jrseti/roboclaw-cm4-dc-dish-controller/README.md

# roboclaw-cm4-dc-dish-controller

A radio astronomy dish controller: a carrier board for a Raspberry Pi Compute
Module 4 (CM4) that commands a Basicmicro **RoboClaw 2x15A OEM** brushed DC motor
controller to drive the dish's azimuth and elevation motors. The board runs from a
12.8 V LiFePO4 battery that can be charged from a solar panel.

The goal is a self-contained observing system that points the dish, gathers data
and stores it for later retrieval and analysis. An SDR, such as an Airspy R2,
plugs into one USB port and an SSD into the other. The CM4 stores the samples
either raw or integrated. Both share one USB 2.0 link (about 35–40 MB/s), so raw
recording works at reduced bandwidth, such as the R2's 2.5 MSPS rate.

Data and control go through the CM4 over Ethernet. A battery-powered fiber media
converter can extend the link to the shack and isolate it electrically.

**Schematic:** [kicad/cm4-robo-controller.pdf](kicad/cm4-robo-controller.pdf)

**Simulations:** [sim/README.md](sim/README.md)

[Tomachie AI](https://tomachie.com) reviewed the schematic. Here is the [review report](tomachie/TomachieReview.pdf). Scored 100/100. Its other outputs are described in [tomachie/](tomachie/README.md).

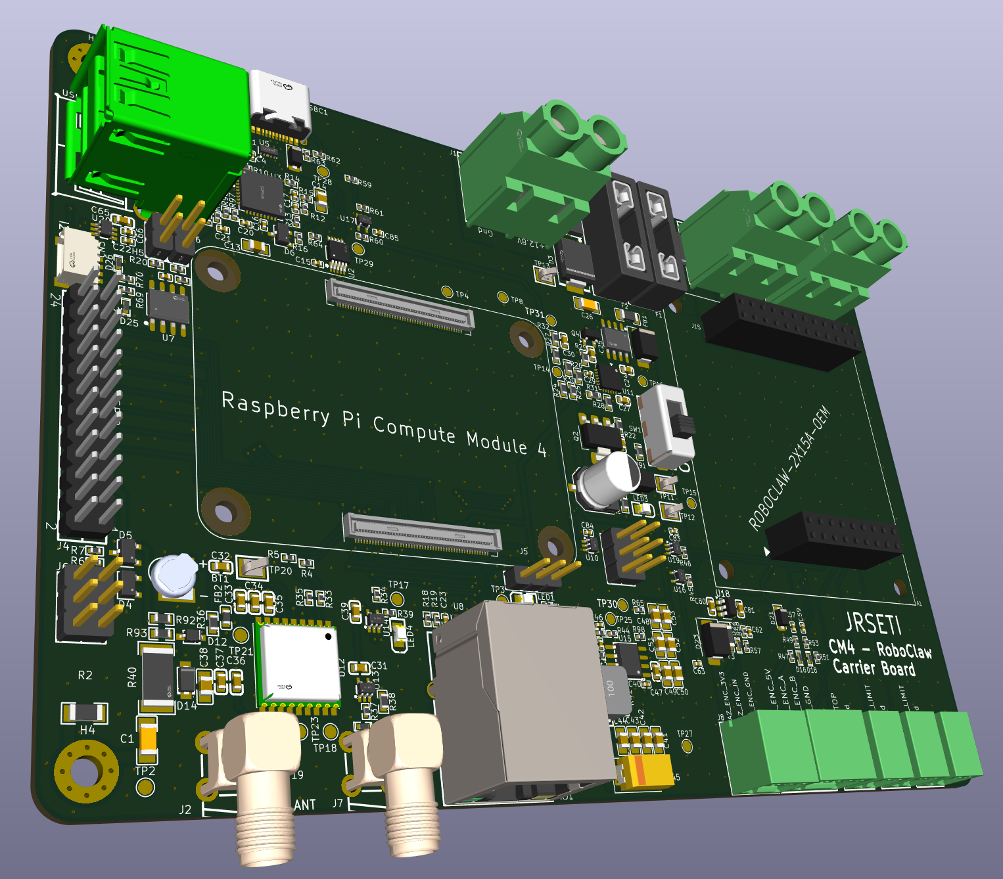
[picture p1: images/pcb-3d.png]
3D render of the controller PCB


## Overview

The board combines two modules:

- **Raspberry Pi CM4**: runs the pointing software and provides networking, USB,
  GPS timing and spare I/O. It plugs into two Hirose mezzanine connectors in the
  middle of the board.
- **RoboClaw 2x15A OEM**: a dual-channel controller for brushed DC motors (not
  brushless, stepper or servo) with closed-loop position and speed control. It
  plugs into two pin-header sockets on the right of the board. The CM4 sends it
  commands over a TTL serial link (RoboClaw packet serial).

The CM4 decides where the dish should point. The RoboClaw reads the axis sensors
and runs the motor control loops.

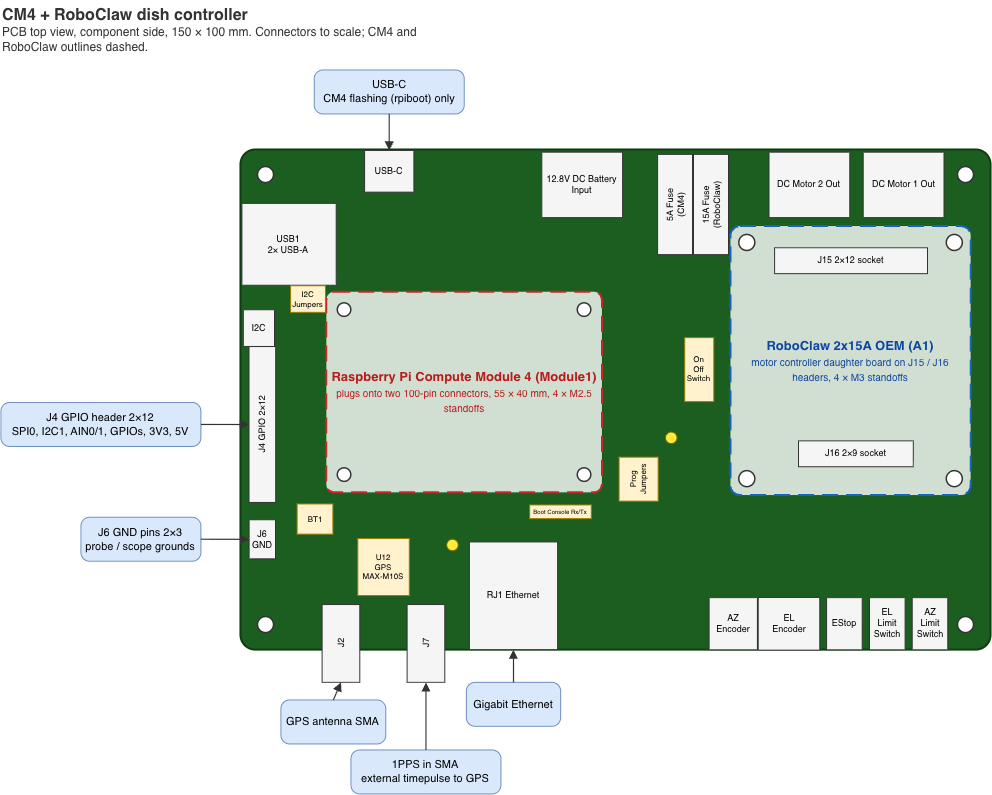
[picture p2: images/FunctionalDiagram.png]
Functional diagram


The functional diagram shows the board's layout: the CM4 on the left, the RoboClaw
on the right, and the field connections along the edges. Its source is
`drawings/FunctionalDiagram.drawio`.

## Motors and axis sensing

| Axis | Motor | Position sensor | RoboClaw input |
|---|---|---|---|
| Elevation (M1) | Firgelli F-SD-H-450-12V linear actuator (5.5 A max, 450 lb) | Built-in Hall sensors, quadrature A/B | EN1 (J8) |
| Azimuth (M2) | Bringsmart JGY-370 12 V worm-gear motor (1.8 A max) | AS5600 magnetic angle sensor, analog output | EN2 (J9) |

Both encoder channels are identical and jumper-configurable, so either axis can
use a quadrature encoder (the Firgelli Hall sensors, or an Omron E6B2-CWZ6C
open-collector encoder) or an absolute analog encoder (0–2 V at the RoboClaw).
Each 4-pin connector carries V+, A (or the analog signal), B and GND, with ESD
clamps on both signals.

| Jumper (ENC1 / ENC2) | Shunt | Setting |
|---|---|---|
| JP1 / JP4 — sensor supply (2x3, shunt across a row) | 1-2 | 5 V from the RoboClaw BEC (RC_5V) through F6 / F7, 200 mA PTC |
| | 3-4 | 3.3 V from the on-board LDO U18 (ENC_3V3) |
| | 5-6 | Battery voltage, 10–14.6 V (ENC_12V: V_MOTOR via a 350 mA PTC, SMAJ20A clamp), e.g. for an E6B2-CWZ6C |
| JP2 / JP5 — mode (2x3) | 1-3 + 2-4 | QUAD: A gets a 1k pull-up to 5 V and a 100R/10nF filter; B always does |
| | 3-5 + 4-6 | ABS: A goes to the analog node (100k/100nF); the pull-up is disconnected |
| JP3 / JP6 — ABS scaling | 1-2 | 68k/100k divider (×0.6) for a 3.3 V sensor such as the AS5600 |
| | 2-3 | 1k series, for a source that already outputs 0–2 V |

Default fit: ENC1 = 5 V, QUAD (Firgelli); ENC2 = 3.3 V, ABS, 3.3 V scaling (AS5600).

[docs/encoder-inputs.md](docs/encoder-inputs.md) explains, part by part, how the
channel handles each encoder type: the E6B2-CWZ6C's NPN open-collector outputs,
the Firgelli Hall quadrature, and an absolute 0–2 V encoder such as the AS5600.

| Elevation: Firgelli F-SD-H-450 linear actuator | Azimuth: Bringsmart JGY-370 worm-gear motor |
|:---:|:---:|
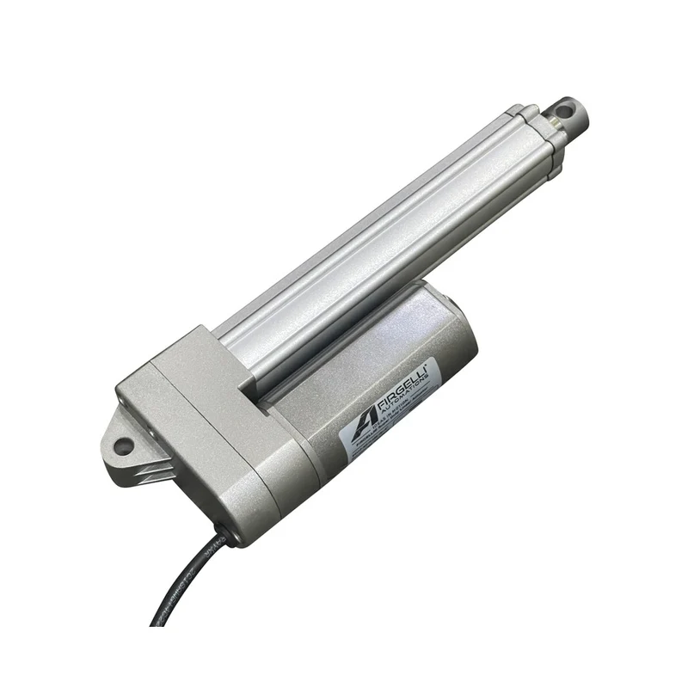
[picture p3: images/elevation_actuator.png]
Firgelli F-SD-H-450 linear actuator
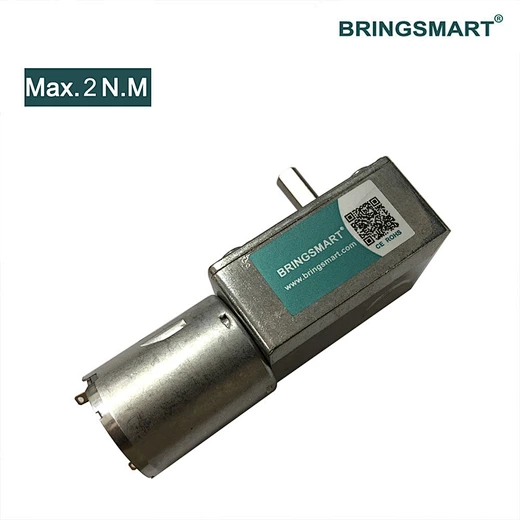
[picture p4: images/azimuth_motor.png]
Bringsmart JGY-370 worm-gear motor
|  |  |

- **Elevation:** the actuator's Hall outputs (J8, JP2 in QUAD) are pulled up to
  the sensor supply (JP1 = 5 V), ESD-protected and RC-filtered before they reach
  EN1. The count is incremental, so the axis is homed at start-up.
- **Azimuth:** the AS5600 (J9, JP5 in ABS) gives an absolute angle as a 0–3.3 V
  signal. The 68k/100k divider (JP6 1-2) scales it to the RoboClaw's 0–2 V
  absolute-encoder input, so no homing is needed.
- **Switch inputs:** E-stop (J10 → S3), elevation limit (J12 → S4) and azimuth
  limit (J13 → S5). All use normally-closed switches and have ESD protection and
  filtering. The RoboClaw has one limit input per motor but supports two switches
  on it: wire the forward and reverse NC switches in series on J12/J13 (either
  one opening trips the input), set Invert, and set S4/S5 to *Limit (Both)* or
  *Home (User)/Limit (Fwd)* — the latter also zeroes the encoder against the
  reverse-end switch, which is how the elevation axis homes. All three switch
  loops run at battery voltage (ENC_12V, 4.7k pull-up, about 2.6 mA through the
  contacts for wetting on long cables) and a 47k/20k divider brings the
  open-switch 10–14.6 V down to 3.0–4.4 V at the RoboClaw pins.
- **Motor outputs:** J11 and J14, both 7.62 mm screw terminals.

The `Motor Notes` schematic sheet describes the sensor wiring and RoboClaw setup in
detail.

## Power

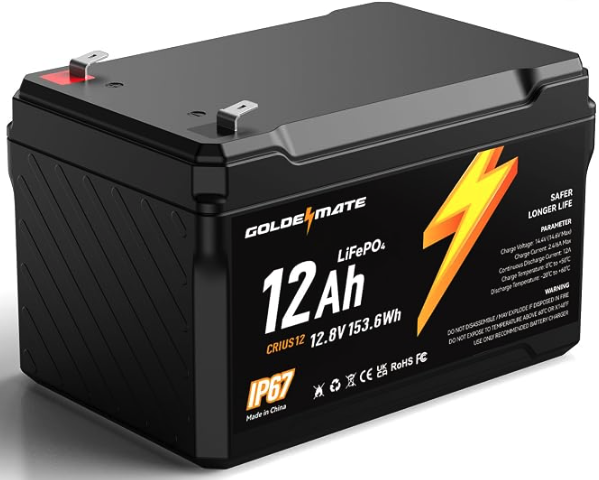
[picture p5: images/battery.png]
GoldenMate CRIUS12 12.8 V 12 Ah LiFePO4 battery


- **Input:** a 12.8 V, 12 Ah LiFePO4 battery (10.0–14.6 V) on J1, a 7.62 mm screw
  terminal. The battery is a GoldenMate CRIUS12, IP67 rated, and sits inside the
  enclosure. Its manual is in `docs/`.
- **Reverse-polarity protection:** a P-channel MOSFET (Q1) on the input blocks a
  battery connected backwards. It still conducts in both directions in normal use,
  so motor regenerative braking can return energy to the battery.
- **Fuses:** two ATO blade fuses split the supply:
  - F1 (15 A) feeds the RoboClaw motor supply (V_MOTOR).
  - F2 (5 A) feeds the logic branch.
  - D29 (SS54, 5 A Schottky, next to F1 above D1) sits across F1 as the return
    path for RoboClaw regenerative current when F1 is open, as the RoboClaw data
    sheet recommends. A fault that blows F1 pulls V_MOTOR low, so D29 cannot
    bypass the fuse.

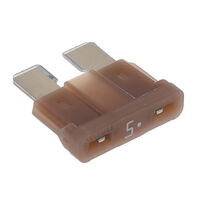
[picture p6: images/fuse.jpg]
5 A ATO automotive blade fuse
  

  These are ordinary automotive blade fuses, the kind sold for car wiring. They are
  cheap and available almost anywhere. They plug into Keystone 3557-2 holders, so a
  blown fuse can be replaced in the field without tools. The board uses Littelfuse
  0287005.PXCN (5 A) and 0287015.PXCN (15 A), but any ATO/ATC fuse of the same
  rating fits.

  Q1 is the main protection against a reversed battery. A healthy Q1 blocks the
  reverse voltage, and no fuse should blow. The fuses are the backup. If Q1 has
  failed shorted, the reversed battery drives current forward through the input TVS diodes (D1, D3) and the
  RoboClaw's internal diodes. That current passes through F1 and F2, and the fuses
  are what stop it. A blown fuse after connecting the battery therefore means:
  check the polarity, and check Q1, before you fit a new fuse.

  The fuses do not cover every reverse fault. If board ground is also connected to
  the battery's negative terminal by another route, such as a USB device or other
  equipment that shares the battery, reverse current can flow through the ground
  wiring and bypass both Q1 and the fuses. 
- **Logic supply:** the logic branch goes through a hot-swap eFuse (U11), a power
  switch (SW1) and a 5 A buck converter (U15). The buck makes 5 V for the CM4 and the
  USB ports. The CM4's own 3.3 V output powers the 3.3 V logic.
- **SW1 is not a battery disconnect.** It switches the CM4 and logic supply only.
  With SW1 off the board still draws about 31 mA from the battery: about 30 mA for
  the RoboClaw's logic, which runs straight from V_MOTOR, plus about 1.3 mA for U11
  and its dividers. A full 12 Ah battery runs flat in about 16 days. For storage or
  transport, unplug J1 (or pull F1 and F2), and charge the battery first. A LiFePO4
  battery left at its BMS cutoff for months loses capacity.
- **Grounding:**
  - Motor return current stays on a separate ground (PGND). It joins the logic
    ground at a single point (NT1) next to the battery terminal.
  - Connector shields and mounting holes go to CHASSIS, which is bled to ground
    through 1 MΩ in parallel with 4.7 nF.
  - Once installed, GND is bonded to the utility box at the J2 antenna
    arrestor, the only intended GND-to-box connection. Battery negative
    already reaches the box through the board this way, so neither it nor
    the negative of anything else on the battery may have any other
    connection to the box or the mounting plate.
  - The optional FE-5680A rubidium reference (1PPS into J7) is mounted
    isolated from the plate and powered through an isolated DC-DC
    converter, so its only connection to the board is the J7 coax shield.
  - The SDR's antenna coax shield reaches board GND through its USB cable. Bring
    that coax in next to the J2 arrestor, or isolate its shield from the box, so
    it does not make a second GND-to-box bond.

## CM4 interfaces

- **Ethernet:** gigabit RJ45 with integrated magnetics. The PHY is on the CM4.
- **USB:**
  - A USB2514B hub drives a dual USB-A port, with current limiting and ESD
    protection. The hub's ports 3 and 4 are not used and are disabled by strap.
  - A USB mux switches the CM4's USB port to the USB-C connector for `rpiboot`
    (OTG programming of the eMMC).
- **GPS:**
  - A u-blox MAX-M10S receiver provides UTC time and a 1PPS pulse. Its antenna
    connects to an SMA jack, and a coin cell backs up the receiver for fast restarts.
  - A second SMA input accepts an external 1PPS reference, such as an FE-5680A
    rubidium clock.
- **GPIO header (J4):** spare CM4 GPIOs and two protected analog inputs. The
  3.3 V on pin 5 is fused at 100 mA (F9); the 5 V on pin 7 is not.
  Two on-axis E6B2-CWZ6C encoders can be read here, see
  [On-axis encoders on J4](docs/encoder-inputs.md#on-axis-encoders-on-j4-cm4).
  H7, an M2.5 hole next to J4, secures a plug-on HAT board; see
  [Mounting a HAT board on J4](docs/encoder-inputs.md#mounting-a-hat-board-on-j4).
- **Jumpers:** boot control, EEPROM write protect and self power-cycle.
- **Boot console UART (J5):** a serial console on the CM4's UART0. See below.

### Boot console UART (J5)

J5 is a 3-pin, 2.54 mm header that brings out the CM4's UART0. It shows bootloader
and Linux boot messages and gives a login prompt. That makes it the way into the
board when the network is down or the CM4 won't boot.

| J5 pin | Signal | Connect to the adapter's |
|---|---|---|
| 1 | BOOT_CONSOLE_RXD (GPIO15, CM4 receives) | TXD |
| 2 | BOOT_CONSOLE_TXD (GPIO14, CM4 transmits) | RXD |
| 3 | GND | GND |

TX and RX cross over: the adapter's TXD goes to the CM4's RXD.

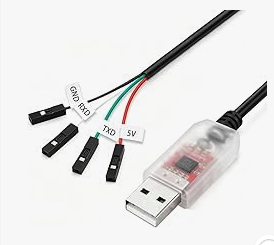
[picture p7: images/TTL-Serial-cable.png]
USB to TTL serial cable with four female jumper leads


Any inexpensive USB-to-TTL serial cable works. Cables like the one shown, based on
the PL2303, CP2102 or FTDI chips, cost a few dollars on Amazon. They usually have
four female jumper leads: black GND, white RXD, green TXD and red 5V. Check the
labels on your cable.

- **Do not connect the red 5V lead.** The board powers itself, and J5 has no 5 V
  pin. A loose 5 V lead can short against the header or the board, so it's best
  to cut it off, or at least insulate it.
- **Use a cable with 3.3 V signals.** The CM4's GPIOs are not 5 V tolerant. Before
  connecting, check with a meter that the adapter's TXD idles at about 3.3 V.
- **Settings:** 115200 baud, 8N1, no flow control.
- **Enabling the console:**
  - For the Linux console, add `enable_uart=1` to `config.txt`. Raspberry Pi OS
    already puts `console=serial0,115200` in `cmdline.txt`.
  - For bootloader messages, set `BOOT_UART=1` in the EEPROM config with
    `rpi-eeprom-config`.

### Recommended CM4

Use a **CM4 without wireless and with eMMC**, for example `CM4004032` (4 GB RAM,
32 GB eMMC) or `CM4004016` (16 GB eMMC).

- The board has no SD-card slot, so a CM4 Lite (part numbers ending `000`) cannot
  boot on it.
- On a wireless CM4, Bluetooth takes UART0, which this board uses.

## Board

- 4-layer PCB, 150 × 90 mm, with four M3 mounting holes.
- Assembled on one side by JLCPCB. Parts carry LCSC part numbers. The RoboClaw
  (A1) and the CM4 (A2) are DNP: bought separately and fitted by hand. The two
  Hirose DF40 receptacles under the CM4 are J17/J18, BOM and placement entries
  only, since their pads are part of the CM4 footprint.
- The RoboClaw sits in sockets (J15/J16) so it can be removed. Nothing is placed
  under the CM4 or the RoboClaw.
- The inner layers are planes:
  - In1.Cu is ground, split into logic GND and PGND.
  - In2.Cu carries power: +5 V on the logic side, V_MOTOR on the RoboClaw side.

## Status

The schematic is complete. PCB placement and plane layout are done, and routing is
in progress. The software has not been started yet.

## Repository layout

| Path | Contents |
|---|---|
| `kicad/` | KiCad 10 project: schematic sheets and PCB |
| `parts/` | Git submodule ([jrseti/parts](https://github.com/jrseti/parts)): the `MyParts` symbol, footprint and 3D-model library, its datasheets, and `add.py` for importing LCSC parts |
| `docs/` | Component datasheets and design notes |
| `drawings/` | Draw.io source for the functional diagram |
| `tomachie/` | Tomachie schematic review: report PDF, BOM, netlist, power tree and marked-up sheets ([README](tomachie/README.md)) |
| `images/` | Images used in this README |
| `software/` | CM4 software (not yet started) |

### Cloning

`parts/` is a submodule, and the KiCad project needs it to find its symbols,
footprints and 3D models. Clone with:

```sh
git clone --recurse-submodules https://github.com/jrseti/roboclaw-cm4-dc-dish-controller.git
```

If you have already cloned the repository, run `git submodule update --init` to
fetch it.

KiCad finds the library through two path variables. Set them in
**Preferences → Configure Paths**:

| Variable | Value |
|---|---|
| `MYPARTS` | `<clone>/parts` |
| `MYPARTS_DATASHEETS` | `<clone>/parts/datasheets` |

## License

MIT. See [LICENSE](LICENSE).
