jrseti/roboclaw-cm4-dc-dish-controller/sim/power/README.md

# Power-sheet simulations (ngspice)

Test circuits for the logic power path on the power sheet (`kicad/power.kicad_sch`):
- the U11 eFuse (MX26631DL) with its UVLO, OVP and PGOOD dividers;
- the Q3/Q4 reverse-current blocking FETs;
- the SW1/Q2 power switch, with its slow turn-on (R22, R91, C82), and the 12V rail.

The battery and battery-input stage feed it. The U15 buck is modelled as a
load; [../power-5v](../power-5v) covers it in detail. The write-up is
[../power.md](../power.md).

```sh
brew install ngspice
./run.sh                 # writes results/*.log and results/*.dat
python3 plot.py          # needs matplotlib; writes results/*.png
python3 circuit.py       # needs schemdraw; writes results/circuit.png
```

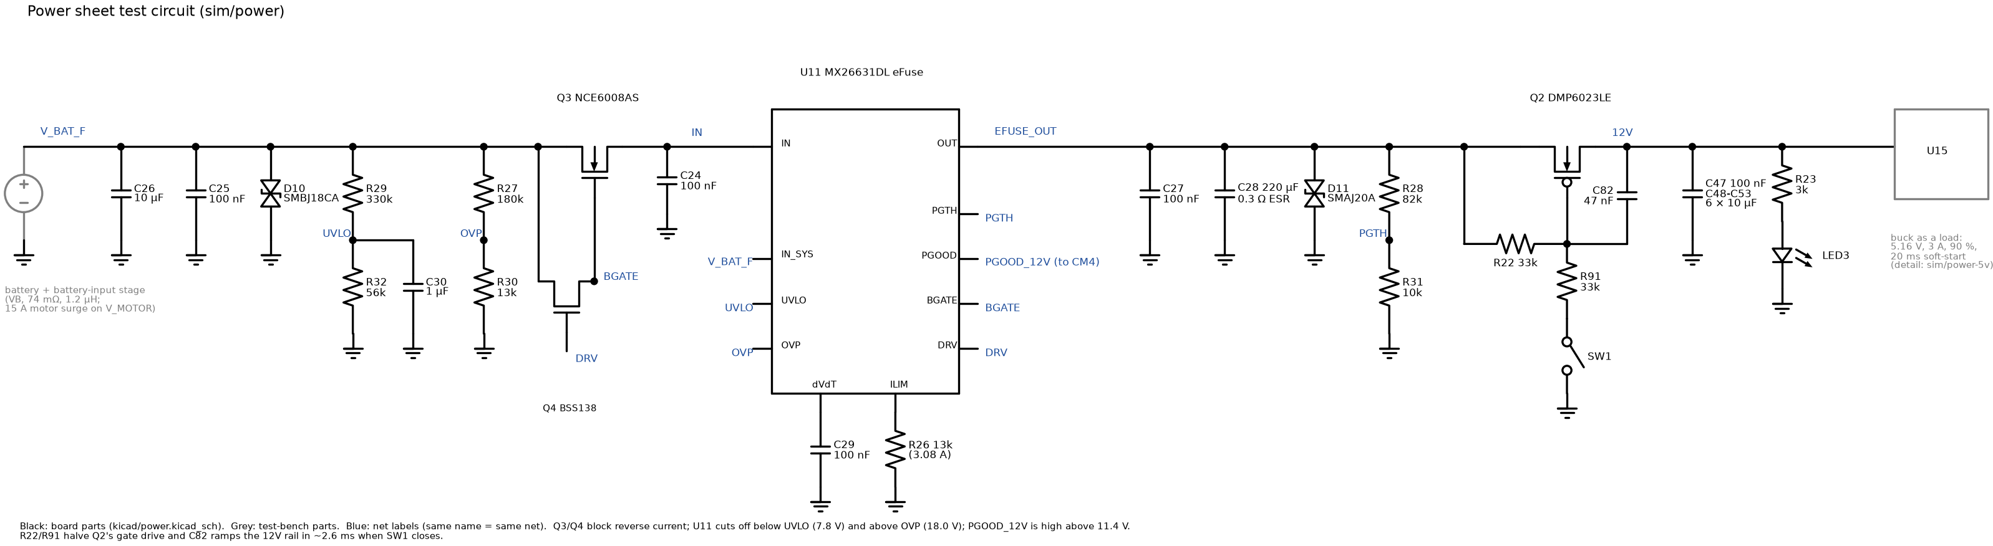
[picture p10: sim/power/results/circuit.png]
Test circuit


| File | Contents |
|---|---|
| `models.lib` | MOSFET and TVS models, a behavioural U11 eFuse (`MX26631`) and the buck-as-a-load (`BUCKLOAD`) |
| `board.inc` | The power-sheet netlist, shared by every test. `QSOFT=1` is the board as built (R22 33k, R91 33k, C82 47 nF); `QSOFT=0` is the earlier design, kept for comparison. |
| `source.inc` | Battery, cable and battery-input stage feeding V_BAT_F, plus the RoboClaw motor current |
| `startup.cir` | A full battery plugged in with SW1 already on |
| `sw1.cir` | SW1 switched on with U11 already up, earlier design and as built |
| `brownout.cir` | A 15 A, 300 ms motor surge at battery voltages of 12.8, 12.0 and 11.4 V |
| `ovp.cir` | The battery rail held at 21.5 V for 100 ms (braking with the BMS open), then released. Also measures Q2's gate-source voltage, earlier design and as built. |
| `circuit.py` | Draws the circuit above |

**Assumptions:**
- Battery: 25 mΩ. Cable: 17 mΩ and 1 µH. Q1: 5 mΩ. F2: 17 mΩ. FB1: 9 mΩ.
- C26 is derated to 5 µF. C48–C53 are derated to 5 µF each.
- C28 is 220 µF with 0.3 Ω ESR (assumed; the datasheet gives no ESR).
- The buck load is 5.16 V at 3 A, 90 % efficient, with a 20 ms soft-start.
- RoboClaw input capacitance: 470 µF.

**The U11 model** reproduces the datasheet's thresholds, delays, dV/dt
ramp, current limit (3.08 A), PGOOD deglitch and reverse blocking.

It doesn't model:
- thermal shutdown;
- the 1.5 × IOL fast trip. The model clamps the current at IOL instead, and
  reports what the load is asking for as `xu11.idem`.

## Results

| Test | Result |
|---|---|
| Start-up | UVLO trips 50 ms after plug-in (C30 filter). U11 turns on 9 ms later and EFUSE_OUT ramps at 0.53 V/ms. PGOOD goes high at 81 ms, 5V is in regulation at 88 ms. The eFuse current never exceeds the 1.4 A load. |
| SW1 on, earlier design | Q2 surges to 63 A (above its 50 A pulse rating), EFUSE_OUT dips to 4.3 V and is below the PGOOD threshold for 17 µs, so PGOOD drops for 2 ms. The load asks U11 for far more than 1.5 × IOL, so a real U11 would fast-trip. |
| SW1 on, as built | With R22 33k, R91 33k in series with SW1 and C82 47 nF gate-to-drain, the surge is 1.4 A, EFUSE_OUT doesn't move, and PGOOD stays high. The 12V rail rises in 2.6 ms. |
| Brownout | During a 15 A surge, EFUSE_OUT falls about 0.9 V. PGOOD stays high at 12.8 V and 12.0 V. At 11.4 V it never comes up, because EFUSE_OUT (11.2 V) is below the 11.41 V rising threshold. |
| OVP | U11 cuts off within microseconds of the rail passing 17.96 V. The 5V rail falls below 4.75 V 1.8 ms later, so the CM4 resets. It's back 35 ms after the rail drops below 16.78 V. Q2's gate-source voltage peaks at −7.8 V as built (R22/R91 halve it), against −17.8 V for the earlier design; the rating is ±20 V. |
