jrseti/roboclaw-cm4-dc-dish-controller/docs/drawings/board_overview.png

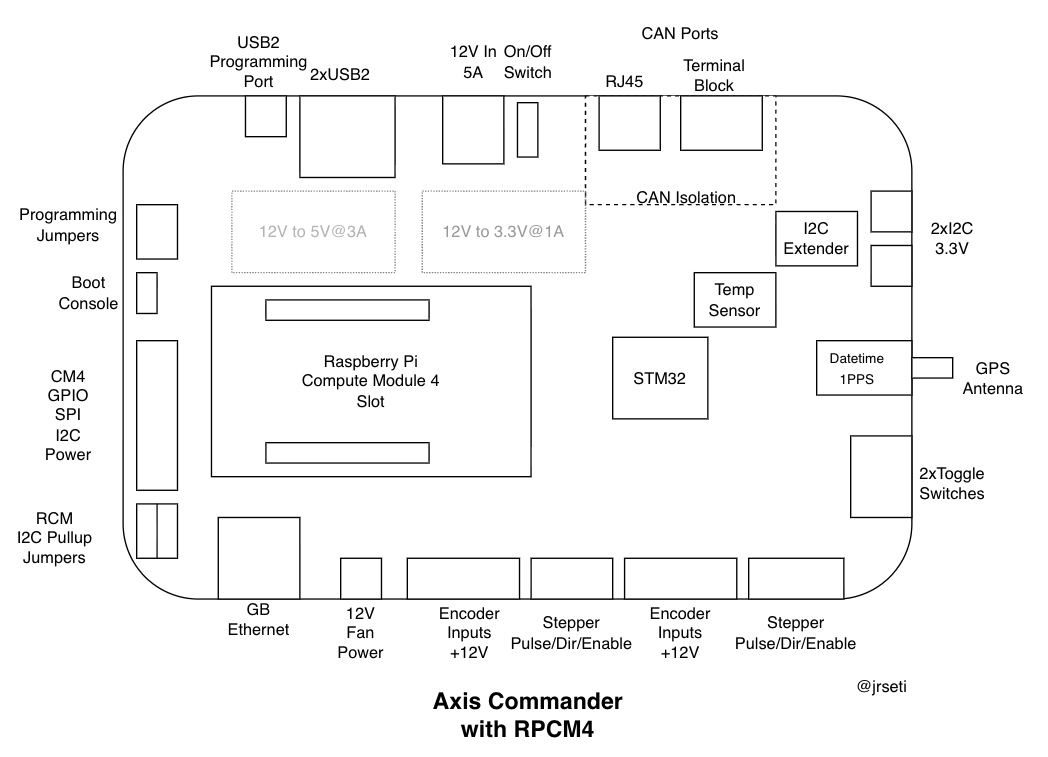
docs/drawings/board_overview.png
