jrseti/roboclaw-cm4-dc-dish-controller/docs/drawings/board_overview_colors.png

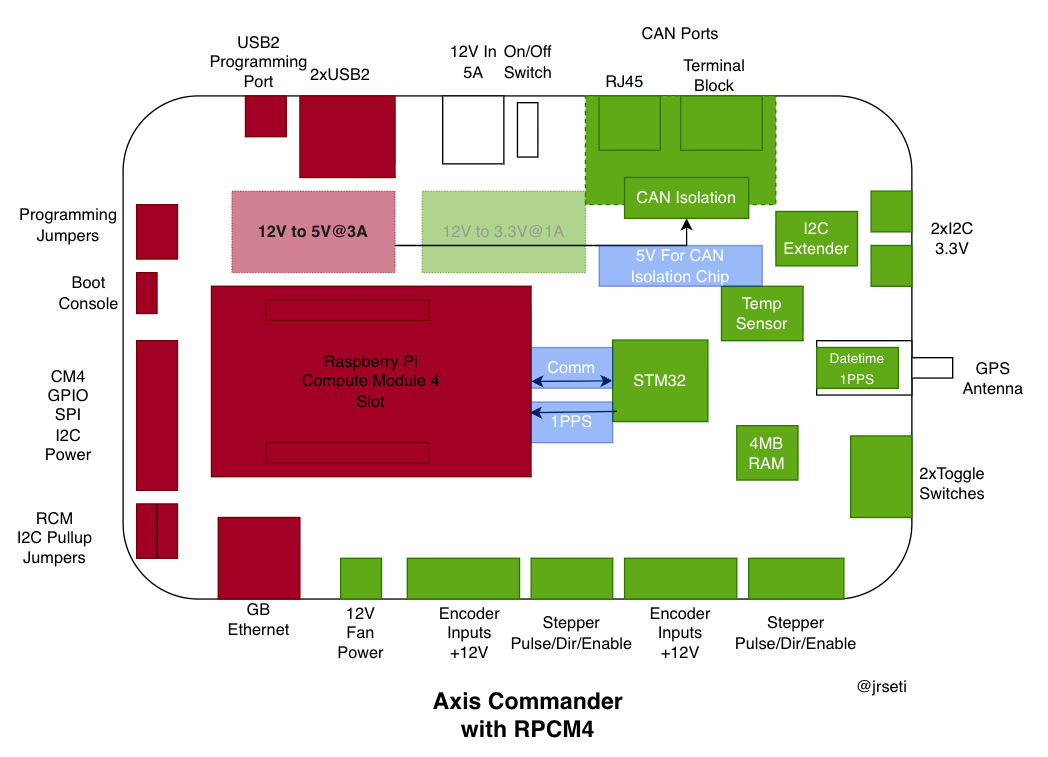
docs/drawings/board_overview_colors.png
