jrseti/roboclaw-cm4-dc-dish-controller/docs/drawings/encoder_CAN.png

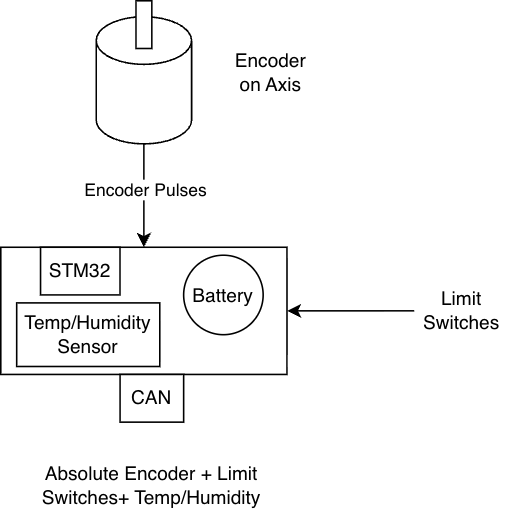
docs/drawings/encoder_CAN.png
