jrseti/roboclaw-cm4-dc-dish-controller/docs/drawings/rcm_dish_controller_1.png

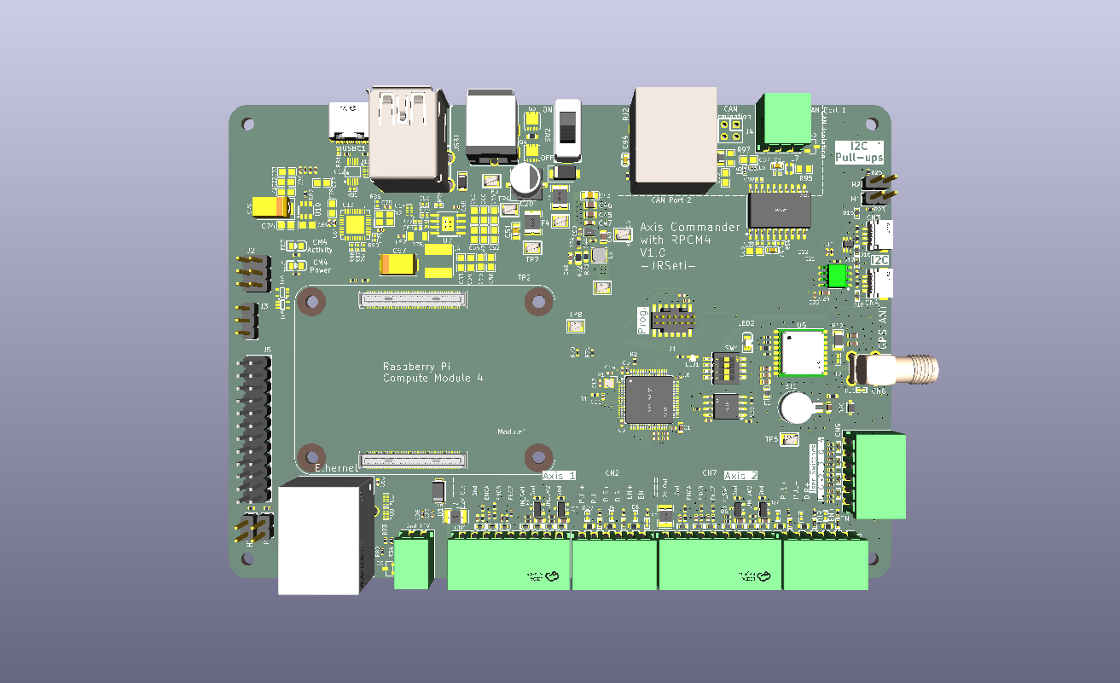
docs/drawings/rcm_dish_controller_1.png
