jrseti/roboclaw-cm4-dc-dish-controller/docs/ring_holder_1_v6.step

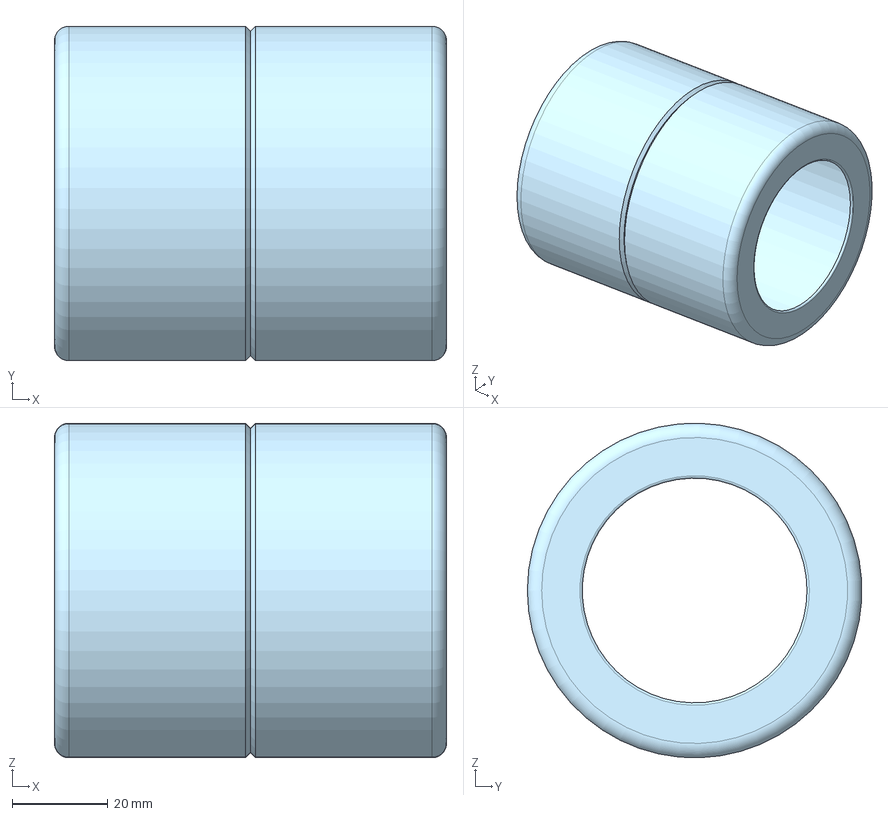
[picture p35: CAD file, 2026-10-09]
docs/ring_holder_1_v6.step
82.0 x 69.9 x 70.0 mm
