jrseti/roboclaw-cm4-dc-dish-controller/docs/ring_holder_1_v5.step

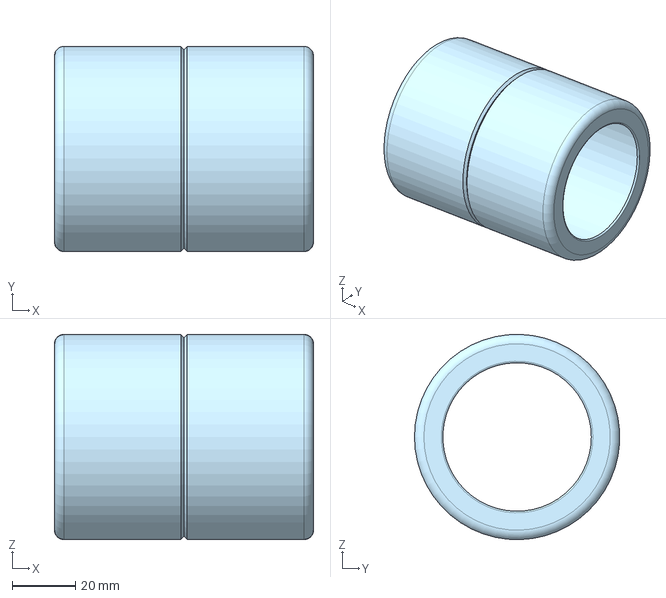
[picture p36: CAD file, 2026-10-09]
docs/ring_holder_1_v5.step
82.0 x 64.9 x 65.0 mm
