jrseti/roboclaw-cm4-dc-dish-controller/kicad/cm4-robo-controller.kicad_pcb

## KiCad design kicad/cm4-robo-controller.kicad_pcb (2026-11-11)

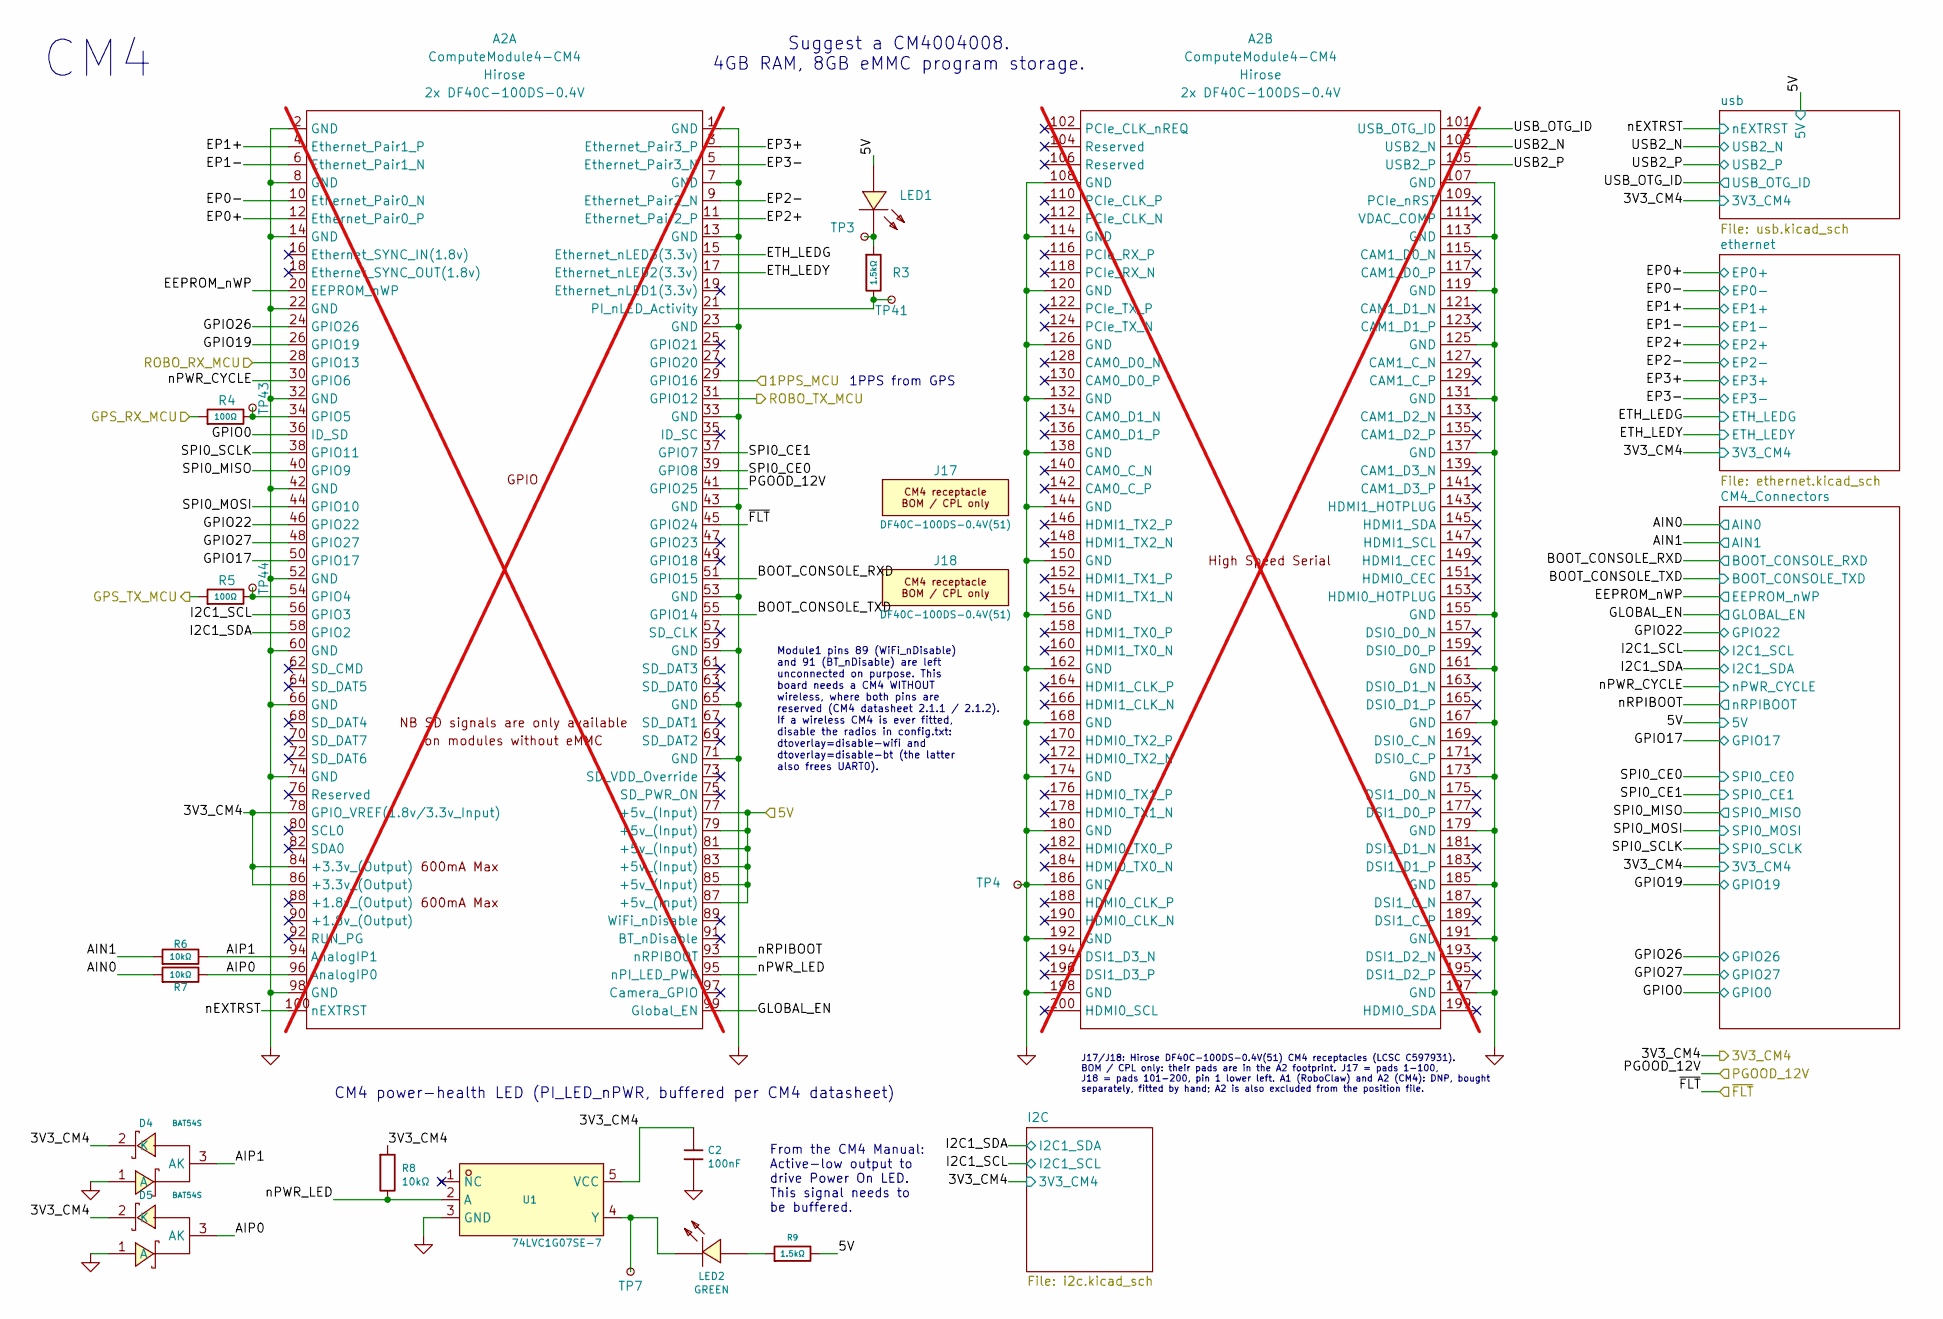
[picture p52: schematic RCM4.kicad_sch]

Parts:
A2: ComputeModule4-CM4; Raspberry-Pi-4-Compute-Module; MPN CM4004008; not fitted
C2: 100nF; CAPC1005X55N; Tolerance ±10%; Voltage Rating 16V; MPN CL05B104KO5NNNC; LCSC Part C1525
D4, D5: BAT54S; SOT95P280X110-3N; MPN BAT54S,215; LCSC Part C47546
J17, J18: DF40C-100DS-0.4V(51); DF40C-100DS-0.4V_BOM-ONLY; MPN DF40C-100DS-0.4V(51); LCSC Part C597931
LED1: GREEN; LEDC2012X110N; MPN KT-0805G; LCSC Part C2297
LED2: GREEN; LEDC2012X110N; MPN KT-0805R; LCSC Part C2295
R3, R9: 1.5kΩ; RESC1005X40N; Tolerance ±1%; Voltage Rating 50V; MPN 0402WGF1501TCE; LCSC Part C25867
R4, R5: 100Ω; RESC1005X40N; Tolerance ±1%; Voltage Rating 50V; MPN 0402WGF1000TCE; LCSC Part C25076
R6, R7, R8: 10kΩ; RESC1005X40N; Tolerance ±1%; Voltage Rating 50V; MPN 0402WGF1002TCE; LCSC Part C25744
TP3, TP4, TP7, TP41, TP43, TP44: TestPoint_Small; TestPoint_Pad_D0.8mm
U1: 74LVC1G07SE-7; SOT65P210X110-5N; MPN 74LVC1G07SE-7; LCSC Part C67531

Connections:
/3V3_CM4: A2.78 (GPIO_VREF(1.8v/3.3v_Input)), A2.84 (+3.3v_(Output)), A2.86 (+3.3v_(Output)), C2.1, D4.2 (K), D5.2 (K), R8.1, U1.5 (VCC); also elsewhere on the board
/5V: A2.77 (+5v_(Input)), A2.79 (+5v_(Input)), A2.81 (+5v_(Input)), A2.83 (+5v_(Input)), A2.85 (+5v_(Input)), A2.87 (+5v_(Input)), LED1.1 (A), R9.2; also elsewhere on the board
/CM4/1PPS_MCU: A2.29 (GPIO16); also elsewhere on the board
/CM4/AIN0: R7.1; also elsewhere on the board
/CM4/AIN1: R6.1; also elsewhere on the board
/CM4/AIP0: A2.96 (AnalogIP0), D5.3 (AK), R7.2
/CM4/AIP1: A2.94 (AnalogIP1), D4.3 (AK), R6.2
/CM4/BOOT_CONSOLE_RXD: A2.51 (GPIO15); also elsewhere on the board
/CM4/BOOT_CONSOLE_TXD: A2.55 (GPIO14); also elsewhere on the board
/CM4/EEPROM_nWP: A2.20 (EEPROM_nWP); also elsewhere on the board
/CM4/EP0+: A2.12 (Ethernet_Pair0_P); also elsewhere on the board
/CM4/EP0-: A2.10 (Ethernet_Pair0_N); also elsewhere on the board
/CM4/EP1+: A2.4 (Ethernet_Pair1_P); also elsewhere on the board
/CM4/EP1-: A2.6 (Ethernet_Pair1_N); also elsewhere on the board
/CM4/EP2+: A2.11 (Ethernet_Pair2_P); also elsewhere on the board
/CM4/EP2-: A2.9 (Ethernet_Pair2_N); also elsewhere on the board
/CM4/EP3+: A2.3 (Ethernet_Pair3_P); also elsewhere on the board
/CM4/EP3-: A2.5 (Ethernet_Pair3_N); also elsewhere on the board
/CM4/ETH_LEDG: A2.15 (Ethernet_nLED3(3.3v)); also elsewhere on the board
/CM4/ETH_LEDY: A2.17 (Ethernet_nLED2(3.3v)); also elsewhere on the board
/CM4/GLOBAL_EN: A2.99 (Global_EN); also elsewhere on the board
/CM4/GPIO0: A2.36 (ID_SD); also elsewhere on the board
/CM4/GPIO17: A2.50 (GPIO17); also elsewhere on the board
/CM4/GPIO19: A2.26 (GPIO19); also elsewhere on the board
/CM4/GPIO22: A2.46 (GPIO22); also elsewhere on the board
/CM4/GPIO26: A2.24 (GPIO26); also elsewhere on the board
/CM4/GPIO27: A2.48 (GPIO27); also elsewhere on the board
/CM4/GPS_RX_MCU: R4.1; also elsewhere on the board
/CM4/GPS_TX_MCU: R5.1; also elsewhere on the board
/CM4/I2C1_SCL: A2.56 (GPIO3); also elsewhere on the board
/CM4/I2C1_SDA: A2.58 (GPIO2); also elsewhere on the board
/CM4/PGOOD_12V: A2.41 (GPIO25); also elsewhere on the board
/CM4/ROBO_RX_MCU: A2.28 (GPIO13); also elsewhere on the board
/CM4/ROBO_TX_MCU: A2.31 (GPIO12); also elsewhere on the board
/CM4/SPI0_CE0: A2.39 (GPIO8); also elsewhere on the board
/CM4/SPI0_CE1: A2.37 (GPIO7); also elsewhere on the board
/CM4/SPI0_MISO: A2.40 (GPIO9); also elsewhere on the board
/CM4/SPI0_MOSI: A2.44 (GPIO10); also elsewhere on the board
/CM4/SPI0_SCLK: A2.38 (GPIO11); also elsewhere on the board
/CM4/USB2_N: A2.103 (USB2_N); also elsewhere on the board
/CM4/USB2_P: A2.105 (USB2_P); also elsewhere on the board
/CM4/USB_OTG_ID: A2.101 (USB_OTG_ID); also elsewhere on the board
/CM4/nEXTRST: A2.100 (nEXTRST); also elsewhere on the board
/CM4/nPWR_CYCLE: A2.30 (GPIO6); also elsewhere on the board
/CM4/nPWR_LED: A2.95 (nPI_LED_PWR), R8.2, U1.2 (A)
/CM4/nRPIBOOT: A2.93 (nRPIBOOT); also elsewhere on the board
/CM4/~FLT: A2.45 (GPIO24); also elsewhere on the board
GND: A2.1 (GND), A2.2 (GND), A2.7 (GND), A2.8 (GND), A2.13 (GND), A2.14 (GND), A2.22 (GND), A2.23 (GND), A2.32 (GND), A2.33 (GND), A2.42 (GND), A2.43 (GND), A2.52 (GND), A2.53 (GND), A2.59 (GND), A2.60 (GND), A2.65 (GND), A2.66 (GND), A2.71 (GND), A2.74 (GND), A2.98 (GND), A2.107 (GND), A2.108 (GND), A2.113 (GND), A2.114 (GND), A2.119 (GND), A2.120 (GND), A2.125 (GND), A2.126 (GND), A2.131 (GND), A2.132 (GND), A2.137 (GND), A2.138 (GND), A2.144 (GND), A2.150 (GND), A2.155 (GND), A2.156 (GND), A2.161 (GND), A2.162 (GND), A2.167 (GND), A2.168 (GND), A2.173 (GND), A2.174 (GND), A2.179 (GND), A2.180 (GND), A2.185 (GND), A2.186 (GND), A2.191 (GND), A2.192 (GND), A2.197 (GND), A2.198 (GND), C2.2, D4.1 (A), D5.1 (A), TP4.1 (1_1), U1.3 (GND); also elsewhere on the board
unnamed: A2.54 (GPIO4), R5.2, TP44.1 (1_1)
unnamed: A2.34 (GPIO5), R4.2, TP43.1 (1_1)
unnamed: A2.21 (PI_nLED_Activity), R3.2, TP41.1 (1_1)
unnamed: LED1.2 (K), R3.1, TP3.1 (1_1)
unnamed: LED2.1 (A), R9.1
unnamed: LED2.2 (K), TP7.1 (1_1), U1.4 (Y)

Notes on the sheet:
CM4 power-health LED (PI_LED_nPWR, buffered per CM4 datasheet)
J17/J18: Hirose DF40C-100DS-0.4V(51) CM4 receptacles (LCSC C597931). BOM / CPL only: their pads are in the A2 footprint. J17 = pads 1-100, J18 = pads 101-200, pin 1 lower left. A1 (RoboClaw) and A2 (CM4): DNP, bought separately, fitted by hand; A2 is also excluded from the position file.
Module1 pins 89 (WiFi_nDisable) and 91 (BT_nDisable) are left unconnected on purpose. This board needs a CM4 WITHOUT wireless, where both pins are reserved (CM4 datasheet 2.1.1 / 2.1.2). If a wireless CM4 is ever fitted, disable the radios in config.txt: dtoverlay=disable-wifi and dtoverlay=disable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
CM4
Suggest a CM4004008. 4GB RAM, 8GB eMMC program storage.
From the CM4 Manual: Active-low output to drive Power On LED. This signal needs to be buffered.
1PPS from GPS

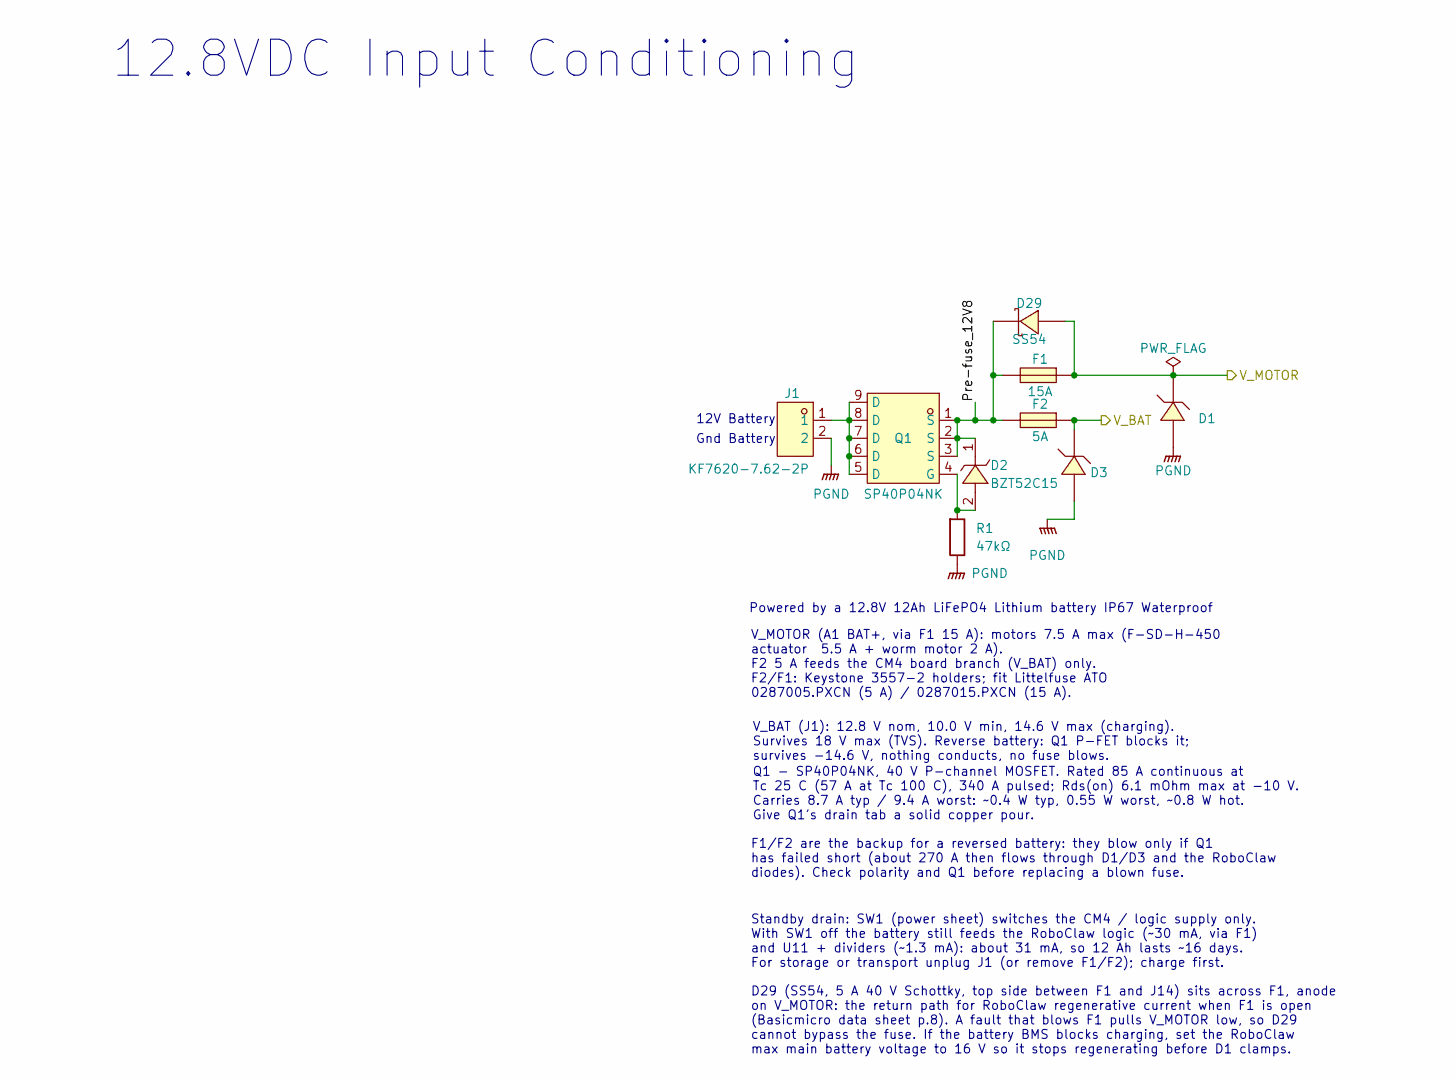
[picture p53: schematic battery-input.kicad_sch, Battery Input]

Parts:
D1, D3: SMCJ18A_C53260906; DIOM7959X262N; MPN SMCJ18A; LCSC Part C53260906
D2: BZT52C15; SOD3716X135N; MPN BZT52C15; LCSC Part C19077412
D29: SS54; DIOM5226X244N; MPN SS54; LCSC Part C22452
F1: 15A; FUSE-TH_4P-L19.8-W6.7_3557-2; Voltage Rating 32VDC; Interrupting Rating 1000A @ 32VDC; MPN 3557-2; LCSC Part C352820
F2: 5A; FUSE-TH_4P-L19.8-W6.7_3557-2; Voltage Rating 32VDC; Interrupting Rating 1000A @ 32VDC; MPN 3557-2; LCSC Part C352820
J1: KF7620-7.62-2P; CONN-TH_P7.62_KF7620-7.62-2P; MPN KF7620-7.62-2P; LCSC Part C475104
Q1: SP40P04NK; SON127P600X500X110-9N; MPN SP40P04NK; LCSC Part C41355035
R1: 47kΩ; RESC1005X40N; Tolerance ±1%; Voltage Rating 50V; MPN 0402WGF4702TCE; LCSC Part C25792

Connections:
/Robo/V_MOTOR: D1.1 (C), D29.2 (A), F1.1, F1.2; also elsewhere on the board
/battery-input/Pre-fuse_12V8: D2.1 (K), D29.1 (K), F1.3, F1.4, F2.3, F2.4, Q1.1 (S), Q1.2 (S), Q1.3 (S)
/battery-input/V_BAT: D3.1 (C), F2.1, F2.2; also elsewhere on the board
unnamed: D2.2 (A), Q1.4 (G), R1.1
unnamed: J1.1, Q1.5 (D), Q1.6 (D), Q1.7 (D), Q1.8 (D), Q1.9 (D)
PGND: D1.2 (A), D3.2 (A), J1.2, R1.2; also elsewhere on the board

Notes on the sheet:
Gnd Battery
12.8VDC Input Conditioning
V_MOTOR (A1 BAT+, via F1 15 A): motors 7.5 A max (F-SD-H-450 actuator 5.5 A + worm motor 2 A). F2 5 A feeds the CM4 board branch (V_BAT) only. F2/F1: Keystone 3557-2 holders; fit Littelfuse ATO 0287005.PXCN (5 A) / 0287015.PXCN (15 A).
12V Battery
D29 (SS54, 5 A 40 V Schottky, top side between F1 and J14) sits across F1, anode on V_MOTOR: the return path for RoboClaw regenerative current when F1 is open (Basicmicro data sheet p.8). A fault that blows F1 pulls V_MOTOR low, so D29 cannot bypass the fuse. If the battery BMS blocks charging, set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
Standby drain: SW1 (power sheet) switches the CM4 / logic supply only. With SW1 off the battery still feeds the RoboClaw logic (~30 mA, via F1) and U11 + dividers (~1.3 mA): about 31 mA, so 12 Ah lasts ~16 days. For storage or transport unplug J1 (or remove F1/F2); charge first.
V_BAT (J1): 12.8 V nom, 10.0 V min, 14.6 V max (charging). Survives 18 V max (TVS). Reverse battery: Q1 P-FET blocks it; survives -14.6 V, nothing conducts, no fuse blows.
F1/F2 are the backup for a reversed battery: they blow only if Q1 has failed short (about 270 A then flows through D1/D3 and the RoboClaw diodes). Check polarity and Q1 before replacing a blown fuse.
Powered by a 12.8V 12Ah LiFePO4 Lithium battery IP67 Waterproof
Q1 - SP40P04NK, 40 V P-channel MOSFET. Rated 85 A continuous at Tc 25 C (57 A at Tc 100 C), 340 A pulsed; Rds(on) 6.1 mOhm max at -10 V. Carries 8.7 A typ / 9.4 A worst: ~0.4 W typ, 0.55 W worst, ~0.8 W hot. Give Q1's drain tab a solid copper pour.

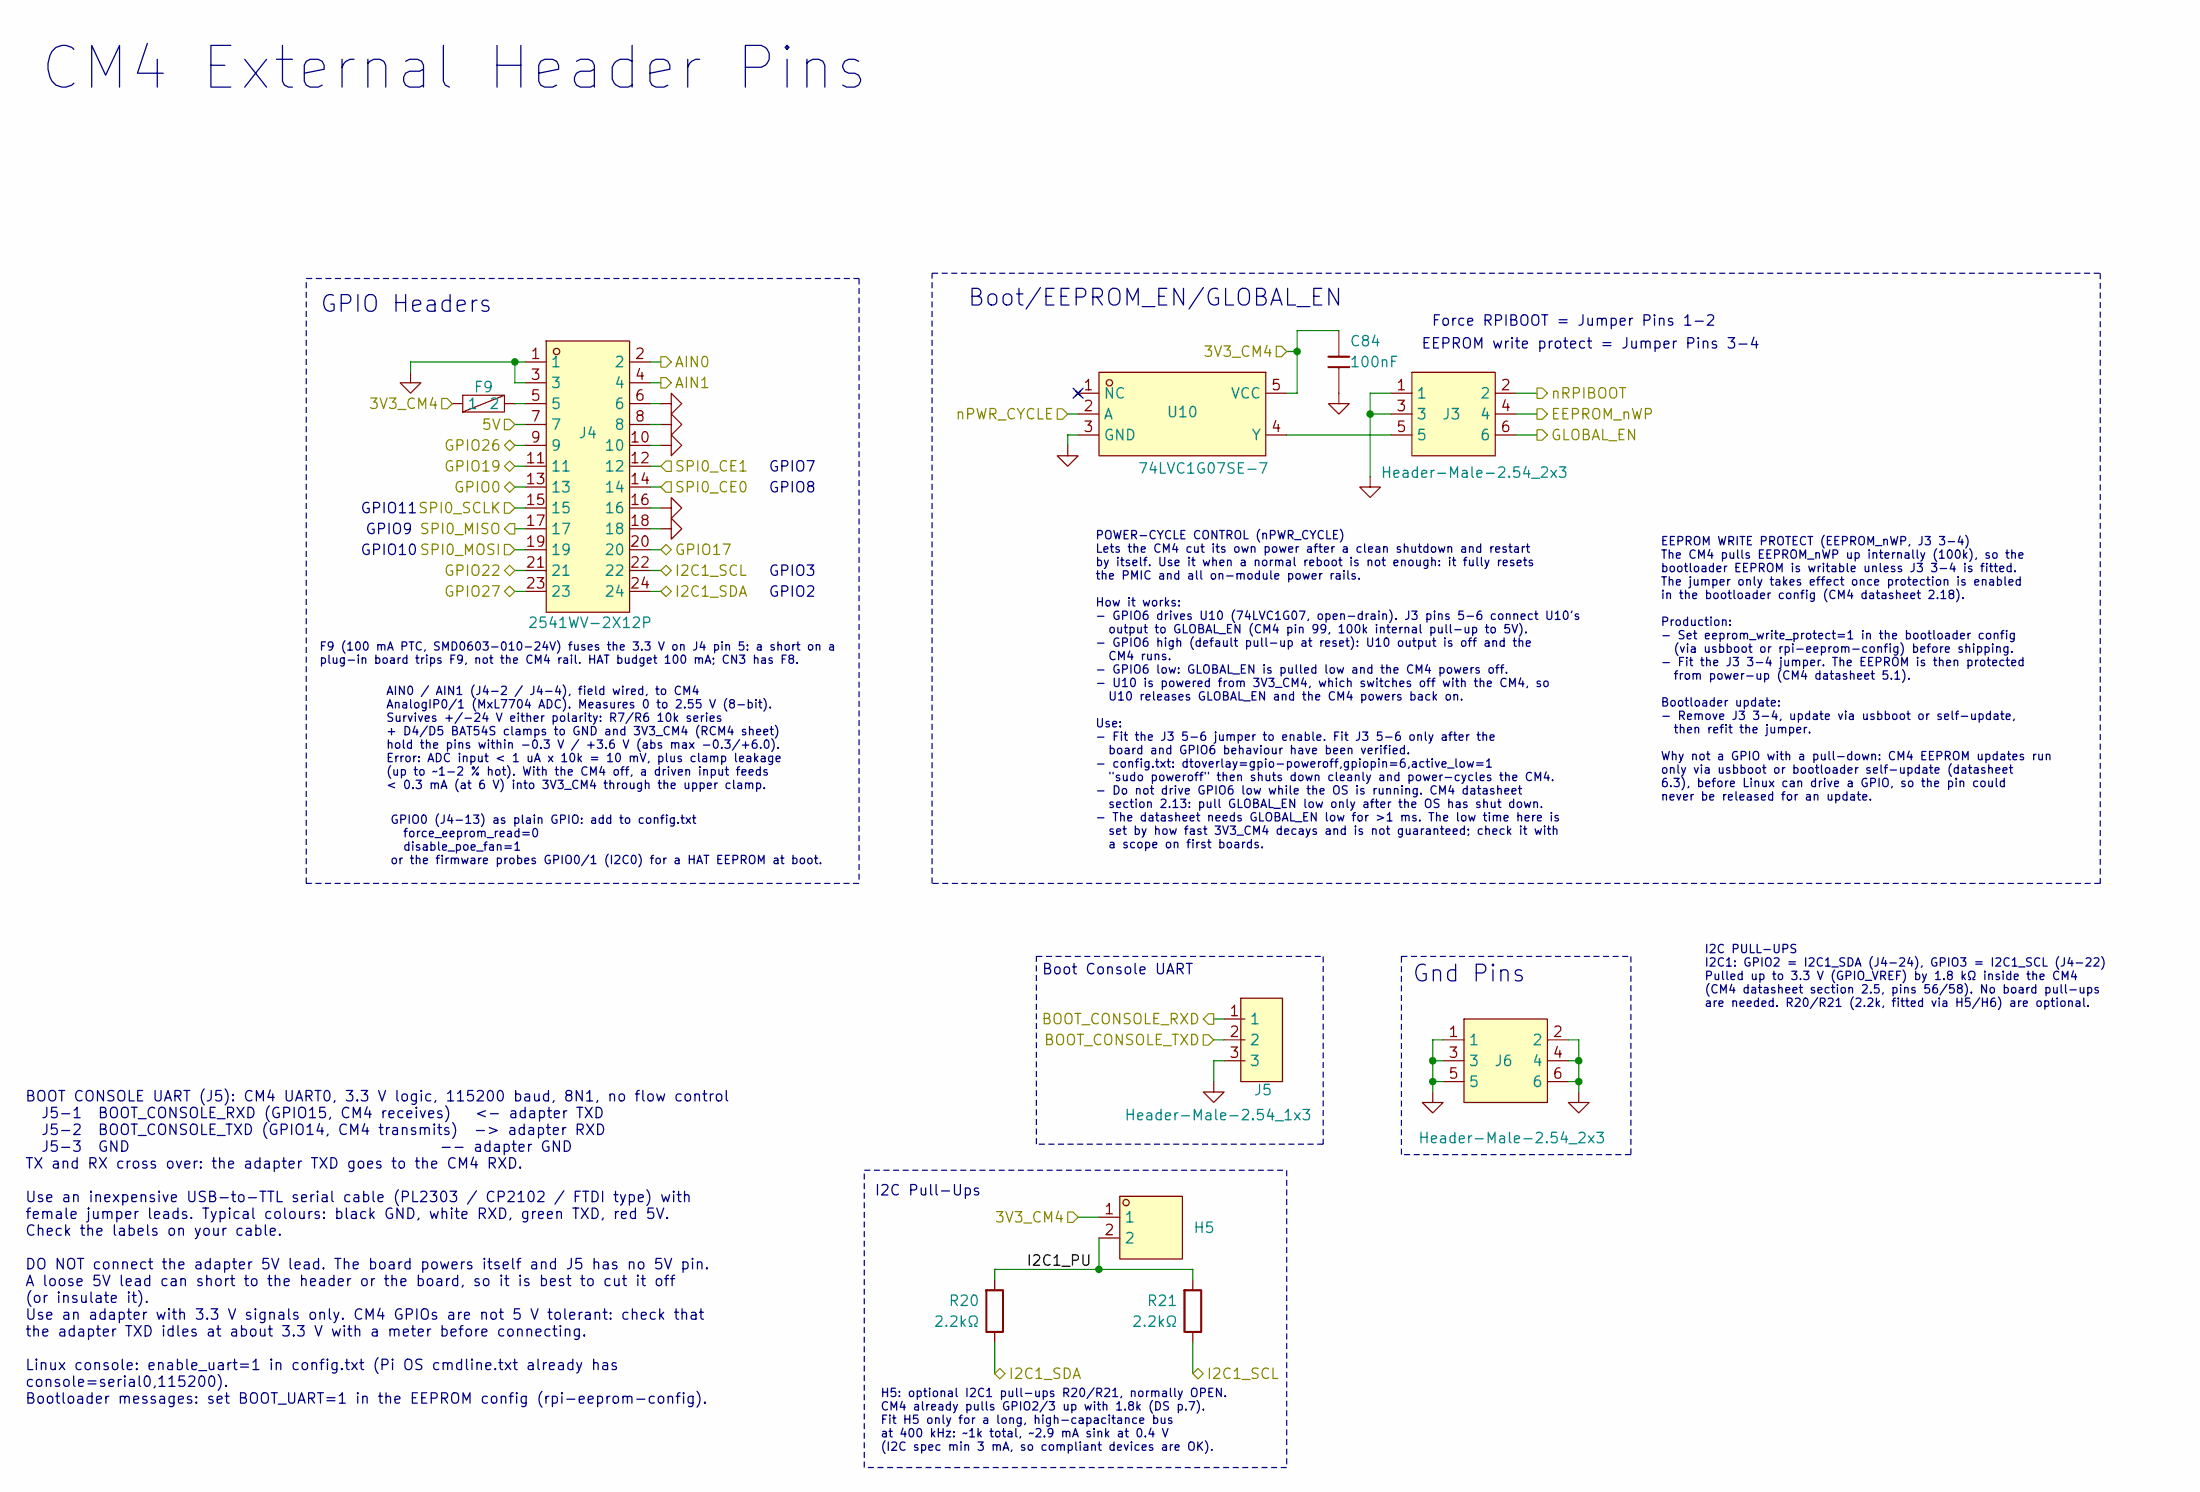
[picture p54: schematic cm4_connectors.kicad_sch]

Parts:
C84: 100nF; CAPC1005X55N; Tolerance ±10%; Voltage Rating 16V; MPN CL05B104KO5NNNC; LCSC Part C1525
F9: 100mA; FUSC1608X100N; MPN SMD0603-010-24V; LCSC Part C70048
H5: 210S-1*2P L=11.6MMGold-plated black; HDR-TH_2P-P2.54-V-M-1; MPN B-2100S02P-A110; LCSC Part C124375
J3, J6: Header-Male-2.54_2x3; HDR-TH_6P-P2.54-V-M-R2-C3-S2.54-1; MPN 2.54-2*3PPin; LCSC Part C65114
J4: 2541WV-2X12P; HDR-TH_24P-P2.54-V-M-R2-C12-S2.54; MPN 2541WV-2x12P; LCSC Part C5383110
J5: Header-Male-2.54_1x3; HDR-TH_3P-P2.54-V-M-1; MPN 2.54-1*3PPin; LCSC Part C49257
R20, R21: 2.2kΩ; RESC1005X40N; Tolerance ±1%; Voltage Rating 50V; MPN 0402WGF2201TCE; LCSC Part C25879
U10: 74LVC1G07SE-7; SOT65P210X110-5N; MPN 74LVC1G07SE-7; LCSC Part C67531

Connections:
/3V3_CM4: C84.1, F9.1, H5.1, U10.5 (VCC); also elsewhere on the board
/5V: J4.7; also elsewhere on the board
/CM4/AIN0: J4.2; also elsewhere on the board
/CM4/AIN1: J4.4; also elsewhere on the board
/CM4/BOOT_CONSOLE_RXD: J5.1; also elsewhere on the board
/CM4/BOOT_CONSOLE_TXD: J5.2; also elsewhere on the board
/CM4/CM4_Connectors/I2C1_PU: H5.2, R20.1, R21.1
/CM4/EEPROM_nWP: J3.4; also elsewhere on the board
/CM4/GLOBAL_EN: J3.6; also elsewhere on the board
/CM4/GPIO0: J4.13; also elsewhere on the board
/CM4/GPIO17: J4.20; also elsewhere on the board
/CM4/GPIO19: J4.11; also elsewhere on the board
/CM4/GPIO22: J4.21; also elsewhere on the board
/CM4/GPIO26: J4.9; also elsewhere on the board
/CM4/GPIO27: J4.23; also elsewhere on the board
/CM4/I2C1_SCL: J4.22, R21.2; also elsewhere on the board
/CM4/I2C1_SDA: J4.24, R20.2; also elsewhere on the board
/CM4/SPI0_CE0: J4.14; also elsewhere on the board
/CM4/SPI0_CE1: J4.12; also elsewhere on the board
/CM4/SPI0_MISO: J4.17; also elsewhere on the board
/CM4/SPI0_MOSI: J4.19; also elsewhere on the board
/CM4/SPI0_SCLK: J4.15; also elsewhere on the board
/CM4/nPWR_CYCLE: U10.2 (A); also elsewhere on the board
/CM4/nRPIBOOT: J3.2; also elsewhere on the board
GND: C84.2, J3.1, J3.3, J4.1, J4.3, J4.6, J4.8, J4.10, J4.16, J4.18, J5.3, J6.1, J6.2, J6.3, J6.4, J6.5, J6.6, U10.3 (GND); also elsewhere on the board
unnamed: F9.2, J4.5
unnamed: J3.5, U10.4 (Y)

Notes on the sheet:
Boot Console UART
I2C Pull-Ups
GPIO2
GPIO0 (J4-13) as plain GPIO: add to config.txt force_eeprom_read=0 disable_poe_fan=1 or the firmware probes GPIO0/1 (I2C0) for a HAT EEPROM at boot.
EEPROM WRITE PROTECT (EEPROM_nWP, J3 3-4) The CM4 pulls EEPROM_nWP up internally (100k), so the bootloader EEPROM is writable unless J3 3-4 is fitted. The jumper only takes effect once protection is enabled in the bootloader config (CM4 datasheet 2.18). Production: - Set eeprom_write_protect=1 in t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
H5: optional I2C1 pull-ups R20/R21, normally OPEN. CM4 already pulls GPIO2/3 up with 1.8k (DS p.7). Fit H5 only for a long, high-capacitance bus at 400 kHz: ~1k total, ~2.9 mA sink at 0.4 V (I2C spec min 3 mA, so compliant devices are OK).
I2C PULL-UPS I2C1: GPIO2 = I2C1_SDA (J4-24), GPIO3 = I2C1_SCL (J4-22) Pulled up to 3.3 V (GPIO_VREF) by 1.8 kΩ inside the CM4 (CM4 datasheet section 2.5, pins 56/58). No board pull-ups are needed. R20/R21 (2.2k, fitted via H5/H6) are optional.
EEPROM write protect = Jumper Pins 3-4
GPIO3
BOOT CONSOLE UART (J5): CM4 UART0, 3.3 V logic, 115200 baud, 8N1, no flow control J5-1 BOOT_CONSOLE_RXD (GPIO15, CM4 receives) <- adapter TXD J5-2 BOOT_CONSOLE_TXD (GPIO14, CM4 transmits) -> adapter RXD J5-3 GND -- adapter GND TX and RX cross over: the adapter TXD goes to the CM4 RXD. Use an inexpe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
AIN0 / AIN1 (J4-2 / J4-4), field wired, to CM4 AnalogIP0/1 (MxL7704 ADC). Measures 0 to 2.55 V (8-bit). Survives +/-24 V either polarity: R7/R6 10k series + D4/D5 BAT54S clamps to GND and 3V3_CM4 (RCM4 sheet) hold the pins within -0.3 V / +3.6 V (abs max -0.3/+6.0). Error: ADC input < 1 uA x 10k = 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
CM4 External Header Pins
GPIO9
GPIO10
Gnd Pins
Boot/EEPROM_EN/GLOBAL_EN
POWER-CYCLE CONTROL (nPWR_CYCLE) Lets the CM4 cut its own power after a clean shutdown and restart by itself. Use it when a normal reboot is not enough: it fully resets the PMIC and all on-module power rails. How it works: - GPIO6 drives U10 (74LVC1G07, open-drain). J3 pins 5-6 connect U10's output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
GPIO8
GPIO7
Force RPIBOOT = Jumper Pins 1-2
F9 (100 mA PTC, SMD0603-010-24V) fuses the 3.3 V on J4 pin 5: a short on a plug-in board trips F9, not the CM4 rail. HAT budget 100 mA; CN3 has F8.
GPIO Headers
GPIO11

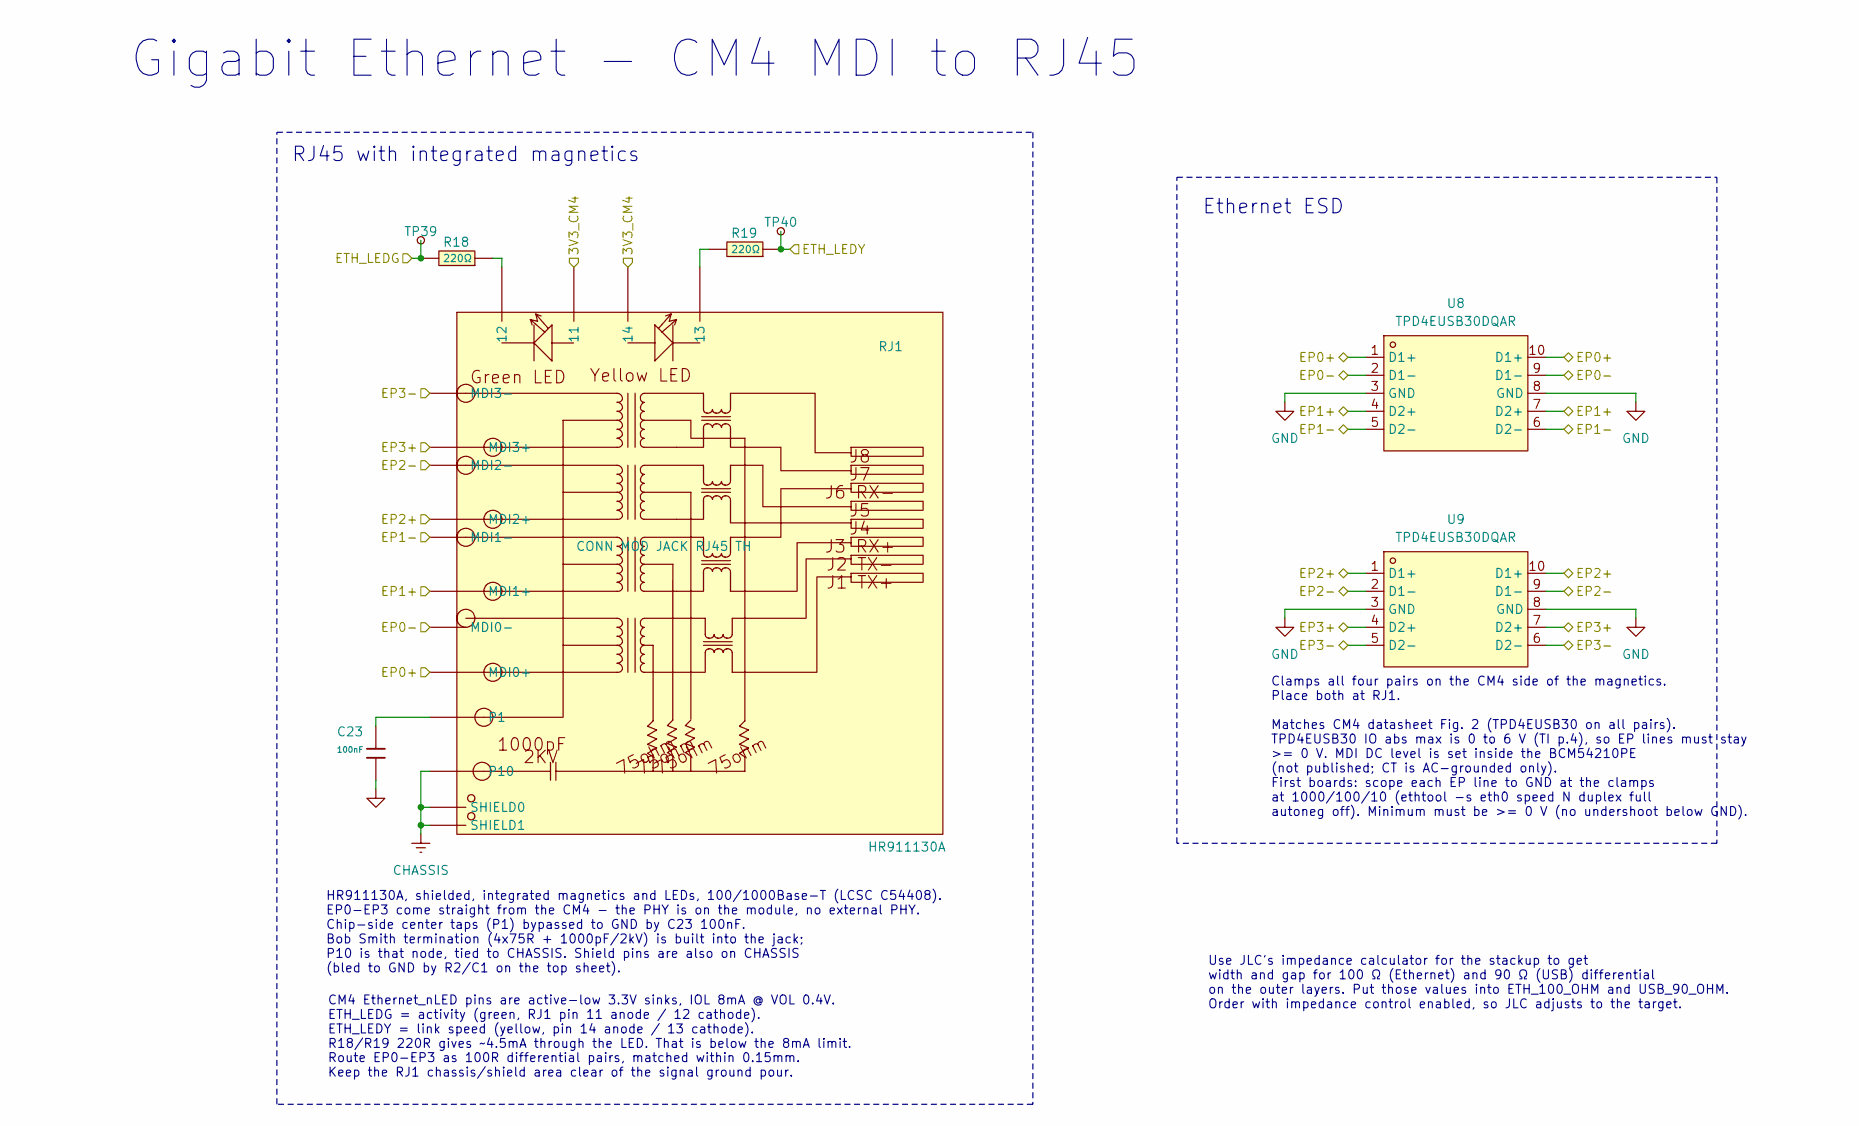
[picture p55: schematic ethernet.kicad_sch]

Parts:
C23: 100nF; CAPC1005X55N; Tolerance ±10%; Voltage Rating 16V; MPN CL05B104KO5NNNC; LCSC Part C1525
R18, R19: 220Ω; RESC1005X40N; Tolerance ±1%; Voltage Rating 50V; MPN 0402WGF2200TCE; LCSC Part C25091
RJ1: HR911130A; RJ45-TH_HR911130A; MPN HR911130A; LCSC Part C54408
TP39, TP40: TestPoint_Small; TestPoint_Pad_D0.8mm
U8, U9: TPD4EUSB30DQAR; SON50P100X250X60-10N; MPN TPD4EUSB30DQAR; LCSC Part C90627

Connections:
/3V3_CM4: RJ1.11, RJ1.14; also elsewhere on the board
/CM4/EP0+: RJ1.P2 (MDI0+), U8.1 (D1+), U8.10 (D1+); also elsewhere on the board
/CM4/EP0-: RJ1.P3 (MDI0-), U8.2 (D1-), U8.9 (D1-); also elsewhere on the board
/CM4/EP1+: RJ1.P4 (MDI1+), U8.4 (D2+), U8.7 (D2+); also elsewhere on the board
/CM4/EP1-: RJ1.P7 (MDI1-), U8.5 (D2-), U8.6 (D2-); also elsewhere on the board
/CM4/EP2+: RJ1.P5 (MDI2+), U9.1 (D1+), U9.10 (D1+); also elsewhere on the board
/CM4/EP2-: RJ1.P6 (MDI2-), U9.2 (D1-), U9.9 (D1-); also elsewhere on the board
/CM4/EP3+: RJ1.P8 (MDI3+), U9.4 (D2+), U9.7 (D2+); also elsewhere on the board
/CM4/EP3-: RJ1.P9 (MDI3-), U9.5 (D2-), U9.6 (D2-); also elsewhere on the board
/CM4/ETH_LEDG: R18.2, TP39.1 (1_1); also elsewhere on the board
/CM4/ETH_LEDY: R19.1, TP40.1 (1_1); also elsewhere on the board
CHASSIS: RJ1.P10, RJ1.SHIELD0, RJ1.SHIELD1; also elsewhere on the board
GND: C23.2, U8.3 (GND), U8.8 (GND), U9.3 (GND), U9.8 (GND); also elsewhere on the board
unnamed: C23.1, RJ1.P1
unnamed: R18.1, RJ1.12
unnamed: R19.2, RJ1.13

Notes on the sheet:
Ethernet ESD
Use JLC's impedance calculator for the stackup to get width and gap for 100 Ω (Ethernet) and 90 Ω (USB) differential on the outer layers. Put those values into ETH_100_OHM and USB_90_OHM. Order with impedance control enabled, so JLC adjusts to the target.
HR911130A, shielded, integrated magnetics and LEDs, 100/1000Base-T (LCSC C54408). EP0-EP3 come straight from the CM4 - the PHY is on the module, no external PHY. Chip-side center taps (P1) bypassed to GND by C23 100nF. Bob Smith termination (4x75R + 1000pF/2kV) is built into the jack; P10 is that n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
RJ45 with integrated magnetics
Clamps all four pairs on the CM4 side of the magnetics. Place both at RJ1. Matches CM4 datasheet Fig. 2 (TPD4EUSB30 on all pairs). TPD4EUSB30 IO abs max is 0 to 6 V (TI p.4), so EP lines must stay >= 0 V. MDI DC level is set inside the BCM54210PE (not published; CT is AC-grounded only). First board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
Route EP0-EP3 as 100R differential pairs, matched within 0.15mm. Keep the RJ1 chassis/shield area clear of the signal ground pour.
CM4 Ethernet_nLED pins are active-low 3.3V sinks, IOL 8mA @ VOL 0.4V. ETH_LEDG = activity (green, RJ1 pin 11 anode / 12 cathode). ETH_LEDY = link speed (yellow, pin 14 anode / 13 cathode). R18/R19 220R gives ~4.5mA through the LED. That is below the 8mA limit.
Gigabit Ethernet - CM4 MDI to RJ45
