jrseti/roboclaw-cm4-dc-dish-controller/kicad/cm4-robo-controller.kicad_pcb

## KiCad design kicad/cm4-robo-controller.kicad_pcb (continued)

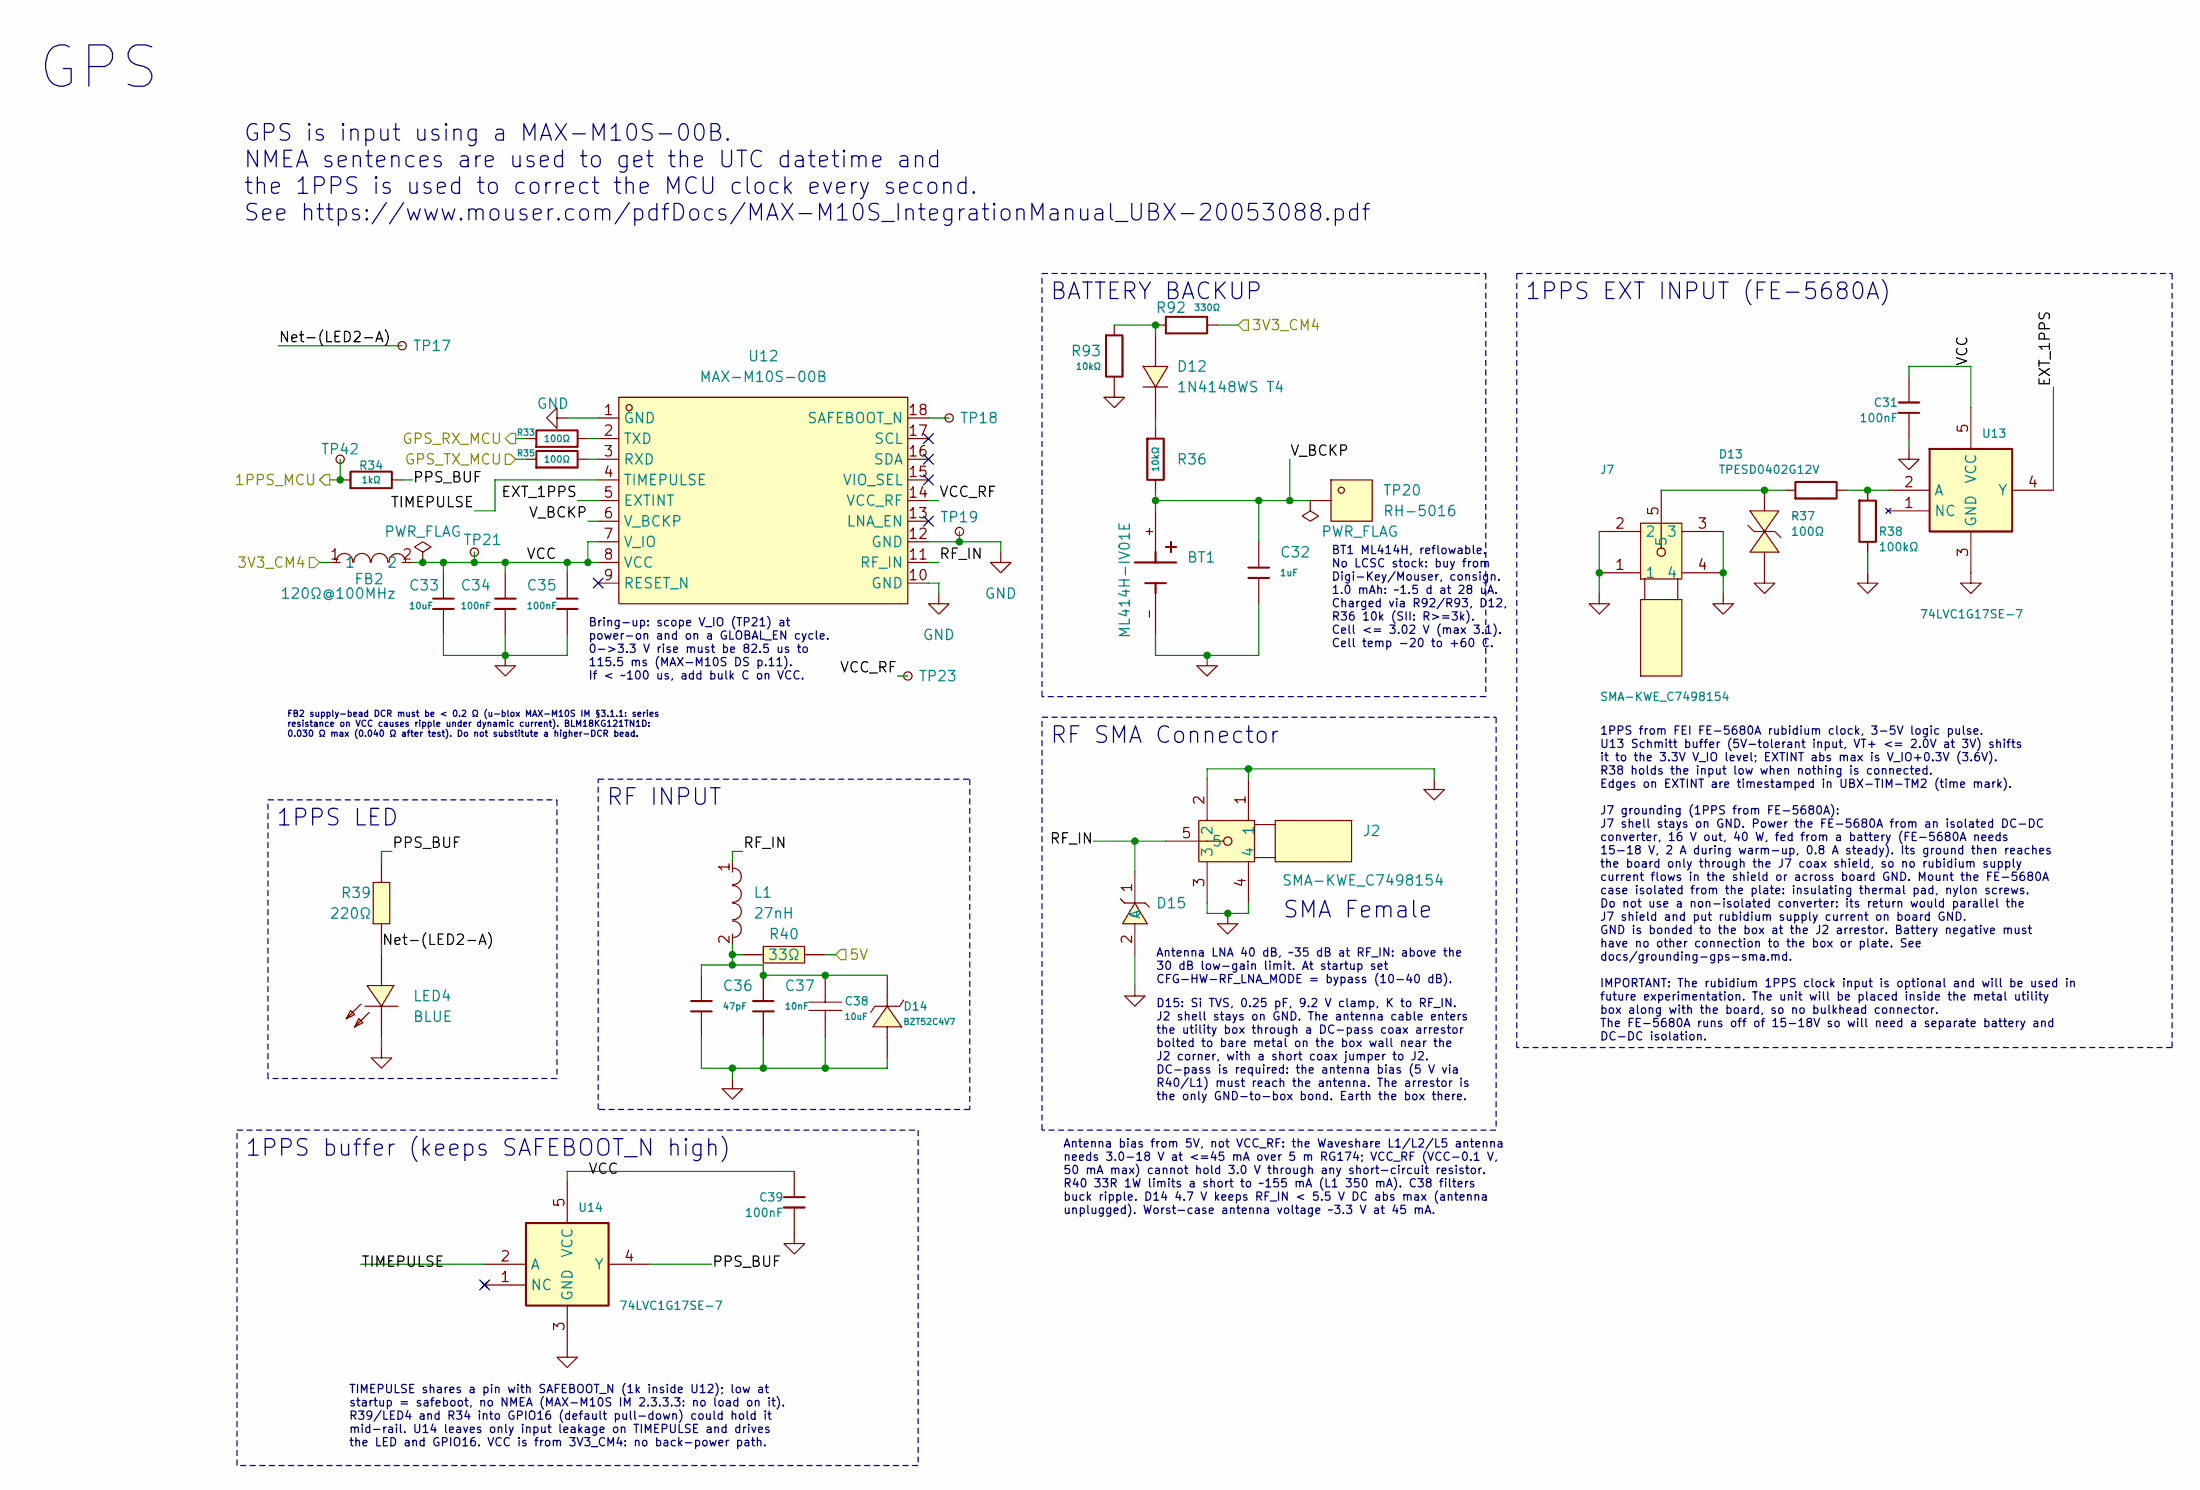
[picture p56: schematic gps.kicad_sch, GPS 1PPS and RS232]

Parts:
BT1: ML414H-IV01E; PARTREV E
C31, C34, C35, C39: 100nF; CAPC1608X95N; Tolerance ±10%; Voltage Rating 50V; MPN CC0603KRX7R9BB104; LCSC Part C14663
C32: 1uF; CAPC1608X95N; Tolerance ±10%; Voltage Rating 50V; MPN CL10A105KB8NNNC; LCSC Part C15849
C33: 10uF; CAPC1608X95N; Tolerance ±20%; Voltage Rating 25V; MPN CL10A106MA8NRNC; LCSC Part C96446
C36: 47pF; CAPC1608X95N; Tolerance ±5%; Voltage Rating 50V; MPN CL10C470JB8NNNC; LCSC Part C1671
C37: 10nF; CAPC1608X95N; Tolerance ±10%; Voltage Rating 50V; MPN 0603B103K500NT; LCSC Part C57112
C38: 10uF; CAPC2012X145N; Tolerance ±10%; Voltage Rating 10V; MPN CL21B106KPQNNNE; LCSC Part C32635
D12: 1N4148WS T4; SOD2513X110N; MPN 1N4148WS; LCSC Part C2128
D13: TPESD0402G12V; DIOC1005X55N; MPN TPESD0402G12V; LCSC Part C558617
D14: BZT52C4V7; SOD3716X135N; MPN BZT52C4V7; LCSC Part C19077400
D15: SESD0402X1UN-0020-090; DIOC1006X40N; MPN SESD0402X1UN-0020-090; LCSC Part C1973340
FB2: 120Ω@100MHz; INDC1608X95N; Tolerance ±25%; Current Rating 3A; MPN BLM18KG121TN1D; LCSC Part C85831
J2, J7: SMA-KWE_C7498154; SMA-TH_SMA-KWE_C7498154; MPN SMA-KWE; LCSC Part C7498154
L1: 27nH; INDC1005X55N; Tolerance ±5%; Current Rating 350mA; MPN LQG15HS27NJ02D; LCSC Part C12669
LED4: BLUE; LEDC2012X110N; MPN KT-0805B; LCSC Part C2293
R33, R35, R37: 100Ω; RESC1005X40N; Tolerance ±1%; Voltage Rating 50V; MPN 0402WGF1000TCE; LCSC Part C25076
R34: 1kΩ; RESC1005X40N; Tolerance ±1%; Voltage Rating 50V; MPN 0402WGF1001TCE; LCSC Part C11702
R36, R93: 10kΩ; RESC1608X55N; Tolerance ±1%; Voltage Rating 75V; MPN 0603WAF1002T5E; LCSC Part C25804
R38: 100kΩ; RESC1608X55N; Tolerance ±1%; Voltage Rating 75V; MPN 0603WAF1003T5E; LCSC Part C25803
R39: 220Ω; RESC1005X40N; Tolerance ±1%; Voltage Rating 50V; MPN 0402WGF2200TCE; LCSC Part C25091
R40: 33Ω; RESC6332X70N; Tolerance ±1%; Voltage Rating 200V; MPN 25121WF330JT4E; LCSC Part C53728
R92: 330Ω; RESC1608X55N; Tolerance ±1%; Voltage Rating 75V; MPN 0603WAF3300T5E; LCSC Part C23138
TP17, TP18, TP19, TP21, TP23, TP42: TestPoint_Small; TestPoint_Pad_D0.8mm
TP20: RH-5016; TESTPOINT-SMD_L3.0-W2.0; MPN RH-5016; LCSC Part C5199799
U12: MAX-M10S-00B; SMD-18_L10.1-W9.7-P1.10-TL_SKG09F; MPN MAX-M10S-00B; LCSC Part C4153167
U13, U14: 74LVC1G17SE-7; SOT65P210X110-5N; MPN 74LVC1G17SE-7; LCSC Part C212314

Connections:
/3V3_CM4: FB2.1, R92.2; also elsewhere on the board
/5V: R40.2; also elsewhere on the board
/CM4/1PPS_MCU: R34.1, TP42.1 (1_1); also elsewhere on the board
/CM4/GPS_RX_MCU: R33.1; also elsewhere on the board
/CM4/GPS_TX_MCU: R35.1; also elsewhere on the board
/GPS/EXT_1PPS: U12.5 (EXTINT), U13.4 (Y)
/GPS/Net-(LED2-A): LED4.1 (A), R39.1, TP17.1 (1_1)
/GPS/PPS_BUF: R34.2, R39.2, U14.4 (Y)
/GPS/RF_IN: D15.1 (C), J2.5, L1.1, U12.11 (RF_IN)
/GPS/TIMEPULSE: U12.4 (TIMEPULSE), U14.2 (A)
/GPS/VCC: C31.1, C33.1, C34.1, C35.1, C39.1, FB2.2, TP21.1 (1_1), U12.7 (V_IO), U12.8 (VCC), U13.5 (VCC), U14.5 (VCC)
/GPS/VCC_RF: TP23.1 (1_1), U12.14 (VCC_RF)
/GPS/V_BCKP: BT1.+, C32.1, R36.2, TP20.1 (1_1), U12.6 (V_BCKP)
GND: BT1.-, C31.2, C32.2, C33.2, C34.2, C35.2, C36.2, C37.2, C38.1, C39.2, D13.1 (K), D14.2 (A), D15.2 (A), J2.1, J2.2, J2.3, J2.4, J7.1, J7.2, J7.3, J7.4, LED4.2 (K), R38.2, R93.2, TP19.1 (1_1), U12.1 (GND), U12.10 (GND), U12.12 (GND), U13.3 (GND), U14.3 (GND); also elsewhere on the board
unnamed: D12.2 (A), R92.1, R93.1
unnamed: D12.1 (K), R36.1
unnamed: D13.2 (A), J7.5, R37.1
unnamed: C36.1, C37.1, C38.2, D14.1 (K), L1.2, R40.1
unnamed: R35.2, U12.3 (RXD)
unnamed: TP18.1 (1_1), U12.18 (SAFEBOOT_N)
unnamed: R33.2, U12.2 (TXD)
unnamed: R37.2, R38.1, U13.2 (A)

Notes on the sheet:
GPS
Bring-up: scope V_IO (TP21) at power-on and on a GLOBAL_EN cycle. 0->3.3 V rise must be 82.5 us to 115.5 ms (MAX-M10S DS p.11). If < ~100 us, add bulk C on VCC.
1PPS from FEI FE-5680A rubidium clock, 3-5V logic pulse. U13 Schmitt buffer (5V-tolerant input, VT+ <= 2.0V at 3V) shifts it to the 3.3V V_IO level; EXTINT abs max is V_IO+0.3V (3.6V). R38 holds the input low when nothing is connected. Edges on EXTINT are timestamped in UBX-TIM-TM2 (time mark). J7 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
Antenna bias from 5V, not VCC_RF: the Waveshare L1/L2/L5 antenna needs 3.0-18 V at <=45 mA over 5 m RG174; VCC_RF (VCC-0.1 V, 50 mA max) cannot hold 3.0 V through any short-circuit resistor. R40 33R 1W limits a short to ~155 mA (L1 350 mA). C38 filters buck ripple. D14 4.7 V keeps RF_IN < 5.5 V DC 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
FB2 supply-bead DCR must be < 0.2 Ω (u-blox MAX-M10S IM §3.1.1: series resistance on VCC causes ripple under dynamic current). BLM18KG121TN1D: 0.030 Ω max (0.040 Ω after test). Do not substitute a higher-DCR bead.
D15: Si TVS, 0.25 pF, 9.2 V clamp, K to RF_IN. J2 shell stays on GND. The antenna cable enters the utility box through a DC-pass coax arrestor bolted to bare metal on the box wall near the J2 corner, with a short coax jumper to J2. DC-pass is required: the antenna bias (5 V via R40/L1) must reach t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
GPS is input using a MAX-M10S-00B. NMEA sentences are used to get the UTC datetime and the 1PPS is used to correct the MCU clock every second. See https://www.mouser.com/pdfDocs/MAX-M10S_IntegrationManual_UBX-20053088.pdf
SMA Female
BT1 ML414H, reflowable. No LCSC stock: buy from Digi-Key/Mouser, consign. 1.0 mAh: ~1.5 d at 28 uA. Charged via R92/R93, D12, R36 10k (SII: R>=3k). Cell <= 3.02 V (max 3.1). Cell temp -20 to +60 C.
TIMEPULSE shares a pin with SAFEBOOT_N (1k inside U12); low at startup = safeboot, no NMEA (MAX-M10S IM 2.3.3.3: no load on it). R39/LED4 and R34 into GPIO16 (default pull-down) could hold it mid-rail. U14 leaves only input leakage on TIMEPULSE and drives the LED and GPIO16. VCC is from 3V3_CM4: no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
Antenna LNA 40 dB, ~35 dB at RF_IN: above the 30 dB low-gain limit. At startup set CFG-HW-RF_LNA_MODE = bypass (10-40 dB).
RF SMA Connector
1PPS EXT INPUT (FE-5680A)
1PPS buffer (keeps SAFEBOOT_N high)
1PPS LED
RF INPUT
BATTERY BACKUP

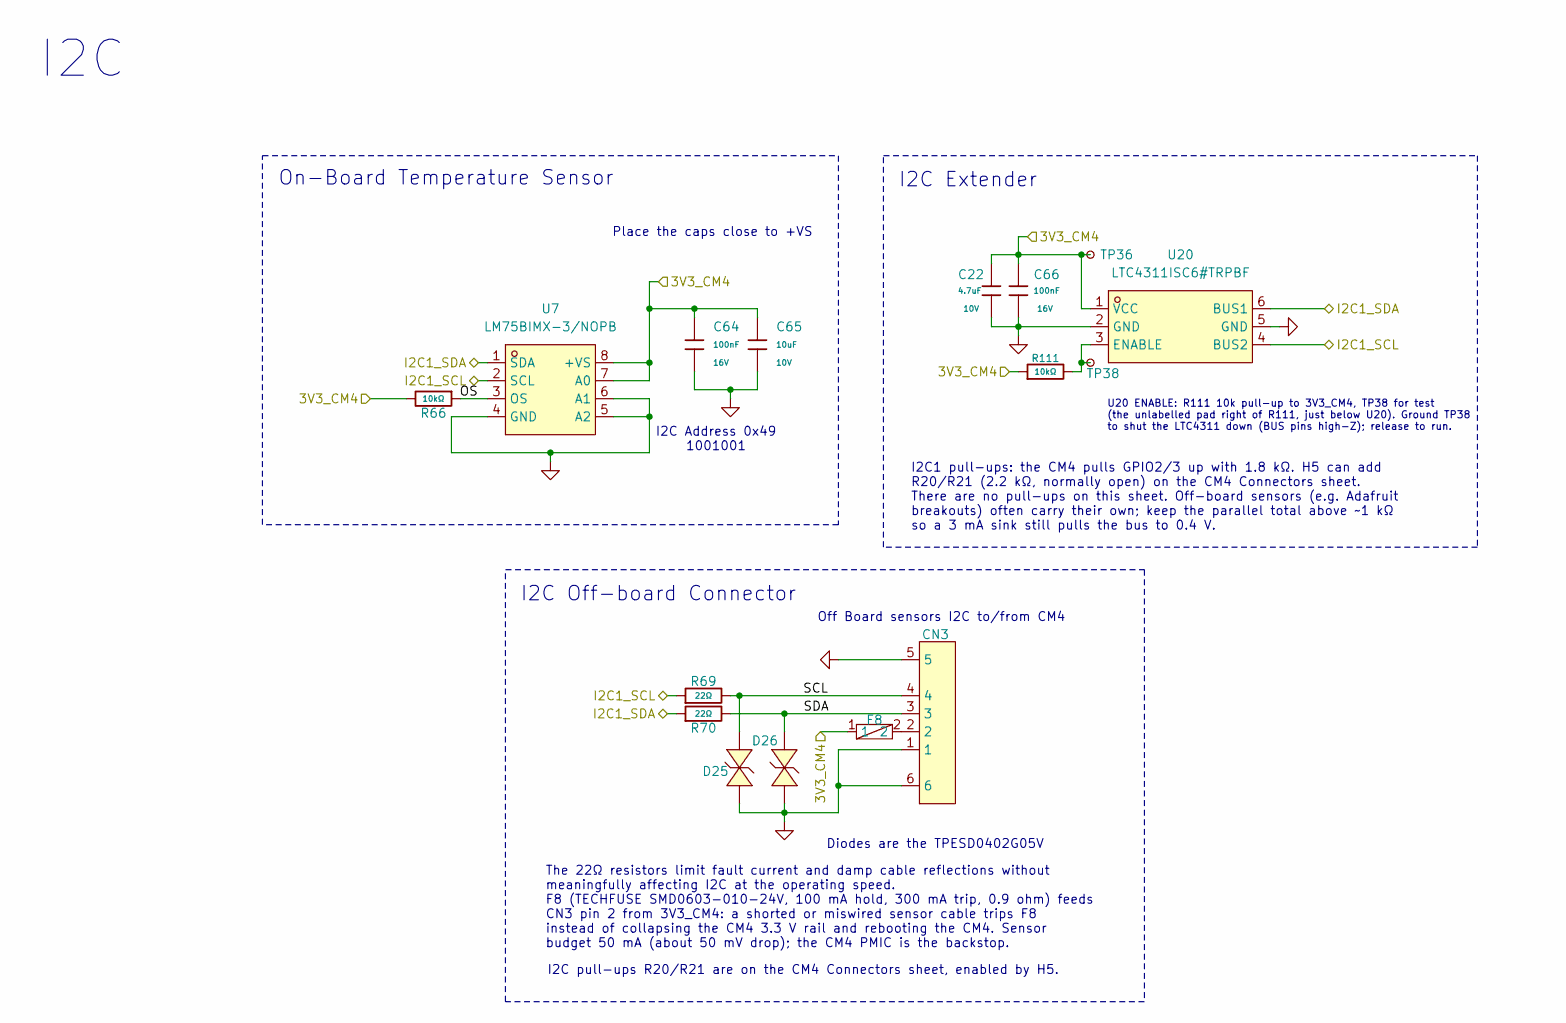
[picture p57: schematic i2c.kicad_sch]

Parts:
C22: 4.7uF; CAPC1005X55N; Voltage Rated 10V; Tolerance ±20%; MPN CL05A475MP5NRNC; LCSC Part C23733
C64, C66: 100nF; CAPC1005X55N; Voltage Rated 16V; Tolerance ±10%; MPN CL05B104KO5NNNC; LCSC Part C1525
C65: 10uF; CAPC1608X95N; Voltage Rated 10V; Tolerance ±10%; MPN CL10A106KP8NNNC; LCSC Part C19702
CN3: SM04B-SRSS-TB (LF)(SN); JST_SH_SM04B-SRSS-TB_1x04-1MP_P1.00mm_Horizontal; MPN SM04B-SRSS-TB(LF)(SN); LCSC Part C160404
D25, D26: TPESD0402G05V; DIOC1005X55N; MPN TPESD0402G05V; LCSC Part C558615
F8: 100mA; FUSC1608X100N; MPN SMD0603-010-24V; LCSC Part C70048
R66: 10kΩ; RESC1005X40N; Overload Voltage (Max) 50V; Tolerance ±1%; MPN 0402WGF1002TCE; LCSC Part C25744
R69: 22Ω; RESC1005X40N; Overload Voltage (Max) 50V; Tolerance ±1%; MPN 0402WGF220JTCE; LCSC Part C25092
R70: 22Ω; RESC1005X40N; Overload Voltage (Max) 50V; Tolerance ±1%; Part 0402WGF220JTCE; LCSC Part C25092
R111: 10kΩ; RESC1005X40N; Tolerance ±1%; Voltage Rating 50V; MPN 0402WGF1002TCE; LCSC Part C25744
TP36, TP38: TestPoint_Small; TestPoint_Pad_D0.8mm
U7: LM75BIMX-3/NOPB; SOIC127P600X175-8N; MPN LM75BIMX-3/NOPB; LCSC Part C477980
U20: LTC4311ISC6#TRPBF; SOT65P210X110-6N; MPN LTC4311ISC6#TRPBF; LCSC Part C688097

Connections:
/3V3_CM4: C22.1, C64.1, C65.1, C66.1, F8.1, R66.2, R111.1, TP36.1 (1_1), U7.7 (A0), U7.8 (+VS), U20.1 (VCC); also elsewhere on the board
/CM4/I2C1_SCL: R69.1, U7.2 (SCL), U20.4 (BUS2); also elsewhere on the board
/CM4/I2C1_SDA: R70.1, U7.1 (SDA), U20.6 (BUS1); also elsewhere on the board
/CM4/I2C/OS: R66.1, U7.3 (OS)
/CM4/I2C/SCL: CN3.4, D25.1 (K), R69.2
/CM4/I2C/SDA: CN3.3, D26.1 (K), R70.2
GND: C22.2, C64.2, C65.2, C66.2, CN3.1, CN3.5, CN3.6, D25.2 (A), D26.2 (A), U7.4 (GND), U7.5 (A2), U7.6 (A1), U20.2 (GND), U20.5 (GND); also elsewhere on the board
unnamed: CN3.2, F8.2
unnamed: R111.2, TP38.1 (1_1), U20.3 (ENABLE)

Notes on the sheet:
I2C1 pull-ups: the CM4 pulls GPIO2/3 up with 1.8 kΩ. H5 can add R20/R21 (2.2 kΩ, normally open) on the CM4 Connectors sheet. There are no pull-ups on this sheet. Off-board sensors (e.g. Adafruit breakouts) often carry their own; keep the parallel total above ~1 kΩ so a 3 mA sink still pulls the bus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
I2C pull-ups R20/R21 are on the CM4 Connectors sheet, enabled by H5.
Diodes are the TPESD0402G05V
Place the caps close to +VS
I2C Address 0x49 1001001
I2C
The 22Ω resistors limit fault current and damp cable reflections without meaningfully affecting I2C at the operating speed. F8 (TECHFUSE SMD0603-010-24V, 100 mA hold, 300 mA trip, 0.9 ohm) feeds CN3 pin 2 from 3V3_CM4: a shorted or miswired sensor cable trips F8 instead of collapsing the CM4 3.3 V 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
U20 ENABLE: R111 10k pull-up to 3V3_CM4, TP38 for test (the unlabelled pad right of R111, just below U20). Ground TP38 to shut the LTC4311 down (BUS pins high-Z); release to run.
I2C Extender
I2C Off-board Connector
Off Board sensors I2C to/from CM4
On-Board Temperature Sensor

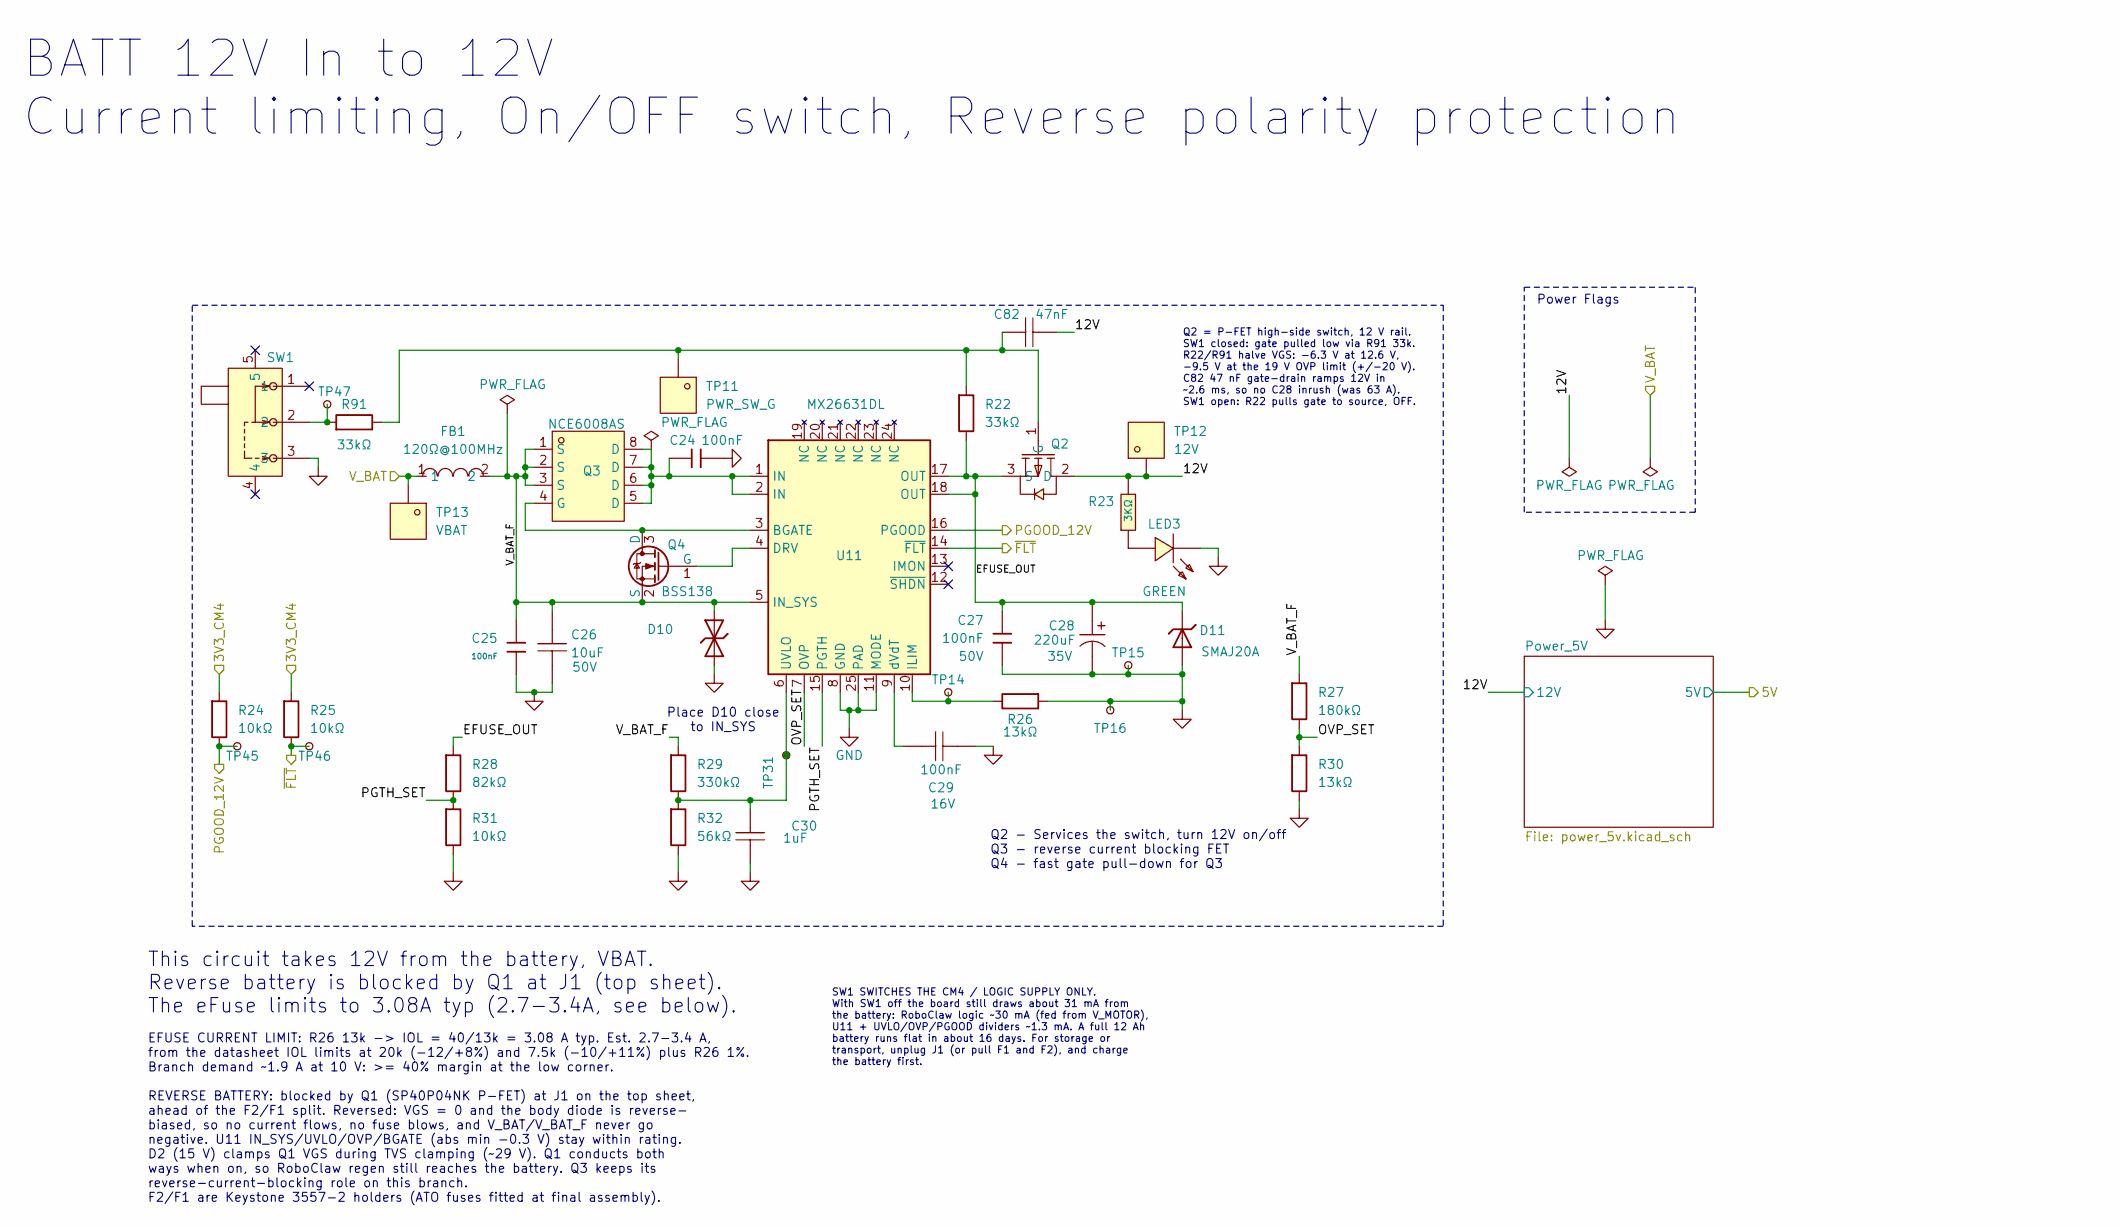
[picture p58: schematic power.kicad_sch]

Parts:
C24, C25: 100nF; CAPC1608X95N; Tolerance ±10%; Voltage Rating 50V; MPN CC0603KRX7R9BB104; LCSC Part C14663
C26: 10uF; CAPC3216X180N; Voltage Rating 50V; Tolerance ±10%; MPN TCC1206X7R106K500HT; LCSC Part C5449000
C27: 100nF; CAPC1608X95N; Voltage Rating 50V; Tolerance ±10%; MPN CC0603KRX7R9BB104; LCSC Part C14663
C28: 220uF; CAPAE660X770N; Voltage Rating 35V; Tolerance ±20%; MPN JVJ35V220M6x8; LCSC Part C46550411
C29: 100nF; CAPC1005X55N; Voltage Rating 16V; Tolerance ±10%; MPN CL05B104KO5NNNC; LCSC Part C1525
C30: 1uF; CAPC1608X95N; Tolerance ±10%; Voltage Rating 25V; MPN CL10A105KA8NNNC; LCSC Part C5673
C82: 47nF; CAPC1608X95N; Tolerance ±10%; Voltage Rating 50V; MPN CL10B473KB8NNNC; LCSC Part C1622
D10: SMBJ18CA; DIOM5436X244N; MPN SMBJ18CA; LCSC Part C19077574
D11: SMAJ20A; DIOM5226X244N; MPN SMAJ20A; LCSC Part C41376408
FB1: 120Ω@100MHz; INDC3216X130N; Tolerance ±25%; Current Rating 6A; MPN BLM31KN121SN1L; LCSC Part C337884
LED3: GREEN; LEDC2012X110N; MPN KT-0805G; LCSC Part C2297
Q2: DMP6023LE-13; SOT230P700X180-4N; MPN DMP6023LE-13; LCSC Part C154901
Q3: NCE6008AS; SOIC127P600X175-8N; MPN NCE6008AS; LCSC Part C341716
Q4: BSS138; SOT95P237X112-3N; MPN BSS138; LCSC Part C7420339
R22, R91: 33kΩ; RESC1608X55N; Tolerance ±1%; Voltage Rating 75V; MPN 0603WAF3302T5E; LCSC Part C4216
R23: 3KΩ; RESC1608X55N; Tolerance ±1%; Voltage Rating 75V; MPN 0603WAF3001T5E; LCSC Part C4211
R24, R25, R31: 10kΩ; RESC1608X55N; Tolerance ±1%; Voltage Rating 75V; MPN 0603WAF1002T5E; LCSC Part C25804
R26, R30: 13kΩ; RESC1608X55N; Tolerance ±1%; Voltage Rating 75V; MPN 0603WAF1302T5E; LCSC Part C22797
R27: 180kΩ; RESC1608X55N; Tolerance ±1%; Voltage Rating 75V; MPN 0603WAF1803T5E; LCSC Part C22827
R28: 82kΩ; RESC1608X55N; Tolerance ±1%; Voltage Rating 75V; MPN 0603WAF8202T5E; LCSC Part C23254
R29: 330kΩ; RESC1608X55N; Tolerance ±1%; Voltage Rating 75V; MPN 0603WAF3303T5E; LCSC Part C23137
R32: 56kΩ; RESC1608X55N; Tolerance ±1%; Voltage Rating 75V; MPN 0603WAF5602T5E; LCSC Part C23206
SW1: SS-12F49-G050; SW-TH_SS-12F45-GXXX; MPN SS-12F49-G050; LCSC Part C2876010
TP11: PWR_SW_G; TESTPOINT-SMD_L3.0-W2.0; MPN RH-5016; LCSC Part C5199799
TP12: 12V; TESTPOINT-SMD_L3.0-W2.0; MPN RH-5016; LCSC Part C5199799
TP13: VBAT; TESTPOINT-SMD_L3.0-W2.0; MPN RH-5016; LCSC Part C5199799
TP14, TP15, TP16, TP31, TP45, TP46, TP47: TestPoint_Small; TestPoint_Pad_D0.8mm
U11: MX26631DL; QFN50P400X400X80-25N; MPN MX26631DL; LCSC C18197523

Connections:
/3V3_CM4: R24.1, R25.1; also elsewhere on the board
/CM4/PGOOD_12V: R24.2, TP45.1 (1_1), U11.16 (PGOOD); also elsewhere on the board
/CM4/~FLT: R25.2, TP46.1 (1_1), U11.14 (~FLT); also elsewhere on the board
/battery-input/V_BAT: FB1.1, TP13.1 (1_1); also elsewhere on the board
/power/12V: C82.2, Q2.2 (D), R23.2, TP12.1 (1_1); also elsewhere on the board
/power/EFUSE_OUT: C27.1, C28.1, D11.1, Q2.3 (S), R22.2, R28.1, U11.17 (OUT), U11.18 (OUT)
/power/OVP_SET: R27.2, R30.1, U11.7 (OVP)
/power/PGTH_SET: R28.2, R31.1, U11.15 (PGTH)
/power/V_BAT_F: C25.1, C26.2, D10.1, FB1.2, Q3.1 (S), Q3.2 (S), Q3.3 (S), Q4.2 (S), R27.1, R29.1, U11.5 (IN_SYS)
GND: C24.2, C25.2, C26.1, C27.2, C28.2, C29.2, C30.1, D10.2, D11.2, LED3.2 (K), R26.1, R30.2, R31.2, R32.2, SW1.3, TP15.1 (1_1), TP16.1 (1_1), U11.8 (GND), U11.11 (MODE), U11.25 (PAD); also elsewhere on the board
unnamed: C24.1, Q3.5 (D), Q3.6 (D), Q3.7 (D), Q3.8 (D), U11.1 (IN), U11.2 (IN)
unnamed: LED3.1 (A), R23.1
unnamed: C82.1, Q2.1 (G), R22.1, R91.2, TP11.1 (1_1)
unnamed: Q3.4 (G), Q4.3 (D), U11.3 (BGATE)
unnamed: Q4.1 (G), U11.4 (DRV)
unnamed: R91.1, SW1.2, TP47.1 (1_1)
unnamed: R26.2, TP14.1 (1_1), U11.10 (ILIM)
unnamed: C30.2, R29.2, R32.1, TP31.1 (1_1), U11.6 (UVLO)
unnamed: C29.1, U11.9 (dVdT)

Notes on the sheet:
EFUSE CURRENT LIMIT: R26 13k -> IOL = 40/13k = 3.08 A typ. Est. 2.7-3.4 A, from the datasheet IOL limits at 20k (-12/+8%) and 7.5k (-10/+11%) plus R26 1%. Branch demand ~1.9 A at 10 V: >= 40% margin at the low corner. REVERSE BATTERY: blocked by Q1 (SP40P04NK P-FET) at J1 on the top sheet, ahead of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
BATT 12V In to 12V Current limiting, On/OFF switch, Reverse polarity protection
SW1 SWITCHES THE CM4 / LOGIC SUPPLY ONLY. With SW1 off the board still draws about 31 mA from the battery: RoboClaw logic ~30 mA (fed from V_MOTOR), U11 + UVLO/OVP/PGOOD dividers ~1.3 mA. A full 12 Ah battery runs flat in about 16 days. For storage or transport, unplug J1 (or pull F1 and F2), and c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
Place D10 close to IN_SYS
This circuit takes 12V from the battery, VBAT. Reverse battery is blocked by Q1 at J1 (top sheet). The eFuse limits to 3.08A typ (2.7-3.4A, see below).
Q2 - Services the switch, turn 12V on/off Q3 - reverse current blocking FET Q4 - fast gate pull-down for Q3
Power Flags
Q2 = P-FET high-side switch, 12 V rail. SW1 closed: gate pulled low via R91 33k. R22/R91 halve VGS: -6.3 V at 12.6 V, -9.5 V at the 19 V OVP limit (+/-20 V). C82 47 nF gate-drain ramps 12V in ~2.6 ms, so no C28 inrush (was 63 A). SW1 open: R22 pulls gate to source, OFF.

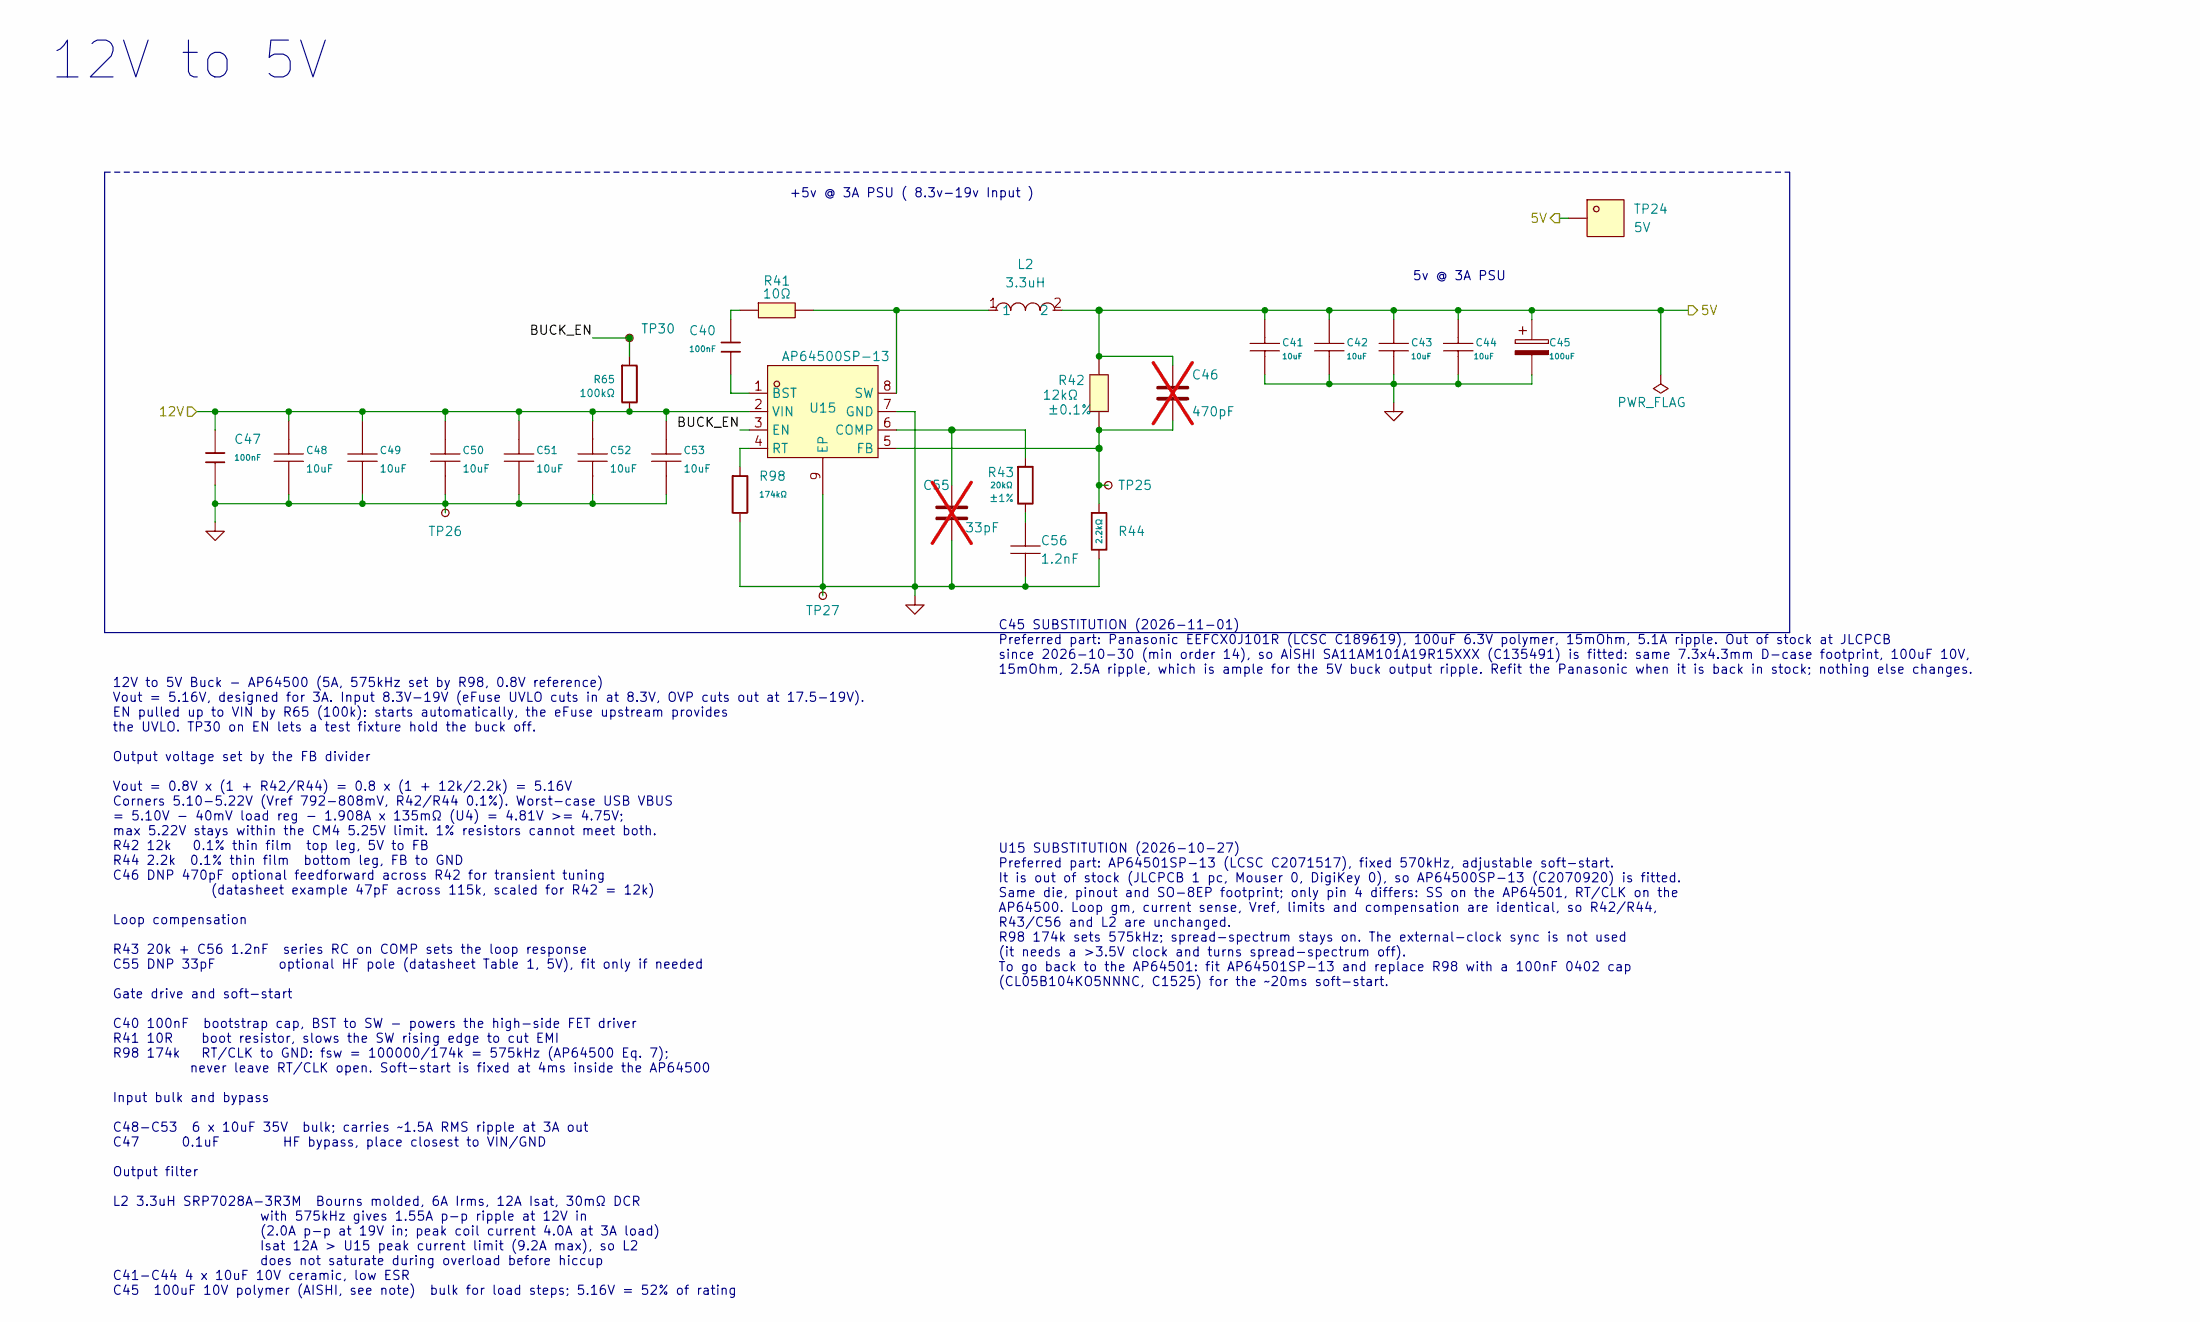
[picture p59: schematic power_5v.kicad_sch]

Parts:
C40: 100nF; CAPC1005X55N; Tolerance ±10%; Voltage Rating 16V; MPN CL05B104KO5NNNC; LCSC Part C1525
C41, C42, C43, C44: 10uF; CAPC2012X145N; Tolerance ±10%; Voltage Rating 10V; MPN CL21B106KPQNNNE; LCSC Part C32635
C45: 100uF; CAPMP7343X310N; Tolerance ±20%; Voltage Rating 10V; MPN SA11AM101A19R15XXX; LCSC Part C135491
C46: 470pF; CAPC1005X55N; not fitted
C47: 100nF; CAPC1608X95N; Tolerance ±10%; Voltage Rating 50V; MPN CC0603KRX7R9BB104; LCSC Part C14663
C48, C49, C50, C51, C52, C53: 10uF; CAPC2012X145N; Tolerance ±10%; Voltage Rating 35V; MPN GRM21BC8YA106KE11L; LCSC Part C469541
C55: 33pF; CAPC1005X55N; not fitted
C56: 1.2nF; CAPC1005X55N; Tolerance ±10%; Voltage Rating 50V; MPN CC0402KRX7R9BB122; LCSC Part C107021
L2: 3.3uH; INDM7366X280N; Tolerance ±20%; Current Rating 6A; MPN SRP7028A-3R3M; LCSC Part C913186
R41: 10Ω; RESC3216X70N; Tolerance ±1%; Voltage Rating 200V; MPN 1206W4F100JT5E; LCSC Part C17903
R42: 12kΩ; RESC1005X40N; Tolerance ±0.1%; Voltage Rating 50V; MPN RT0402BRD0712KL; LCSC Part C784579
R43: 20kΩ; RESC1005X40N; Tolerance ±1%; Voltage Rating 50V; MPN 0402WGF2002TCE; LCSC Part C25765
R44: 2.2kΩ; RESC1005X40N; Tolerance ±0.1%; Voltage Rating 50V; MPN RT0402BRD072K2L; LCSC Part C326602
R65: 100kΩ; RESC1005X40N; Tolerance ±1%; Voltage Rating 50V; MPN 0402WGF1003TCE; LCSC Part C25741
R98: 174kΩ; RESC1005X40N; Tolerance ±1%; Voltage Rating 50V; MPN 0402WGF1743TCE; LCSC Part C26994
TP24: 5V; TESTPOINT-SMD_L3.0-W2.0; MPN RH-5016; LCSC Part C5199799
TP25, TP26, TP27, TP30: TestPoint_Small; TestPoint_Pad_D0.8mm
U15: AP64500SP-13; SOIC127P600X170-9N; MPN AP64500SP-13; LCSC Part C2070920

Connections:
/5V: C41.2, C42.2, C43.2, C44.2, C45.1, C46.1, L2.2, R42.2, TP24.1 (1_1); also elsewhere on the board
/power/12V: C47.1, C48.2, C49.2, C50.2, C51.2, C52.2, C53.2, R65.2, U15.2 (VIN); also elsewhere on the board
/power/Power_5V/BUCK_EN: R65.1, TP30.1 (1_1), U15.3 (EN)
GND: C41.1, C42.1, C43.1, C44.1, C45.2, C47.2, C48.1, C49.1, C50.1, C51.1, C52.1, C53.1, C55.2, C56.1, R44.2, R98.2, TP26.1 (1_1), TP27.1 (1_1), U15.7 (GND), U15.9 (EP); also elsewhere on the board
unnamed: C40.1, R41.1
unnamed: C56.2, R43.2
unnamed: C40.2, U15.1 (BST)
unnamed: C55.1, R43.1, U15.6 (COMP)
unnamed: C46.2, R42.1, R44.1, TP25.1 (1_1), U15.5 (FB)
unnamed: R98.1, U15.4 (RT)
unnamed: L2.1, R41.2, U15.8 (SW)

Notes on the sheet:
12V to 5V
5v @ 3A PSU
+5v @ 3A PSU ( 8.3v-19v Input )
U15 SUBSTITUTION (2026-10-27) Preferred part: AP64501SP-13 (LCSC C2071517), fixed 570kHz, adjustable soft-start. It is out of stock (JLCPCB 1 pc, Mouser 0, DigiKey 0), so AP64500SP-13 (C2070920) is fitted. Same die, pinout and SO-8EP footprint; only pin 4 differs: SS on the AP64501, RT/CLK on the A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
12V to 5V Buck - AP64500 (5A, 575kHz set by R98, 0.8V reference) Vout = 5.16V, designed for 3A. Input 8.3V-19V (eFuse UVLO cuts in at 8.3V, OVP cuts out at 17.5-19V). EN pulled up to VIN by R65 (100k): starts automatically, the eFuse upstream provides the UVLO. TP30 on EN lets a test fixture hold t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
C45 SUBSTITUTION (2026-11-01) Preferred part: Panasonic EEFCX0J101R (LCSC C189619), 100uF 6.3V polymer, 15mOhm, 5.1A ripple. Out of stock at JLCPCB since 2026-10-30 (min order 14), so AISHI SA11AM101A19R15XXX (C135491) is fitted: same 7.3x4.3mm D-case footprint, 100uF 10V, 15mOhm, 2.5A ripple, whic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
