jrseti/roboclaw-cm4-dc-dish-controller/kicad/cm4-robo-controller.kicad_pcb

## KiCad design kicad/cm4-robo-controller.kicad_pcb (continued)

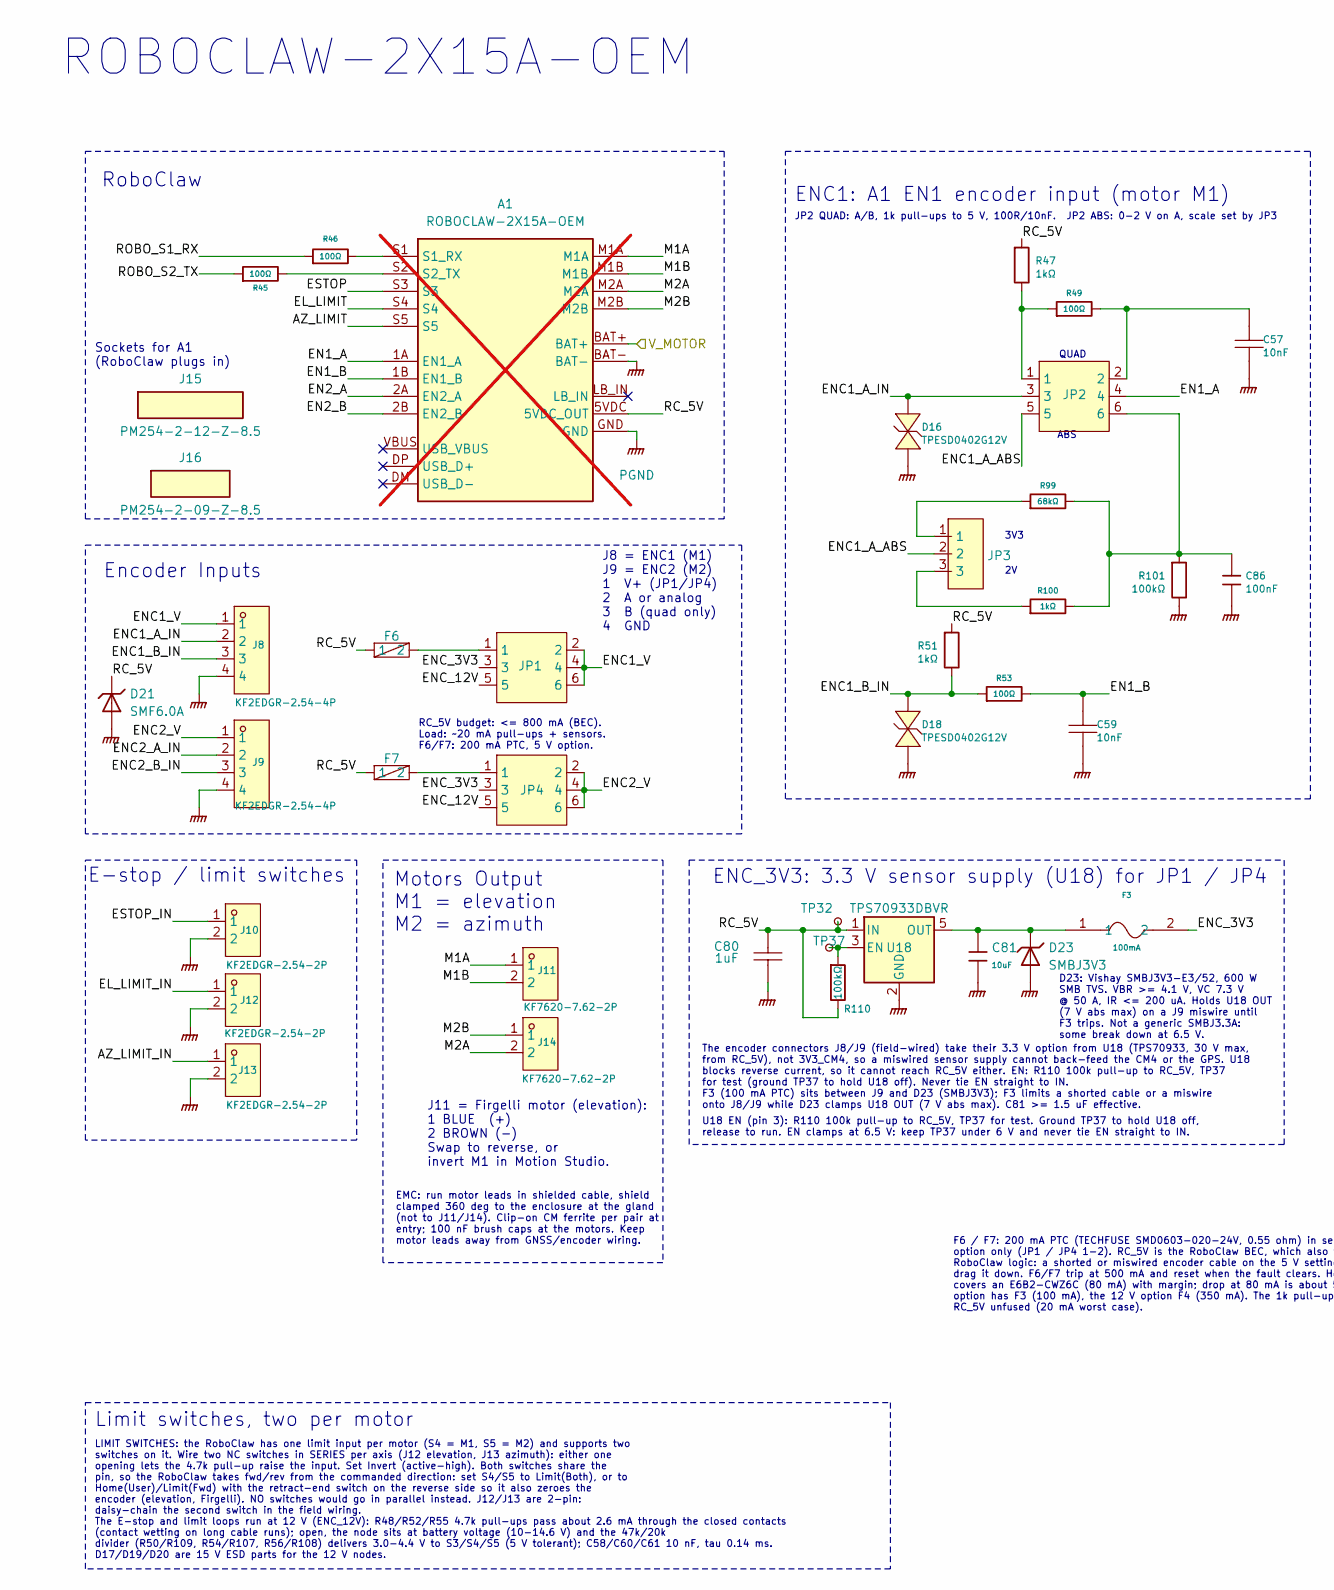
[picture p60: schematic robo.kicad_sch, RoboClaw 2x15A Motor Controller, part in row 1, column 1]

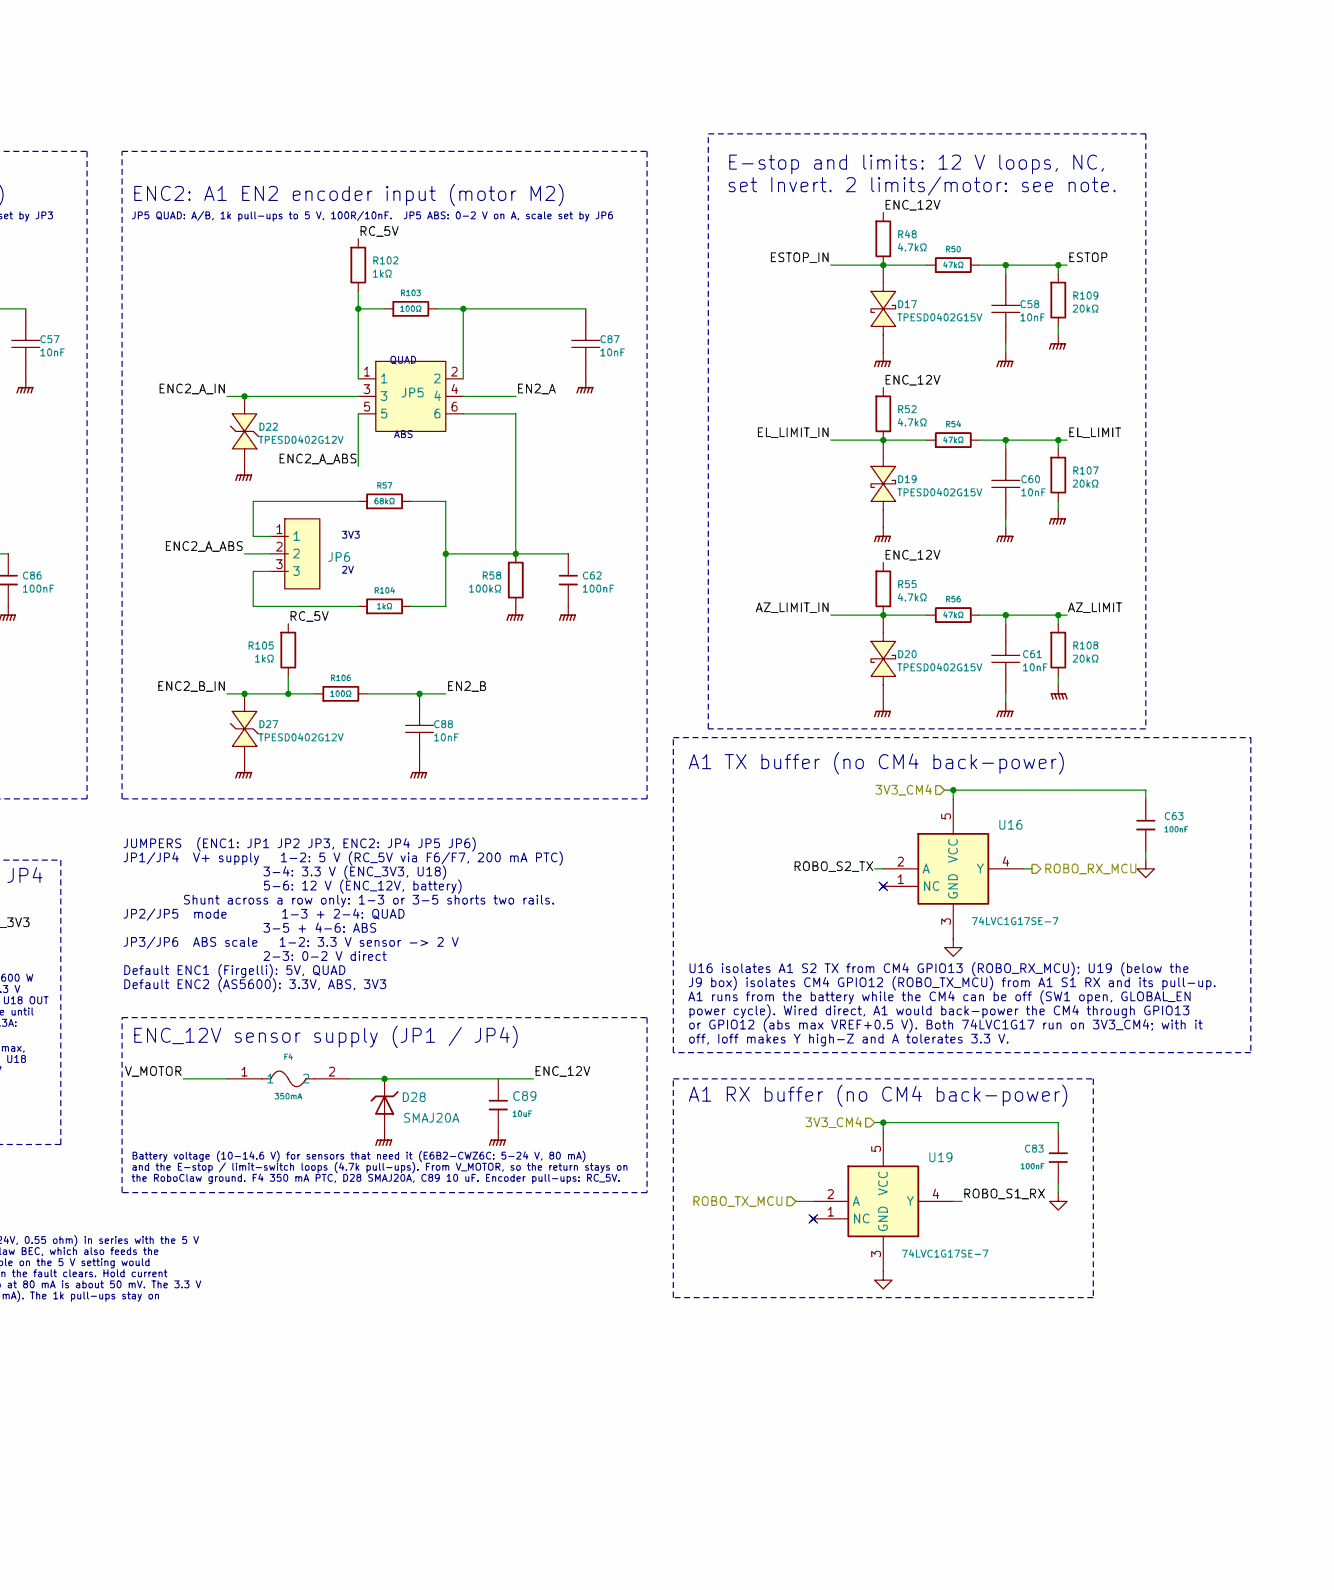
[picture p61: schematic robo.kicad_sch, RoboClaw 2x15A Motor Controller, part in row 1, column 2]

Parts:
A1: ROBOCLAW-2X15A-OEM; MOD-TH_ROBOCLAW-OEM-2X15A; MPN RoboClaw 2x15A OEM; LCSC Part N/A; not fitted
C57, C58, C59, C60, C61, C87, C88: 10nF; CAPC1005X55N; Voltage Rating 50V; Tolerance ±10%; MPN 0402B103K500CT; LCSC Part C301927
C62, C63, C83, C86: 100nF; CAPC1005X55N; Tolerance ±10%; Voltage Rating 16V; MPN CL05B104KO5NNNC; LCSC Part C1525
C80: 1uF; CAPC1608X95N; Tolerance ±10%; Voltage Rating 25V; MPN CL10A105KA8NNNC; LCSC Part C5673
C81, C89: 10uF; CAPC1608X95N; Tolerance ±20%; Voltage Rating 25V; MPN CL10A106MA8NRNC; LCSC Part C96446
D16, D18, D22, D27: TPESD0402G12V; DIOC1005X55N; MPN TPESD0402G12V; LCSC Part C558617
D17, D19, D20: TPESD0402G15V; DIOC1005X55N; MPN TPESD0402G15V; LCSC Part C558618
D21: SMF6.0A; SODFL3718X110N; MPN SMF6.0A; LCSC Part C19077499
D23: SMBJ3V3; DIOM5436X244N; MPN SMBJ3V3-E3/52; LCSC Part C82082
D28: SMAJ20A; DIOM5226X244N; MPN SMAJ20A; LCSC Part C41376408
F3: 100mA; FUSC3216X110N; MPN nSMD010; LCSC Part C70065
F4: 350mA; FUSC3216X110N; MPN 1206L035/60NR; LCSC Part C55109877
F6, F7: 200mA; FUSC1608X100N; MPN SMD0603-020-24V; LCSC Part C19108393
J8, J9: KF2EDGR-2.54-4P; CONN-TH_4P-P2.54_KF2EDGR-2.54-4P; MPN KF2EDGR-2.54-4P; LCSC Part C577596
J10, J12, J13: KF2EDGR-2.54-2P; CONN-TH_P2.54_KF2EDGR-2.54-2P; MPN KF2EDGR-2.54-2P; LCSC Part C577594
J11, J14: KF7620-7.62-2P; CONN-TH_P7.62_KF7620-7.62-2P; MPN KF7620-7.62-2P; LCSC Part C475104
J15: PM254-2-12-Z-8.5; HDR-F-TH_2x12-P2.54-H8.5_PM254_NOPADS; MPN PM254-2-12-Z-8.5; LCSC Part C2897413
J16: PM254-2-09-Z-8.5; HDR-F-TH_2x09-P2.54-H8.5_PM254_NOPADS; MPN PM254-2-09-Z-8.5; LCSC Part C2897410
JP1, JP2, JP4, JP5: Header-Male-2.54_2x3; HDR-TH_6P-P2.54-V-M-R2-C3-S2.54-1; MPN 2.54-2*3PPin; LCSC Part C65114
JP3, JP6: Header-Male-2.54_1x3; HDR-TH_3P-P2.54-V-M-1; MPN 2.54-1*3PPin; LCSC Part C49257
R45, R46, R49, R53, R103, R106: 100Ω; RESC1005X40N; Tolerance ±1%; Voltage Rating 50V; MPN 0402WGF1000TCE; LCSC Part C25076
R47, R51, R100, R102, R104, R105: 1kΩ; RESC1005X40N; Tolerance ±1%; Voltage Rating 50V; MPN 0402WGF1001TCE; LCSC Part C11702
R48, R52, R55: 4.7kΩ; RESC1608X55N; Tolerance ±1%; Voltage Rating 50V; MPN 0603WAF4701T5E; LCSC Part C23162
R50, R54, R56: 47kΩ; RESC1005X40N; Tolerance ±1%; Voltage Rating 50V; MPN 0402WGF4702TCE; LCSC Part C25792
R57, R99: 68kΩ; RESC1005X40N; Tolerance ±1%; Voltage Rating 50V; MPN 0402WGF6802TCE; LCSC Part C36871
R58, R101, R110: 100kΩ; RESC1005X40N; Tolerance ±1%; Voltage Rating 50V; MPN 0402WGF1003TCE; LCSC Part C25741
R107, R108, R109: 20kΩ; RESC1005X40N; Tolerance ±1%; Voltage Rating 50V; MPN 0402WGF2002TCE; LCSC Part C25765
TP32, TP37: TestPoint_Small; TestPoint_Pad_D0.8mm
U16, U19: 74LVC1G17SE-7; SOT65P210X110-5N; MPN 74LVC1G17SE-7; LCSC Part C212314
U18: TPS70933DBVR; SOT95P280X145-5N; MPN TPS70933DBVR; LCSC Part C89347

Connections:
/3V3_CM4: C63.1, C83.1, U16.5 (VCC), U19.5 (VCC); also elsewhere on the board
/CM4/ROBO_RX_MCU: U16.4 (Y); also elsewhere on the board
/CM4/ROBO_TX_MCU: U19.2 (A); also elsewhere on the board
/Robo/AZ_LIMIT: A1.S5, C61.1, R56.2, R108.1
/Robo/AZ_LIMIT_IN: D20.2, J13.1, R55.2, R56.1
/Robo/EL_LIMIT: A1.S4, C60.1, R54.2, R107.1
/Robo/EL_LIMIT_IN: D19.2, J12.1, R52.2, R54.1
/Robo/EN1_A: A1.1A (EN1_A), JP2.4
/Robo/EN1_B: A1.1B (EN1_B), C59.1, R53.2
/Robo/EN2_A: A1.2A (EN2_A), JP5.4
/Robo/EN2_B: A1.2B (EN2_B), C88.1, R106.2
/Robo/ENC1_A_ABS: JP2.5, JP3.2
/Robo/ENC1_A_IN: D16.2 (A), J8.2, JP2.3
/Robo/ENC1_B_IN: D18.2 (A), J8.3, R51.2, R53.1
/Robo/ENC1_V: J8.1, JP1.2, JP1.4, JP1.6
/Robo/ENC2_A_ABS: JP5.5, JP6.2
/Robo/ENC2_A_IN: D22.2 (A), J9.2, JP5.3
/Robo/ENC2_B_IN: D27.2 (A), J9.3, R105.2, R106.1
/Robo/ENC2_V: J9.1, JP4.2, JP4.4, JP4.6
/Robo/ENC_3V3: F3.2, JP1.3, JP4.3
/Robo/ENC_12V: C89.1, D28.1, F4.2, JP1.5, JP4.5, R48.1, R52.1, R55.1
/Robo/ESTOP: A1.S3, C58.1, R50.2, R109.1
/Robo/ESTOP_IN: D17.2, J10.1, R48.2, R50.1
/Robo/M1A: A1.M1A, J11.1
/Robo/M1B: A1.M1B, J11.2
/Robo/M2A: A1.M2A, J14.2
/Robo/M2B: A1.M2B, J14.1
/Robo/RC_5V: A1.5VDC (5VDC_OUT), C80.2, D21.1, F6.1, F7.1, R47.1, R51.1, R102.1, R105.1, R110.2, TP32.1 (1_1), U18.1 (IN)
/Robo/ROBO_S1_RX: R46.1, U19.4 (Y)
/Robo/ROBO_S2_TX: R45.1, U16.2 (A)
/Robo/V_MOTOR: A1.BAT+, F4.1; also elsewhere on the board
GND: C63.2, C83.2, U16.3 (GND), U19.3 (GND); also elsewhere on the board
unnamed: A1.S1 (S1_RX), R46.2
unnamed: A1.S2 (S2_TX), R45.2
unnamed: C57.1, JP2.2, R49.2
unnamed: C62.1, JP5.6, R57.2, R58.1, R104.2
unnamed: C86.1, JP2.6, R99.2, R100.2, R101.1
unnamed: C87.1, JP5.2, R103.2
unnamed: F6.2, JP1.1
unnamed: F7.2, JP4.1
unnamed: JP2.1, R47.2, R49.1
unnamed: JP3.1, R99.1
unnamed: JP3.3, R100.1
unnamed: JP5.1, R102.2, R103.1
unnamed: JP6.1, R57.1
unnamed: JP6.3, R104.1
unnamed: R110.1, TP37.1 (1_1), U18.3 (EN)
unnamed: C81.1, D23.1, F3.1, U18.5 (OUT)
PGND: A1.BAT-, A1.GND, C57.2, C58.2, C59.2, C60.2, C61.2, C62.2, C80.1, C81.2, C86.2, C87.2, C88.2, C89.2, D16.1 (K), D17.1, D18.1 (K), D19.1, D20.1, D21.2, D22.1 (K), D23.2, D27.1 (K), D28.2, J8.4, J9.4, J10.2, J12.2, J13.2, R58.2, R101.2, R107.2, R108.2, R109.2, U18.2 (GND); also elsewhere on the board

Notes on the sheet:
QUAD
F6 / F7: 200 mA PTC (TECHFUSE SMD0603-020-24V, 0.55 ohm) in series with the 5 V option only (JP1 / JP4 1-2). RC_5V is the RoboClaw BEC, which also feeds the RoboClaw logic: a shorted or miswired encoder cable on the 5 V setting would drag it down. F6/F7 trip at 500 mA and reset when the fault clear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
The encoder connectors J8/J9 (field-wired) take their 3.3 V option from U18 (TPS70933, 30 V max, from RC_5V), not 3V3_CM4, so a miswired sensor supply cannot back-feed the CM4 or the GPS. U18 blocks reverse current, so it cannot reach RC_5V either. EN: R110 100k pull-up to RC_5V, TP37 for test (gro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
ABS
3V3
Encoder Inputs
A1 TX buffer (no CM4 back-power)
Sockets for A1 (RoboClaw plugs in)
E-stop / limit switches
ENC_12V sensor supply (JP1 / JP4)
JP5 QUAD: A/B, 1k pull-ups to 5 V, 100R/10nF. JP5 ABS: 0-2 V on A, scale set by JP6
Limit switches, two per motor
RoboClaw
ENC1: A1 EN1 encoder input (motor M1)
JP2 QUAD: A/B, 1k pull-ups to 5 V, 100R/10nF. JP2 ABS: 0-2 V on A, scale set by JP3
ENC2: A1 EN2 encoder input (motor M2)
U16 isolates A1 S2 TX from CM4 GPIO13 (ROBO_RX_MCU); U19 (below the J9 box) isolates CM4 GPIO12 (ROBO_TX_MCU) from A1 S1 RX and its pull-up. A1 runs from the battery while the CM4 can be off (SW1 open, GLOBAL_EN power cycle). Wired direct, A1 would back-power the CM4 through GPIO13 or GPIO12 (abs m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
D23: Vishay SMBJ3V3-E3/52, 600 W SMB TVS. VBR >= 4.1 V, VC 7.3 V @ 50 A, IR <= 200 uA. Holds U18 OUT (7 V abs max) on a J9 miswire until F3 trips. Not a generic SMBJ3.3A: some break down at 6.5 V.
JUMPERS (ENC1: JP1 JP2 JP3, ENC2: JP4 JP5 JP6) JP1/JP4 V+ supply 1-2: 5 V (RC_5V via F6/F7, 200 mA PTC) 3-4: 3.3 V (ENC_3V3, U18) 5-6: 12 V (ENC_12V, battery) Shunt across a row only: 1-3 or 3-5 shorts two rails. JP2/JP5 mode 1-3 + 2-4: QUAD 3-5 + 4-6: ABS JP3/JP6 ABS scale 1-2: 3.3 V sensor -> 2 V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
LIMIT SWITCHES: the RoboClaw has one limit input per motor (S4 = M1, S5 = M2) and supports two switches on it. Wire two NC switches in SERIES per axis (J12 elevation, J13 azimuth): either one opening lets the 4.7k pull-up raise the input. Set Invert (active-high). Both switches share the pin, so th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
U18 EN (pin 3): R110 100k pull-up to RC_5V, TP37 for test. Ground TP37 to hold U18 off, release to run. EN clamps at 6.5 V: keep TP37 under 6 V and never tie EN straight to IN.
EMC: run motor leads in shielded cable, shield clamped 360 deg to the enclosure at the gland (not to J11/J14). Clip-on CM ferrite per pair at entry; 100 nF brush caps at the motors. Keep motor leads away from GNSS/encoder wiring.
J11 = Firgelli motor (elevation): 1 BLUE (+) 2 BROWN (-) Swap to reverse, or invert M1 in Motion Studio.
E-stop and limits: 12 V loops, NC, set Invert. 2 limits/motor: see note.
Motors Output M1 = elevation M2 = azimuth
RC_5V budget: <= 800 mA (BEC). Load: ~20 mA pull-ups + sensors. F6/F7: 200 mA PTC, 5 V option.
Battery voltage (10-14.6 V) for sensors that need it (E6B2-CWZ6C: 5-24 V, 80 mA) and the E-stop / limit-switch loops (4.7k pull-ups). From V_MOTOR, so the return stays on the RoboClaw ground. F4 350 mA PTC, D28 SMAJ20A, C89 10 uF. Encoder pull-ups: RC_5V.
A1 RX buffer (no CM4 back-power)
ROBOCLAW-2X15A-OEM
ENC_3V3: 3.3 V sensor supply (U18) for JP1 / JP4
J8 = ENC1 (M1) J9 = ENC2 (M2) 1 V+ (JP1/JP4) 2 A or analog 3 B (quad only) 4 GND

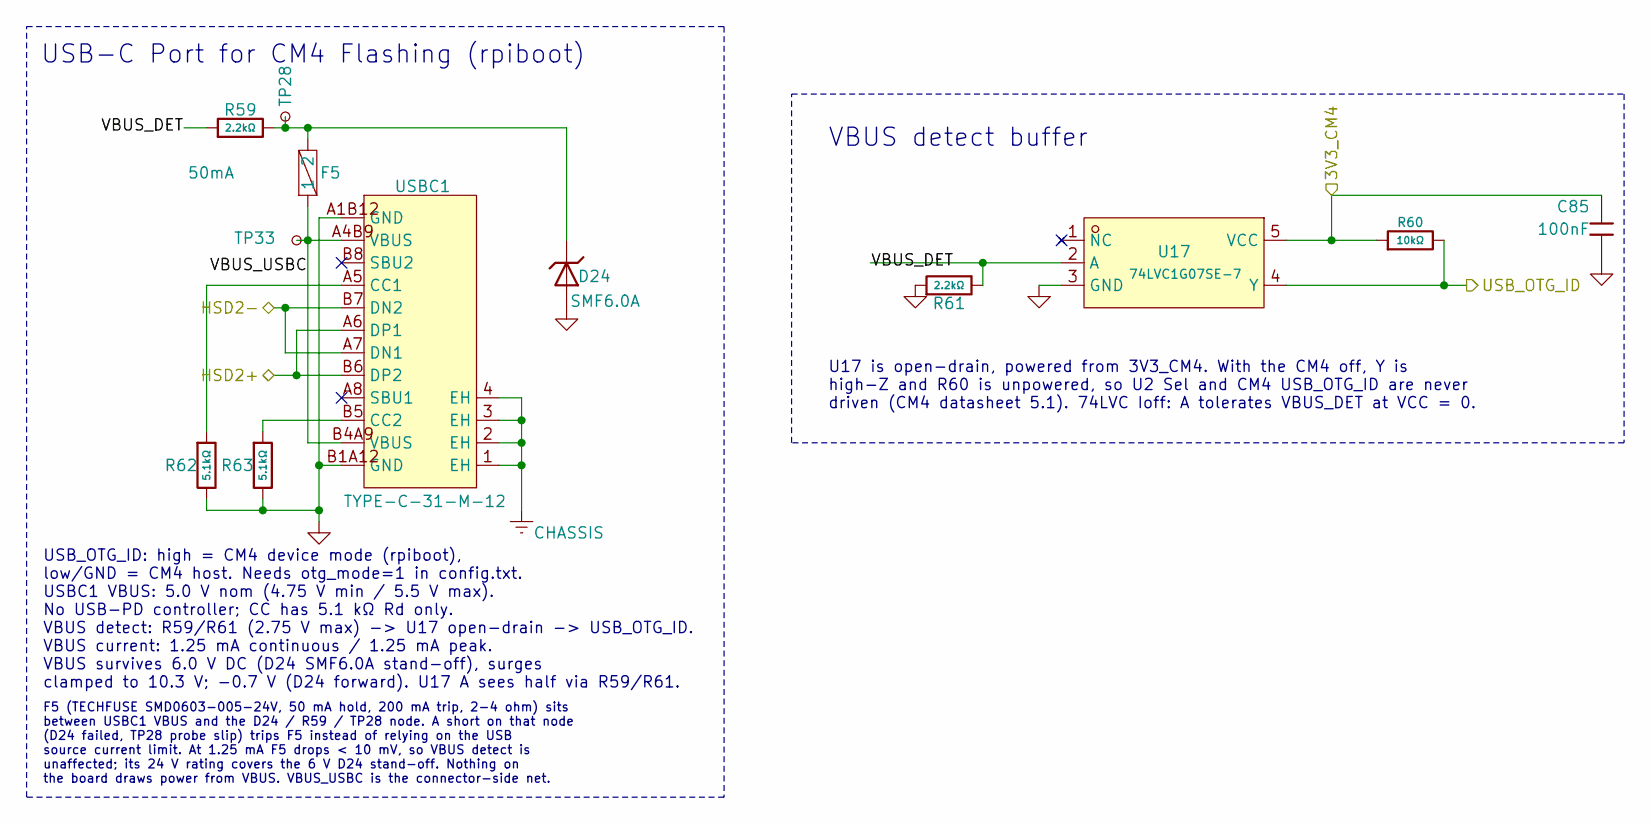
[picture p62: schematic usb2.kicad_sch, USB-C rpiboot port]

Parts:
C85: 100nF; CAPC1005X55N; Tolerance ±10%; Voltage Rating 16V; MPN CL05B104KO5NNNC; LCSC Part C1525
D24: SMF6.0A; SODFL3718X110N; MPN SMF6.0A; LCSC Part C19077499
F5: 50mA; FUSC1608X100N; MPN SMD0603-005-24V; LCSC Part C70046
R59, R61: 2.2kΩ; RESC1005X40N; Tolerance ±1%; Voltage Rating 50V; MPN 0402WGF2201TCE; LCSC Part C25879
R60: 10kΩ; RESC1005X40N; Tolerance ±1%; Voltage Rating 50V; MPN 0402WGF1002TCE; LCSC Part C25744
R62, R63: 5.1kΩ; RESC1005X40N; Tolerance ±1%; Voltage Rating 50V; MPN 0402WGF5101TCE; LCSC Part C25905
TP28, TP33: TestPoint_Small; TestPoint_Pad_D0.8mm
U17: 74LVC1G07SE-7; SOT65P210X110-5N; MPN 74LVC1G07SE-7; LCSC Part C67531
USBC1: TYPE-C-31-M-12; USB-C_SMD-TYPE-C-31-M-12_1; MPN TYPE-C-31-M-12; LCSC Part C165948

Connections:
/3V3_CM4: C85.1, R60.1, U17.5 (VCC); also elsewhere on the board
/CM4/USB_OTG_ID: R60.2, U17.4 (Y); also elsewhere on the board
/CM4/usb/HSD2+: USBC1.A6 (DP1), USBC1.B6 (DP2); also elsewhere on the board
/CM4/usb/HSD2-: USBC1.A7 (DN1), USBC1.B7 (DN2); also elsewhere on the board
/CM4/usb/usb2/VBUS_DET: R59.1, R61.2, U17.2 (A)
/CM4/usb/usb2/VBUS_USBC: F5.1, TP33.1 (1_1), USBC1.A4B9 (VBUS), USBC1.B4A9 (VBUS)
CHASSIS: USBC1.1 (EH), USBC1.2 (EH), USBC1.3 (EH), USBC1.4 (EH); also elsewhere on the board
GND: C85.2, D24.2, R61.1, R62.2, R63.2, U17.3 (GND), USBC1.A1B12 (GND), USBC1.B1A12 (GND); also elsewhere on the board
unnamed: D24.1, F5.2, R59.2, TP28.1 (1_1)
unnamed: R62.1, USBC1.A5 (CC1)
unnamed: R63.1, USBC1.B5 (CC2)

Notes on the sheet:
USB-C Port for CM4 Flashing (rpiboot)
U17 is open-drain, powered from 3V3_CM4. With the CM4 off, Y is high-Z and R60 is unpowered, so U2 Sel and CM4 USB_OTG_ID are never driven (CM4 datasheet 5.1). 74LVC Ioff: A tolerates VBUS_DET at VCC = 0.
USB_OTG_ID: high = CM4 device mode (rpiboot), low/GND = CM4 host. Needs otg_mode=1 in config.txt. USBC1 VBUS: 5.0 V nom (4.75 V min / 5.5 V max). No USB-PD controller; CC has 5.1 kΩ Rd only. VBUS detect: R59/R61 (2.75 V max) -> U17 open-drain -> USB_OTG_ID. VBUS current: 1.25 mA continuous / 1.25 m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
F5 (TECHFUSE SMD0603-005-24V, 50 mA hold, 200 mA trip, 2-4 ohm) sits between USBC1 VBUS and the D24 / R59 / TP28 node. A short on that node (D24 failed, TP28 probe slip) trips F5 instead of relying on the USB source current limit. At 1.25 mA F5 drops < 10 mV, so VBUS detect is unaffected; its 24 V 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
VBUS detect buffer

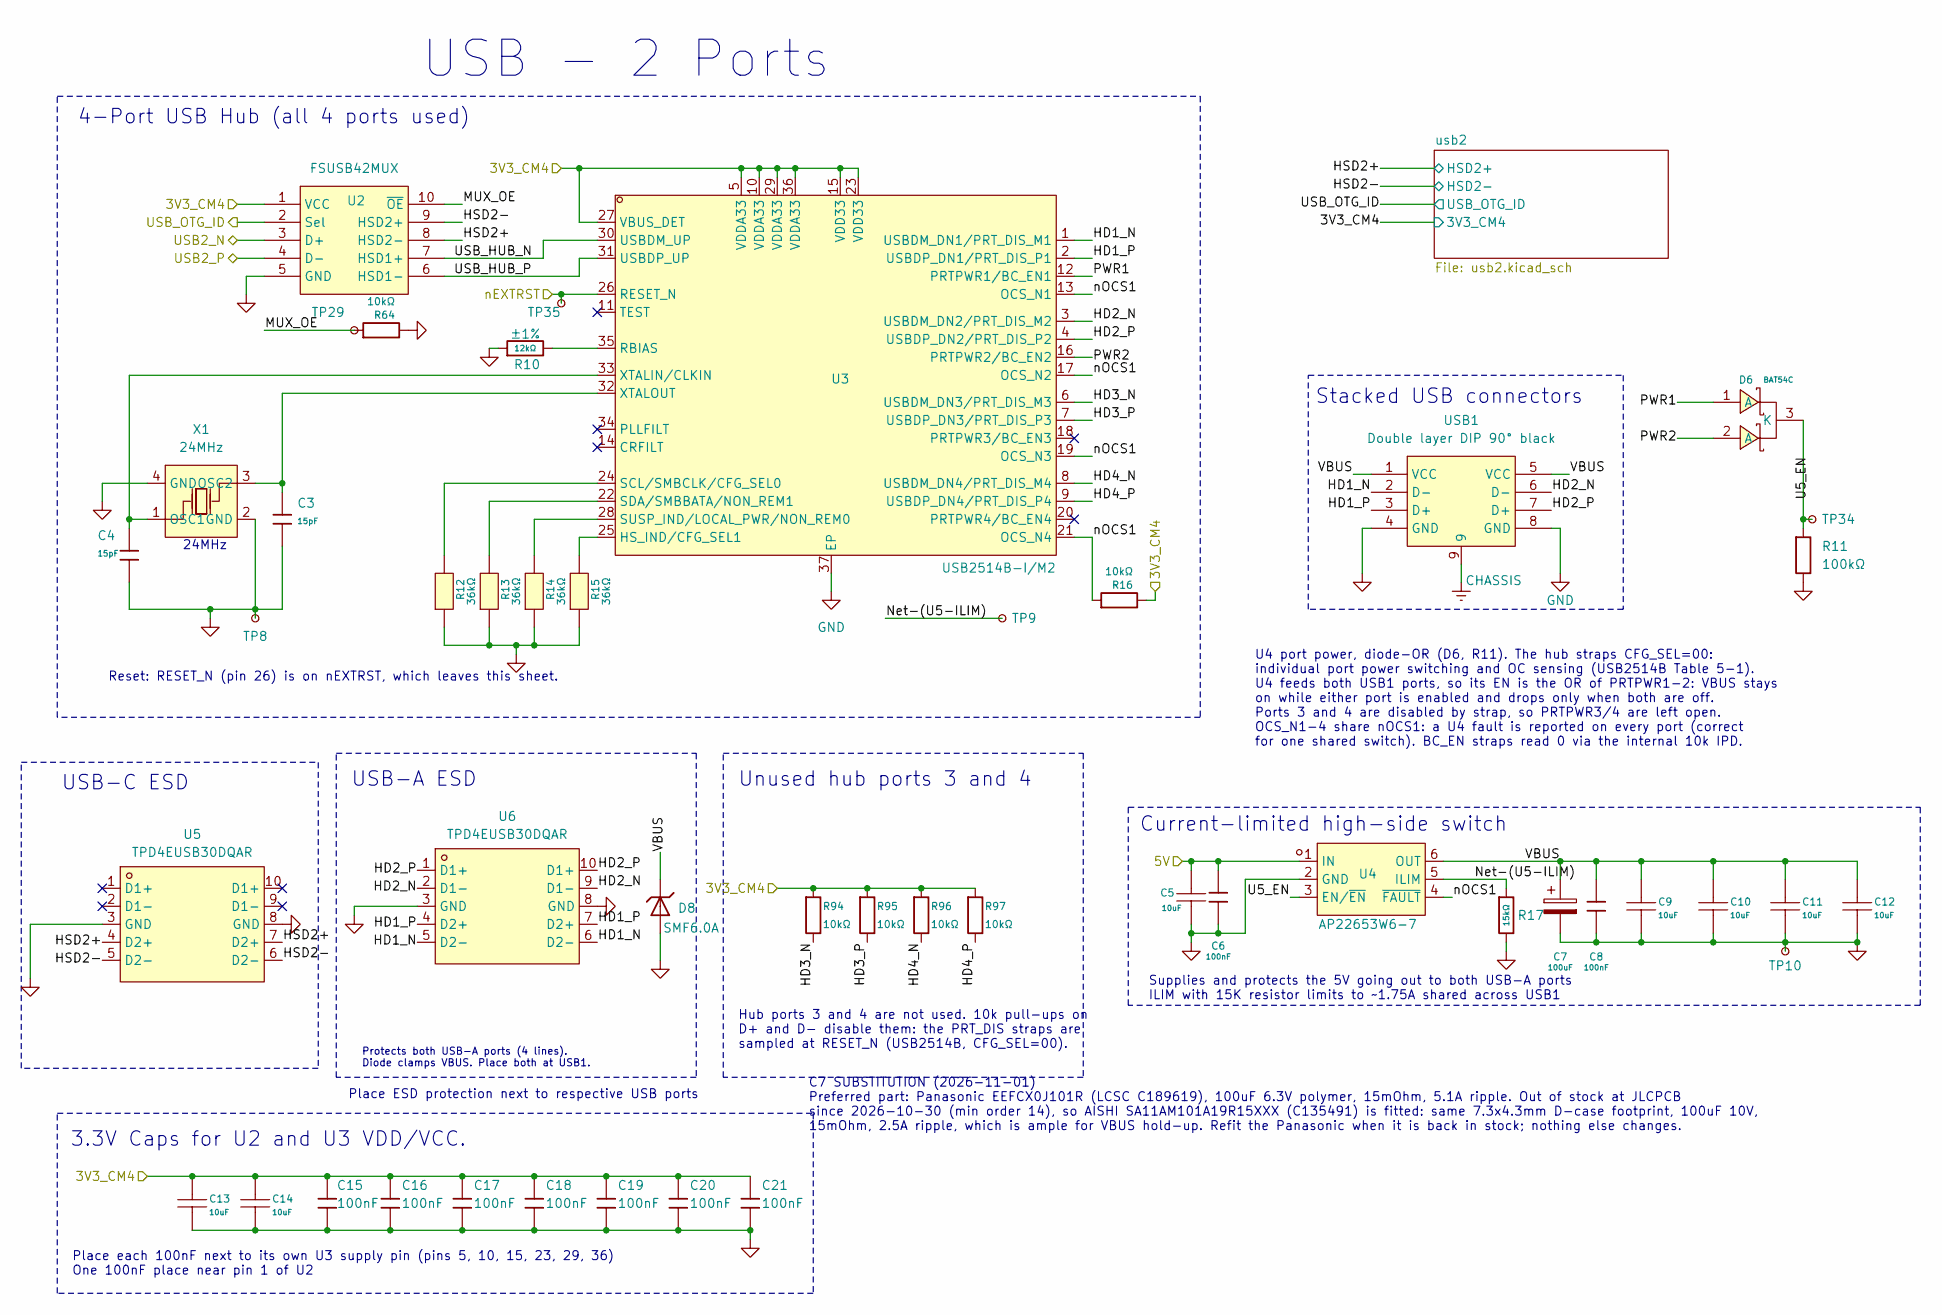
[picture p63: schematic usb.kicad_sch]

Parts:
C3, C4: 15pF; CAPC1005X55N; Tolerance ±5%; Voltage Rating 50V; MPN 0402CG150J500NT; LCSC Part C1548
C5, C9, C10, C11, C12, C13: 10uF; CAPC2012X145N; Tolerance ±10%; Voltage Rating 10V; MPN CL21B106KPQNNNE; LCSC Part C32635
C6, C8, C15, C16, C17, C18, C19, C20, C21: 100nF; CAPC1005X55N; Tolerance ±10%; Voltage Rating 16V; MPN CL05B104KO5NNNC; LCSC Part C1525
C7: 100uF; CAPMP7343X310N; Tolerance ±20%; Voltage Rating 10V; MPN SA11AM101A19R15XXX; LCSC Part C135491
C14: 10uF; CAPC2012X145N; VOLTAGE RATING 10V; Tolerance ±10%; MPN CL21B106KPQNNNE; LCSC Part C32635
D6: BAT54C; SOT95P280X110-3N; MPN BAT54C,215; LCSC Part C37704
D8: SMF6.0A; SODFL3718X110N; MPN SMF6.0A; LCSC Part C19077499
R10: 12kΩ; RESC1005X40N; Tolerance ±1%; Voltage Rating 50V; MPN 0402WGF1202TCE; LCSC Part C25752
R11: 100kΩ; RESC1608X55N; Tolerance ±1%; Voltage Rating 75V; MPN 0603WAF1003T5E; LCSC Part C25803
R12, R13, R14, R15: 36kΩ; RESC1005X40N; Tolerance ±1%; Voltage Rating 50V; MPN FRC0402F3602TS; LCSC Part C2930004
R16, R64, R94, R95, R96, R97: 10kΩ; RESC1005X40N; Tolerance ±1%; Voltage Rating 50V; MPN 0402WGF1002TCE; LCSC Part C25744
R17: 15kΩ; RESC1005X40N; Tolerance ±1%; Voltage Rating 50V; MPN 0402WGF1502TCE; LCSC Part C25756
TP8, TP9, TP10, TP29, TP34, TP35: TestPoint_Small; TestPoint_Pad_D0.8mm
U2: FSUSB42MUX; SOP50P500X110-10N; MPN FSUSB42MUX; LCSC Part C11355
U3: USB2514B-I/M2; QFN50P600X600X100-37N; MPN USB2514B-I/M2; LCSC Part C220679
U4: AP22653W6-7; SOT95P280X145-6N; MPN AP22653W6-7; LCSC Part C2158037
U5, U6: TPD4EUSB30DQAR; SON50P100X250X60-10N; MPN TPD4EUSB30DQAR; LCSC Part C90627
USB1: Double layer DIP 90° black; USB-A-TH_USB-M-51; MPN 907-111A1022D10200; LCSC Part C12049
X1: 24MHz; CRYSTAL-SMD_4P-L3.2-W2.5-BL; Frequency Tolerance ±10ppm; MPN X322524MOB4SI; LCSC Part C70590

Connections:
/3V3_CM4: C13.2, C14.2, C15.1, C16.1, C17.1, C18.1, C19.1, C20.1, C21.1, R16.2, R94.1, R95.1, R96.1, R97.1, U2.1 (VCC), U3.5 (VDDA33), U3.10 (VDDA33), U3.15 (VDD33), U3.23 (VDD33), U3.27 (VBUS_DET), U3.29 (VDDA33), U3.36 (VDDA33); also elsewhere on the board
/5V: C5.2, C6.1, U4.1 (IN); also elsewhere on the board
/CM4/USB2_N: U2.3 (D+); also elsewhere on the board
/CM4/USB2_P: U2.4 (D-); also elsewhere on the board
/CM4/USB_OTG_ID: U2.2 (Sel); also elsewhere on the board
/CM4/nEXTRST: TP35.1 (1_1), U3.26 (RESET_N); also elsewhere on the board
/CM4/usb/HD1_N: U3.1 (USBDM_DN1/PRT_DIS_M1), U6.5 (D2-), U6.6 (D2-), USB1.2 (D-)
/CM4/usb/HD1_P: U3.2 (USBDP_DN1/PRT_DIS_P1), U6.4 (D2+), U6.7 (D2+), USB1.3 (D+)
/CM4/usb/HD2_N: U3.3 (USBDM_DN2/PRT_DIS_M2), U6.2 (D1-), U6.9 (D1-), USB1.6 (D-)
/CM4/usb/HD2_P: U3.4 (USBDP_DN2/PRT_DIS_P2), U6.1 (D1+), U6.10 (D1+), USB1.7 (D+)
/CM4/usb/HD3_N: R94.2, U3.6 (USBDM_DN3/PRT_DIS_M3)
/CM4/usb/HD3_P: R95.2, U3.7 (USBDP_DN3/PRT_DIS_P3)
/CM4/usb/HD4_N: R96.2, U3.8 (USBDM_DN4/PRT_DIS_M4)
/CM4/usb/HD4_P: R97.2, U3.9 (USBDP_DN4/PRT_DIS_P4)
/CM4/usb/HSD2+: U2.8 (HSD2-), U5.4 (D2+), U5.7 (D2+); also elsewhere on the board
/CM4/usb/HSD2-: U2.9 (HSD2+), U5.5 (D2-), U5.6 (D2-); also elsewhere on the board
/CM4/usb/MUX_OE: R64.1, TP29.1 (1_1), U2.10 (~OE)
/CM4/usb/Net-(U5-ILIM): R17.1, TP9.1 (1_1), U4.5 (ILIM)
/CM4/usb/PWR1: D6.1 (A), U3.12 (PRTPWR1/BC_EN1)
/CM4/usb/PWR2: D6.2 (A), U3.16 (PRTPWR2/BC_EN2)
/CM4/usb/U5_EN: D6.3 (K), R11.1, TP34.1 (1_1), U4.3 (EN/~EN)
/CM4/usb/USB_HUB_N: U2.7 (HSD1+), U3.30 (USBDM_UP)
/CM4/usb/USB_HUB_P: U2.6 (HSD1-), U3.31 (USBDP_UP)
/CM4/usb/VBUS: C7.1, C8.1, C9.2, C10.2, C11.2, C12.2, D8.1, U4.6 (OUT), USB1.1 (VCC), USB1.5 (VCC)
/CM4/usb/nOCS1: R16.1, U3.13 (OCS_N1), U3.17 (OCS_N2), U3.19 (OCS_N3), U3.21 (OCS_N4), U4.4 (~FAULT)
CHASSIS: USB1.9; also elsewhere on the board
GND: C3.2, C4.2, C5.1, C6.2, C7.2, C8.2, C9.1, C10.1, C11.1, C12.1, C13.1, C14.1, C15.2, C16.2, C17.2, C18.2, C19.2, C20.2, C21.2, D8.2, R10.1, R11.2, R12.1, R13.1, R14.1, R15.1, R17.2, R64.2, TP8.1 (1_1), TP10.1 (1_1), U2.5 (GND), U3.37 (EP), U4.2 (GND), U5.3 (GND), U5.8 (GND), U6.3 (GND), U6.8 (GND), USB1.4 (GND), USB1.8 (GND), X1.2 (GND), X1.4 (GND); also elsewhere on the board
unnamed: R15.2, U3.25 (HS_IND/CFG_SEL1)
unnamed: R10.2, U3.35 (RBIAS)
unnamed: R12.2, U3.24 (SCL/SMBCLK/CFG_SEL0)
unnamed: R13.2, U3.22 (SDA/SMBBATA/NON_REM1)
unnamed: R14.2, U3.28 (SUSP_IND/LOCAL_PWR/NON_REM0)
unnamed: C4.1, U3.33 (XTALIN/CLKIN), X1.1 (OSC1)
unnamed: C3.1, U3.32 (XTALOUT), X1.3 (OSC2)

Notes on the sheet:
3.3V Caps for U2 and U3 VDD/VCC.
USB-A ESD
Place each 100nF next to its own U3 supply pin (pins 5, 10, 15, 23, 29, 36) One 100nF place near pin 1 of U2
Current-limited high-side switch
Supplies and protects the 5V going out to both USB-A ports ILIM with 15K resistor limits to ~1.75A shared across USB1
Reset: RESET_N (pin 26) is on nEXTRST, which leaves this sheet.
Hub ports 3 and 4 are not used. 10k pull-ups on D+ and D- disable them: the PRT_DIS straps are sampled at RESET_N (USB2514B, CFG_SEL=00).
24MHz
USB-C ESD
U4 port power, diode-OR (D6, R11). The hub straps CFG_SEL=00: individual port power switching and OC sensing (USB2514B Table 5-1). U4 feeds both USB1 ports, so its EN is the OR of PRTPWR1-2: VBUS stays on while either port is enabled and drops only when both are off. Ports 3 and 4 are disabled by s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
USB - 2 Ports
C7 SUBSTITUTION (2026-11-01) Preferred part: Panasonic EEFCX0J101R (LCSC C189619), 100uF 6.3V polymer, 15mOhm, 5.1A ripple. Out of stock at JLCPCB since 2026-10-30 (min order 14), so AISHI SA11AM101A19R15XXX (C135491) is fitted: same 7.3x4.3mm D-case footprint, 100uF 10V, 15mOhm, 2.5A ripple, which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
Stacked USB connectors
Place ESD protection next to respective USB ports
Unused hub ports 3 and 4
4-Port USB Hub (all 4 ports used)
Protects both USB-A ports (4 lines). Diode clamps VBUS. Place both at USB1.

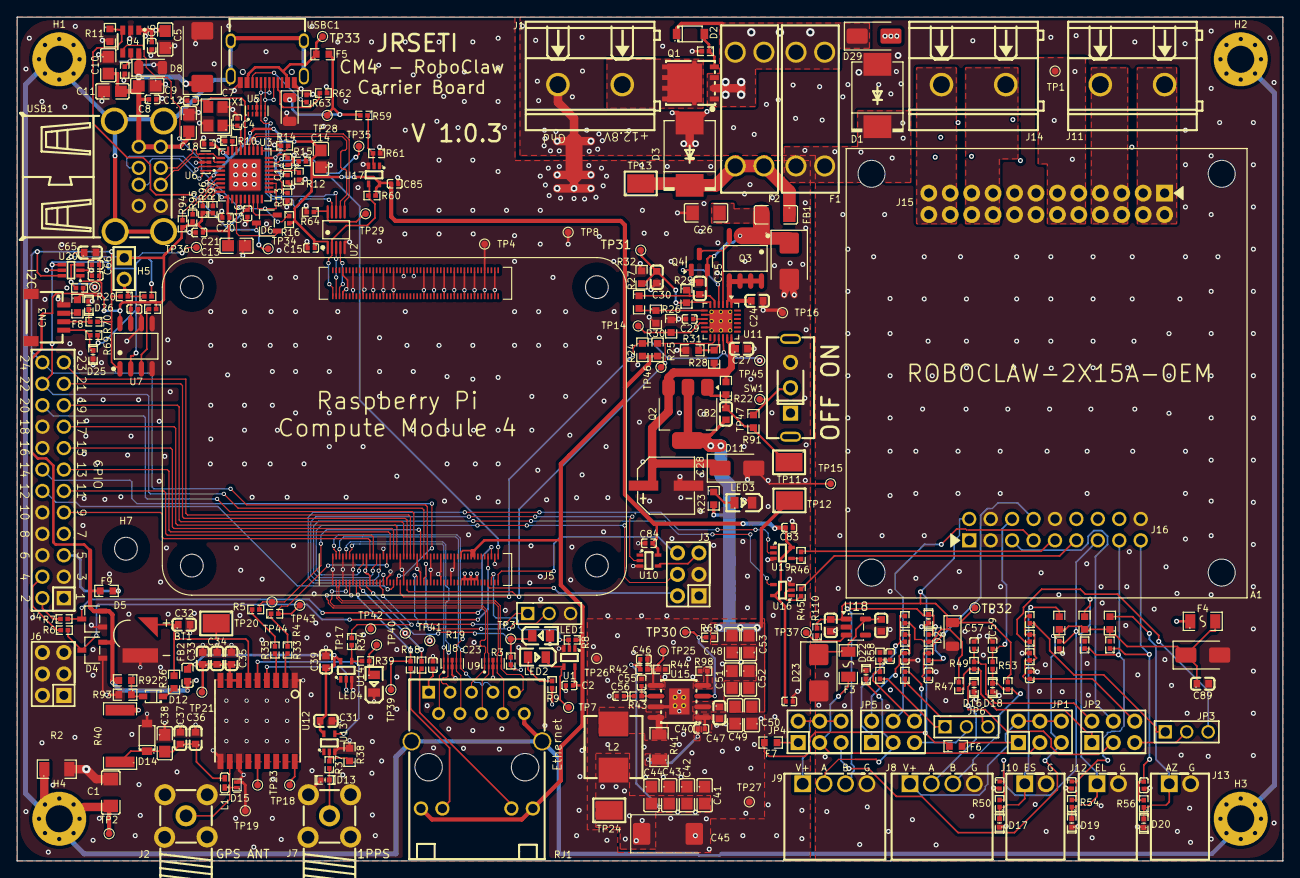
[picture p64: board cm4-robo-controller.kicad_pcb from above]

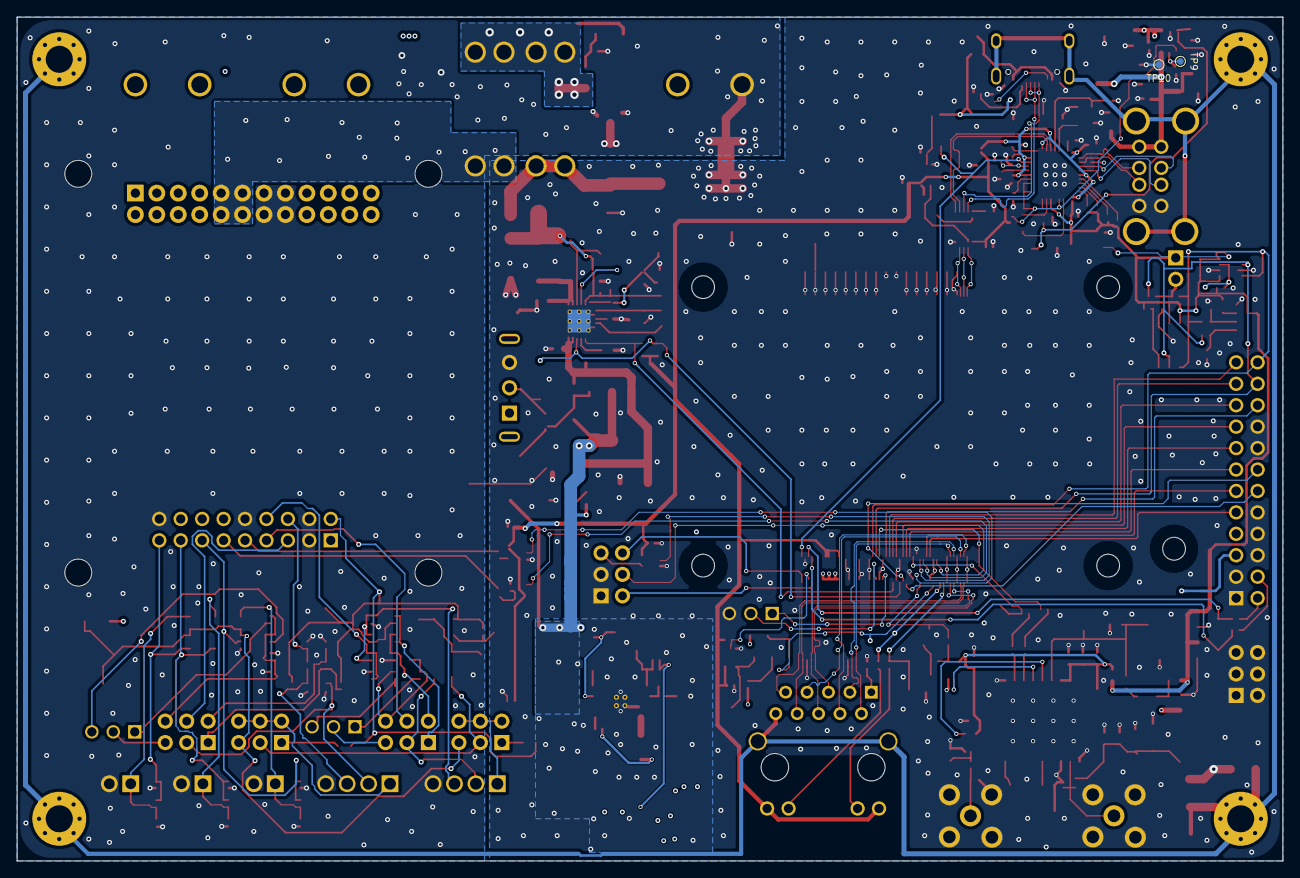
[picture p65: board cm4-robo-controller.kicad_pcb from below]

Board: 4 copper layers, 150.0 x 100.0 mm, 316 parts (2 on the bottom side), 184 nets.

Other parts of the board:
C1: 4.7nF; CAPC3216X180N
H1, H2, H3, H4: M3; MountingHole_3.2mm_M3_Pad_Via
H7: M2.5; MountingHole_2.7mm_M2.5
NT1: NetTie; NetTie-2_SMD_Pad2.0mm
R2: 1MΩ; RESC3216X70N
TP1, TP2: TestPoint_Small; TestPoint_Pad_D0.8mm

Their connections:
/Robo/V_MOTOR: TP1.1 (1_1); also elsewhere on the board
CHASSIS: C1.1, H1.1 (1_1), H2.1 (1_1), H3.1 (1_1), H4.1 (1_1), R2.1, TP2.1 (1_1); also elsewhere on the board
GND: C1.2, NT1.2, R2.2; also elsewhere on the board
PGND: NT1.1; also elsewhere on the board
