jrseti/roboclaw-cm4-dc-dish-controller/(commit log)

2026-10-11 GPIO connectors defined
2026-10-12 schematic cleanup
2026-10-17 Added new sheets, motor notes
2026-10-18 IPC footprint renaming, battery sim added
2026-10-18 Added power sim
2026-10-19 Schematic minot cleanup
2026-10-19 Readme and schematic PDF update
2026-10-21 PCB placement and routing snapshot before layout rework
    Power, battery-input, Power_5V (AP64501 per datasheet Figure 31) and Robo
    sheets placed and routed; CHASSIS bonding for H1-H4; board outline at
    60-210 x 49.6-139.6.
    Footprint fixes: U11 thermal vias 0.3 mm drill; U15 exposed-pad holes
    numbered as pad 9 (GND). Net classes for high-current nets.
2026-10-21 PCB rework: rotate RoboClaw, battery input at top, planes redrawn, right half routed
    - A1 rotated 90 CW and moved down; J14/J11 motor pours straight to the A1 pins
    - J14 pins swapped (M2 polarity) in the schematic; J14 moved clear of D1
    - Battery input, fuses and TVS diodes along the top edge; NT1 at J1-
    - In1 (GND/PGND) and In2 (5V/V_MOTOR) split redrawn for the new layout
    - Power block re-routed; 12V fed to the buck input on B.Cu
    - UART buffers back on logic GND; RoboClaw signal section routed
2026-10-21 PCB: place GPS and USB sheet components
    GPS: RF chain (L1, D15) and antenna bias network at CN1, 1PPS input
    chain (U13, R37/R38, C34, D13) by J7, backup cell row, LED and test
    points grouped.
    USB: ESD at each connector (U5 at USB-C, U6 at USB1, U7 at J2), VBUS
    TVS at the ports, CC and VBUS-detect resistors at USBC1, hub crystal,
    strap and decoupling parts tight around U3, MUX_OE parts by U2, port
    power (U4 and caps) grouped by C7. TP8 moved to the left edge.
    Reference labels normalized to 0.8 mm and placed clear of bodies.
    Removed a dangling GND stub and via left by the old R64 position.
2026-10-21 PCB: decoupling caps at IC supply pins, route GPS area
    - Add 100nF decoupling for U10 (C84) and U17 (C85)
    - Move C15, C18, C21, C25, C27, C32 next to their IC supply pins; shift R10
    - Route the GPS section: RF_IN, antenna bias, GPS VCC, V_BCKP, local signals, GND/5V plane vias
2026-10-21 PCB: route the USB differential pairs
    - HD1-HD4, hub upstream, USB2 to CM4 and HSD2 to USB-C routed as 90 ohm pairs
    - ESD parts (U5/U6/U7) routed flow-through: used N.C. pins tied to their lines
    - Swap hub ports at J2 (HD3<->HD4) and USB1 (HD1<->HD2) to avoid pair crossings
    - Move U6, U5, R63, R64, R14, C15, C18 to make room for the escapes
2026-10-22 PCB: swap GPS and USB areas, drop J2 and hub ports 3/4, remap J4
    - Remove expansion header J2 with C22, U7, D9 and D7; disable USB2514B
    ports 3 and 4 with 10k pull-ups (R94-R97) on their D-/D+ straps.
    - Remap J4 GPIO pins so they route to the CM4 connector without
    crossovers (schematic labels, notes and PCB pad nets).
    - Add decoupling caps C84 (U10) and C85 (U17); add HUB_CTRL net class.
    - Move USB (USB1, USBC1, hub) to the top edge and GPS (U12, CN1, J7) to
    the bottom-left; R4/R5 move with the GPS group. First-pass placement,
    all USB and GPS copper removed for manual routing.
    - Relabel bottom-edge silk text for the SMA connectors.
    - README and usb-power sim note updated for the two-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
2026-10-22 PCB: grow board to 100 mm, rework RoboClaw input protection
    - Extend the board 10 mm at the bottom (y 49.6-149.6). The CM4, its
    mounting holes, H3/H4, GPS, Ethernet, the 5V buck section and the
    RoboClaw I/O connectors with their protection parts move down 10 mm;
    tracks crossing the moved areas get vertical jogs, planes extended.
    - Reconnect 3V3_CM4 at the CM4's right edge and give U19 its own GND via.
    - Move the U18/encoder protection group up and re-route its nets
    (EN1_A/B, EN2_A, encoder inputs, RC_5V, PGND vias).
    - Rotate R48/R50/R52/R54/R55/R56 vertical with the signal pad on top;
    RC_5V pull-ups fed from one bus at y 148.55, IN nets enter at 45 deg.
    - J10/J12/J13 pin labels ver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
2026-10-24 PCB: route USB section and Ethernet, rework ESD flow-through wiring
    USB:
    - Connect C16 and nEXTRST (hub pin 26 to CM4 pin 100 under the module);
    re-route HS_IND to free pin 26; GND via for TP8.
    - Restore 3D models dropped by API rotations; fix USBC1 power pads and
    peg holes and USB1 silkscreen (footprint fixes in parts).
    - U5: HSD2 now flows through pins 4->7 and 5->6; pins 1, 2, 9, 10
    no-connect. U5 rotated and moved to suit.
    Ethernet:
    - U8/U9 N.C. pins carry the line (flow-through, like U6); their sheet
    symbol copy types those pins passive so ERC passes.
    - Place U8/U9 in line with RJ1 pin gaps, C23 on the centre tap.
    - Route all four pairs on ETH_100_OHM (0.11/0.13): outer-row pai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
2026-10-25 PCB: route CHASSIS, fix RJ1 post holes, GPS-area placement edits
    - CHASSIS as an open U around the board edge on B.Cu: H1 (with USB1 and
    USBC1 shields) down the left edge to H4 (R2, C1), along the bottom to
    the RJ1 shield, then on to H3 (and H2 on the right edge). TP2 tied to
    C1. Top edge left open so the chassis doesn't form a loop.
    - RJ1 locating-post holes non-plated (footprint fix in parts).
    - Editor changes: GPS-area placement, LED re-route to R18/R19 near U8,
    R14 back on the top side.
    - usb/ethernet schematics re-saved by KiCad (reorder only).
2026-10-25 PCB: refill zones after chassis routing, C32 label tweak
2026-10-25 PCB: route J4 GPIO header and R8, move EP0/EP1 bundle east
    - Move the EP0/EP1 B.Cu bundle to run east under the CM4 and drop
    straight down at the unused connector pins 61-76 (pairs, vias and
    endpoints unchanged), freeing B.Cu under the GPIO block.
    - J4: CM4 inner-row GPIO/SPI as an F.Cu staircase into the J4 inner
    column; outer-row GPIO/SPI via B.Cu channels and a 7-lane ribbon (clear
    of the CM4 mounting-hole keep-out) into the J4 outer column; GPIO17 and
    I2C1 SCL/SDA via B.Cu into J4.20/22/24; J4.5 tied to 3V3.
    - R8: nPWR_LED from CM4 pin 95.
2026-10-25 PCB: GPS placement and routing, AIP0/AIP1, CM4 GPIO_VREF
    - U12 centred between CN1 and J7 with RF_IN facing CN1; GPS parts regrouped by function
    - GPS routed: 50 ohm RF_IN (new RF_50_OHM net class, 0.18 mm), antenna bias, backup
    charger, VCC and 3V3 feed, UART to R4/R5, PPS/LED, ext-1PPS input via U13, test points
    - F.Cu GND area under U12 stitched to In1
    - GPIO4, GPIO5 and 1PPS routed to the CM4; GPIO20/GPIO1 J4 vias nudged apart for 1PPS
    - AIP0/AIP1 routed to D5/D4; CM4 pin 78 (GPIO_VREF) tied to 3V3; nPWR_LED via moved north
2026-10-25 PCB: route remaining CM4 connections, move status LEDs, defer J4
    - Remove all J4<->CM4 GPIO tracks; J4 will be routed in a later step
    - Route EEPROM_nWP, nPWR_CYCLE, ROBO_RX/TX, BOOT_CONSOLE RXD/TXD,
    PI_nLED_Activity and nPWR_LED; keep F.Cu north of the inner row
    free for the J4 inner-row pins
    - Connect CM4 5V pins 77-87 (bar + 3 vias) and all CM4 GND pins
    - Join the two 3V3_CM4 islands with a 0.5 mm bridge from C85
    - Move LED1/R3/TP3 and LED2/R9/U1/R8/C2/TP7 above RJ1; jog the 3V3
    trunk round J5 (fixes its 0.11 mm clearance to J5 pin 3)
    - D4/D5 GND connection
2026-10-25 Footprint RESC1005X40N: move pin-1 marker to (-0.78, 0.34), new UUIDs
2026-10-26 J4 outer row to GND, route SPI0 CE0/CE1, PCB review fixes
    Schematic: J4 pins 6, 8, 10, 16, 18 (GPIO21, GPIO20, GPIO1, GPIO23,
    GPIO18) are now GND; CM4 pins 25, 27, 35, 47, 49 get no-connect flags.
    The five labels, wires and CM4_Connectors sheet pins are removed.
    PCB: J4 pad nets updated to match, SPI0_CE0 and SPI0_CE1 routed to the
    CM4, the 11 inner J4 nets restored.
    Review fixes:
    - PGND: solid zone connections on In1 for J1 pin 2 and the RoboClaw
    BAT- pins (were thermal spokes carrying the motor return).
    - FUSE_IN: zone outlines widened below the fuse pads so the Q1 source
    arm is ~4 mm instead of 1.2 mm; two more 1.0 mm vias.
    - HD2 pair rerouted as a coupled pair on B.Cu through the U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
2026-10-26 PCB: RF_IN parts on the line, CN1 -> J2, test point fixes, J15/J16 on A1
    - D15 and L1 moved beside the vertical RF_IN run; the 3.8 mm branch is
    gone, bias track re-routed to C36, labels re-placed (TP23 label moved).
    - CN1 (GPS antenna SMA) renamed J2 in the schematic, GPS sheet note and
    PCB, matching the J prefix used for every other connector.
    - TP22 removed from the schematic and PCB (redundant GND point beside
    TP19); TP19 moved next to D15 with a ground track.
    - TP9 (U4 ILIM) and TP10 (GND) moved to the bottom side under U4; the
    ILIM net drops from 30 mm with two vias to 3.1 mm with one.
    - J15/J16 RoboClaw sockets moved onto A1's power and signal hole rows
    (they were left behind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
2026-10-27 PCB: outer-layer ground fills with stitching vias, extra ground vias
    - GND (logic half) and PGND (RoboClaw half) fill zones on F.Cu and B.Cu,
    following the In1 split so the grounds meet only at NT1. Priority 0
    (below every existing pour), 0.5 mm clearance, solid pad connection.
    RJ1_void_outer keeps pour out of the RJ45 cable end on the outer layers.
    - 423 stitching vias (0.6/0.3, free): ~4 mm grid on GND, ~5 mm on PGND,
    plus a gap-filling pass; none in SMD pads or connector/battery/switch/
    fuse-holder courtyards.
    - Ground vias at the buck input/output capacitors (C42-C44, C47, C49,
    C50, shared C52/C53) and two PGND vias each at the D1/D3 TVS anodes.
    - KiPI power-integrity setup: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
2026-10-28 Added I2C and battery 3d file
2026-10-29 Update with I2C and new images
2026-10-29 Updated schematic PDF
2026-11-01 New encoder design
2026-11-01 PCB Layout with new encoder inputs and jumpers.
2026-11-01 I2C pull up revised
2026-11-04 PCB refinements
2026-11-06 Added mounting hole H7 in case user wants to create a HAT.
2026-11-07 Add PTC fuses on USB-C VBUS sense and the encoder 5 V option
    USB-C sheet: F5 (50 mA PTC) between USBC1 VBUS and the D24 / R59 / TP28
    sense node, so a short there trips F5 instead of relying on the USB
    source limit. Connector-side net is VBUS_USBC. Note rewritten.
    RoboClaw sheet: F6 / F7 (200 mA PTC) between RC_5V and JP1 / JP4 pin 1,
    so a shorted or miswired encoder cable on the 5 V setting cannot drag
    down the RoboClaw BEC, which also feeds its logic. The 3.3 V and 12 V
    options already had F3 / F4. Note added; jumper table, budget note and
    motor-notes wiring text updated.
    Board: F5 east of USBC1 with a bottom-layer link to D24; F7 west of JP4
    with the trunk looped under pin 1; F6 under JP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
2026-11-08 Added some suggested fuses and D29
